evolutek/carte-io-raspberry-pi/CarteIO Beacon V1/Board.step

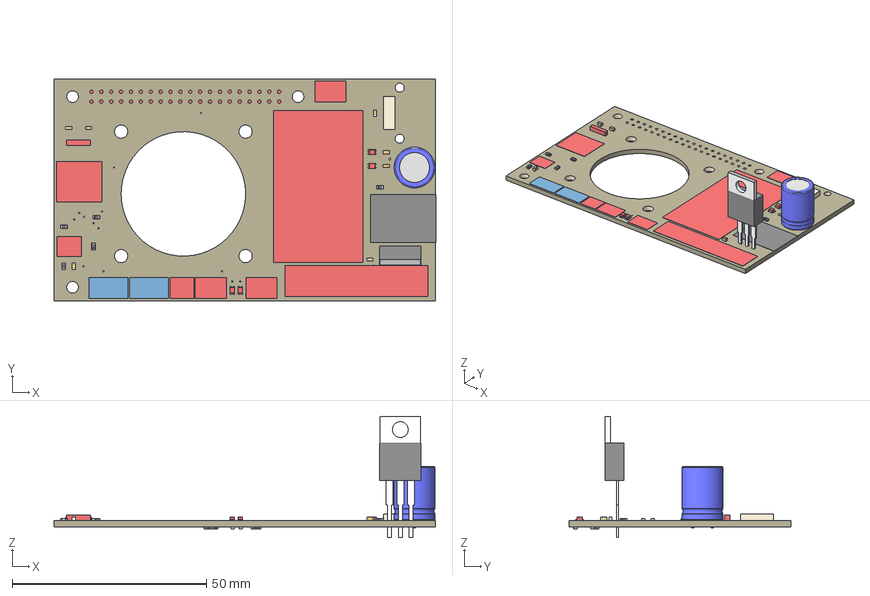
[picture p1: CAD file, 2020-09-04, an earlier design]
CarteIO Beacon V1/Board.step
98.2 x 57.0 x 31.2 mm
Board
GREEN x 4
330uF
100nF x 5
FUSE
JST2
JST4 x 2
JST3 x 3
16MHz
J1
PTN78020WAD
MCP2515-I/SO
MCP2551-I/SN
PN87520
MBR60H100CTG
