evolutek/carte-io-raspberry-pi/Carte IO Coffee Pot V1/Output/Schematics.pdf

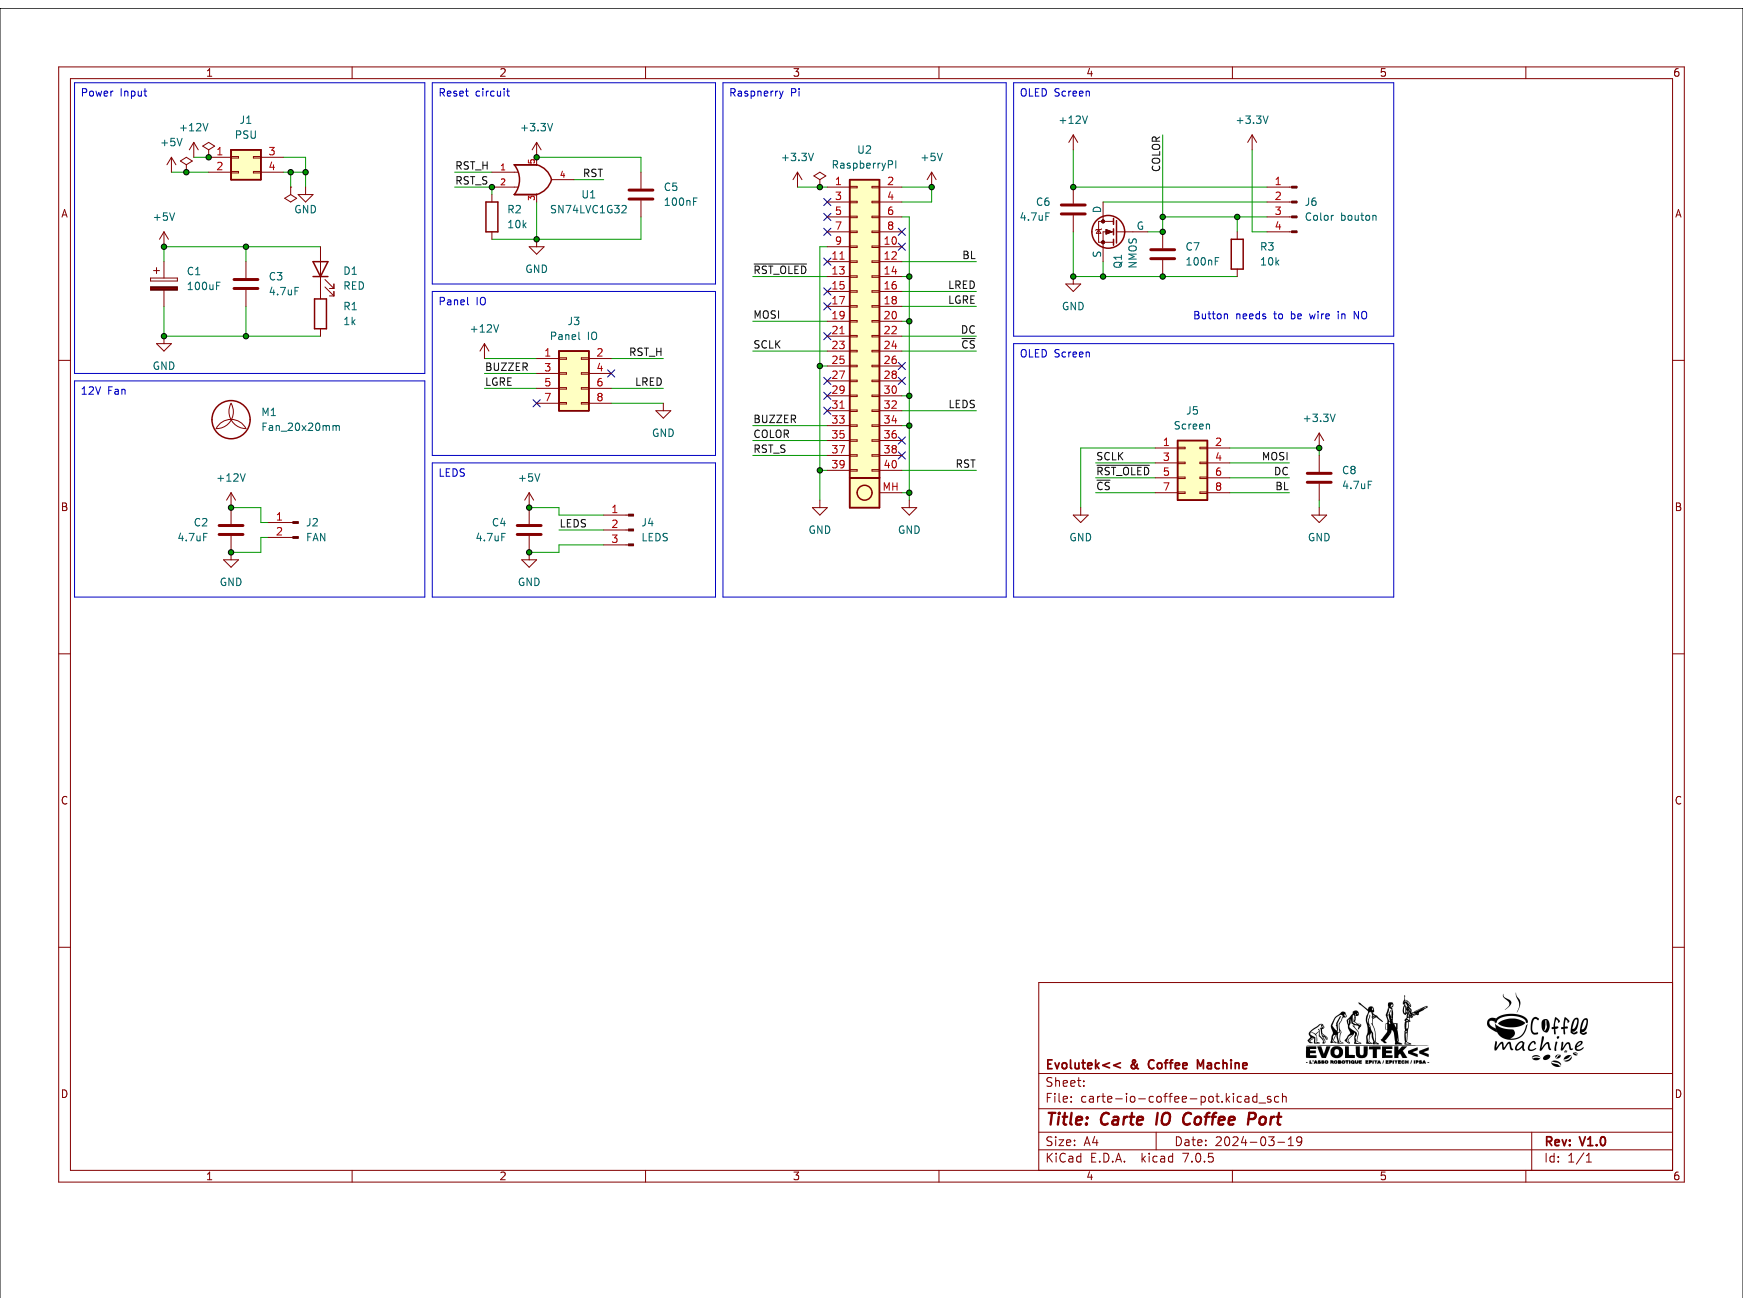
[picture p2: page 1]
