evolutek/carte-io-raspberry-pi/CarteIO V6/Output/Schematics.pdf

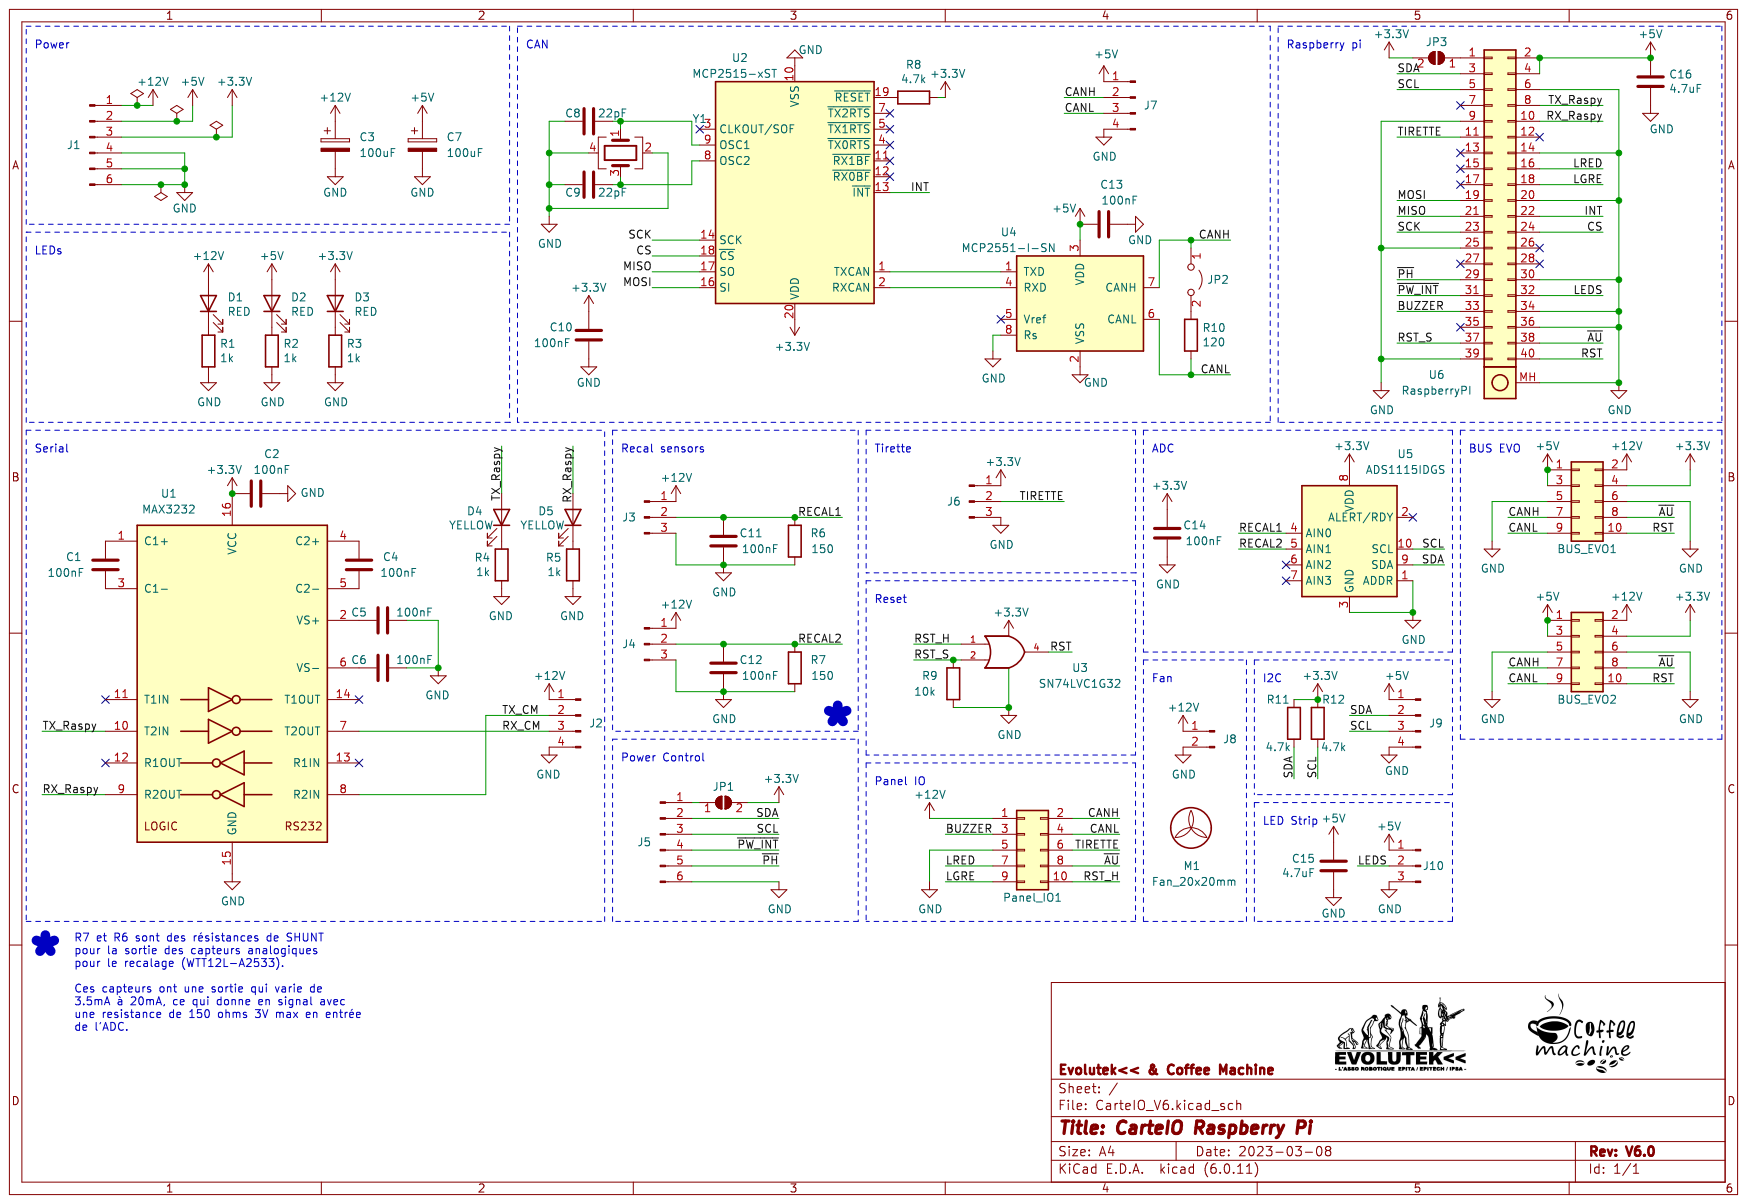
[picture p3: page 1]
