evolutek/carte-io-raspberry-pi/Carte IO Coffee Pot V1/Output/Board-Front.pdf

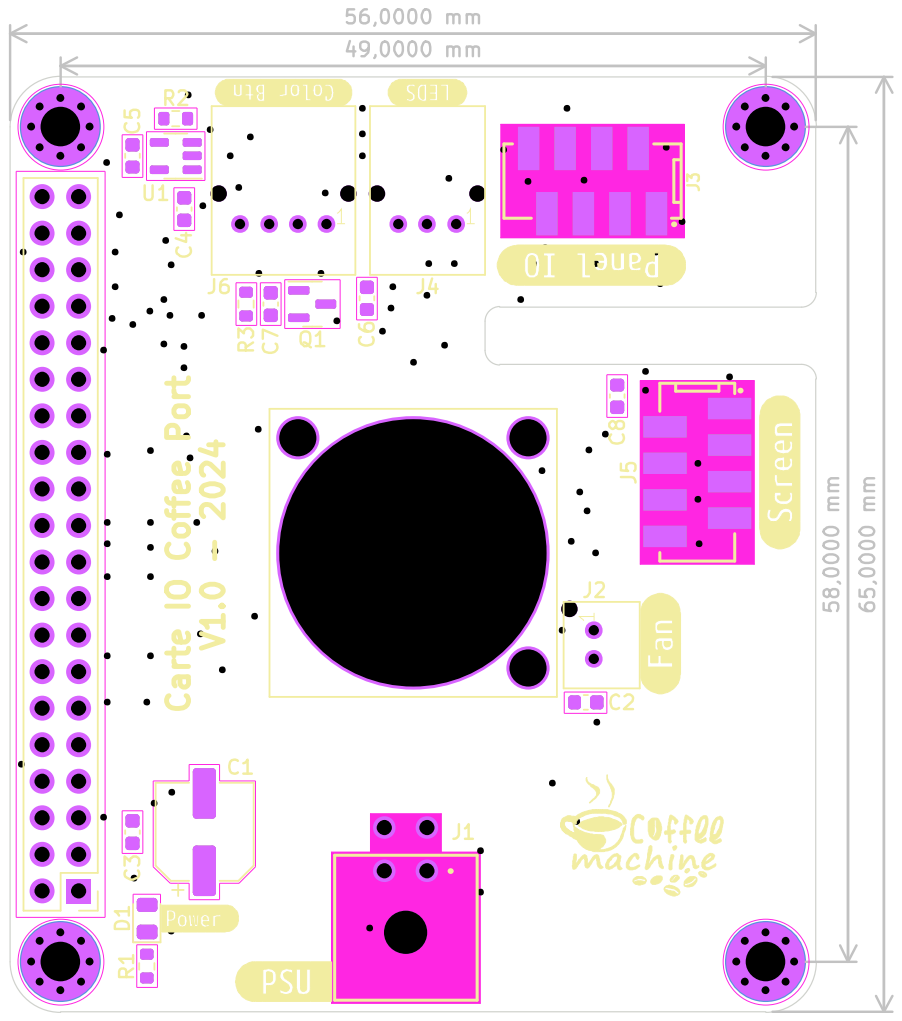
[picture p4: page 1]
