evolutek/carte-io-raspberry-pi/CarteIO V6/Output/Board-Back.pdf

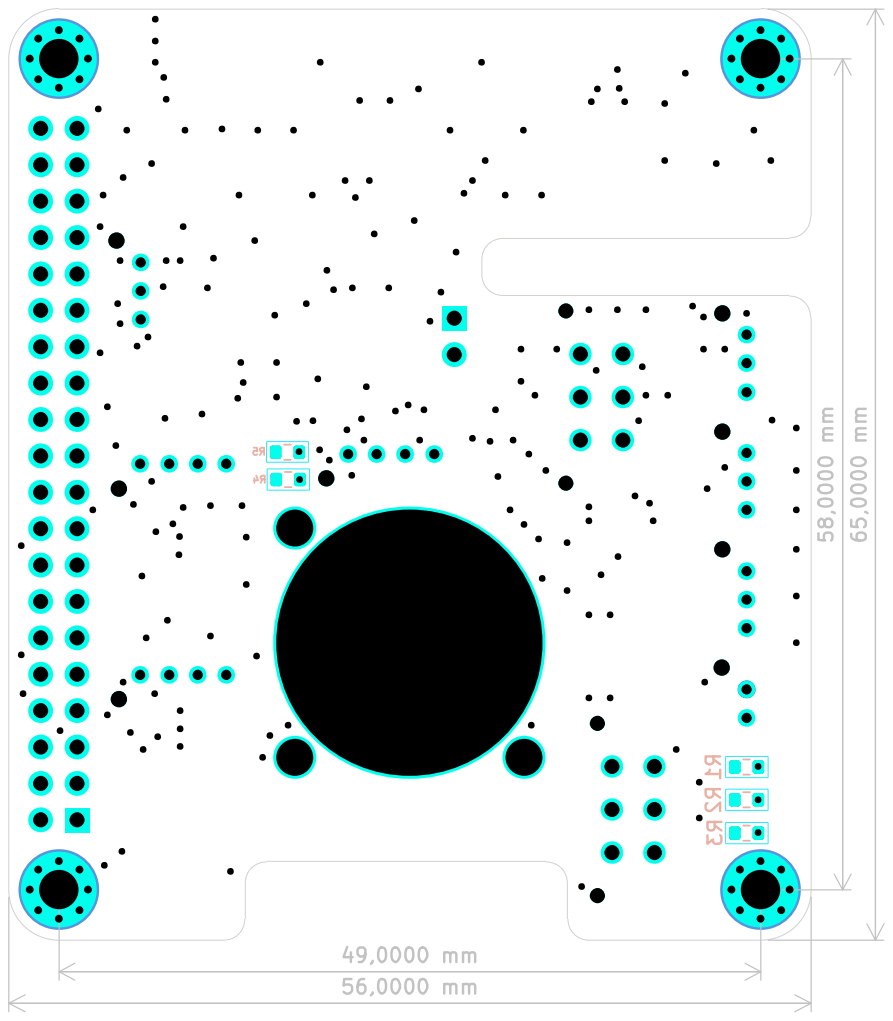
[picture p5: page 1]
