evolutek/carte-io-raspberry-pi/CarteIO Beacon V1/Schematics.pdf

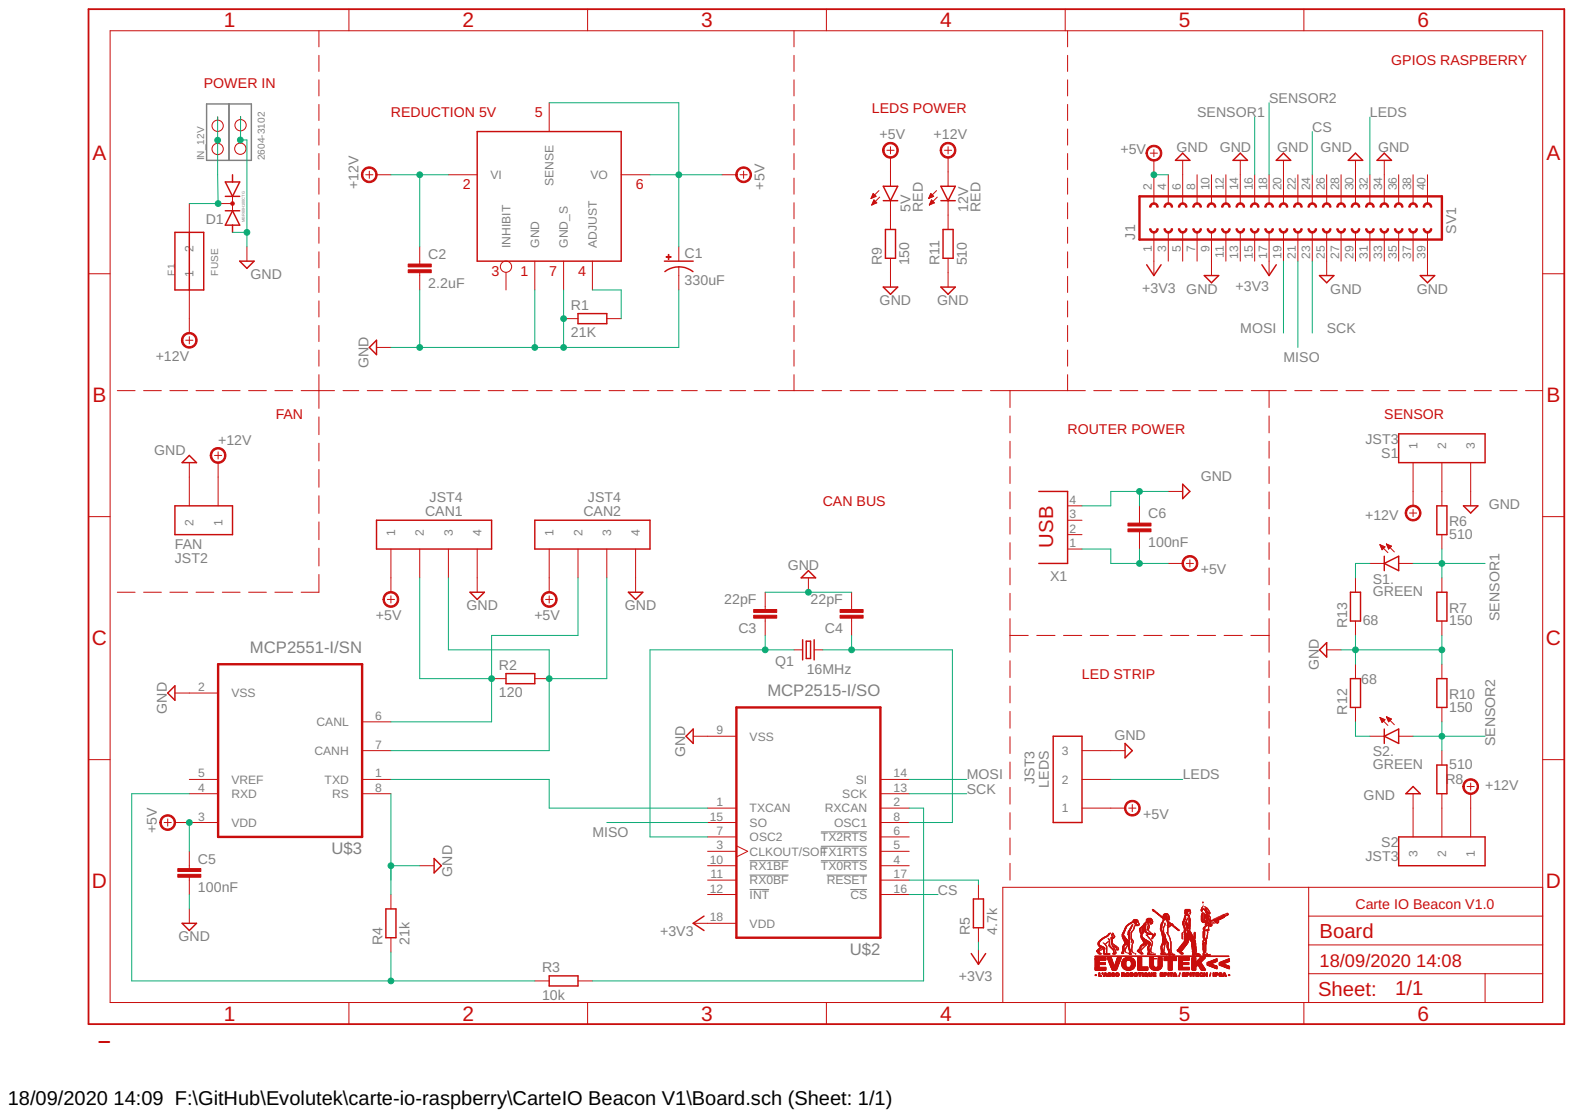
[picture p6: page 1]

SENSOR2

J1 GND GND GND GND

18/09/2020 14:09 F:\GitHub\Evolutek\carte-io-raspberry\CarteIO Beacon V1\Board.sch (Sheet: 1/1)
