evolutek/carte-io-raspberry-pi/CarteIO V3/Schematics.pdf

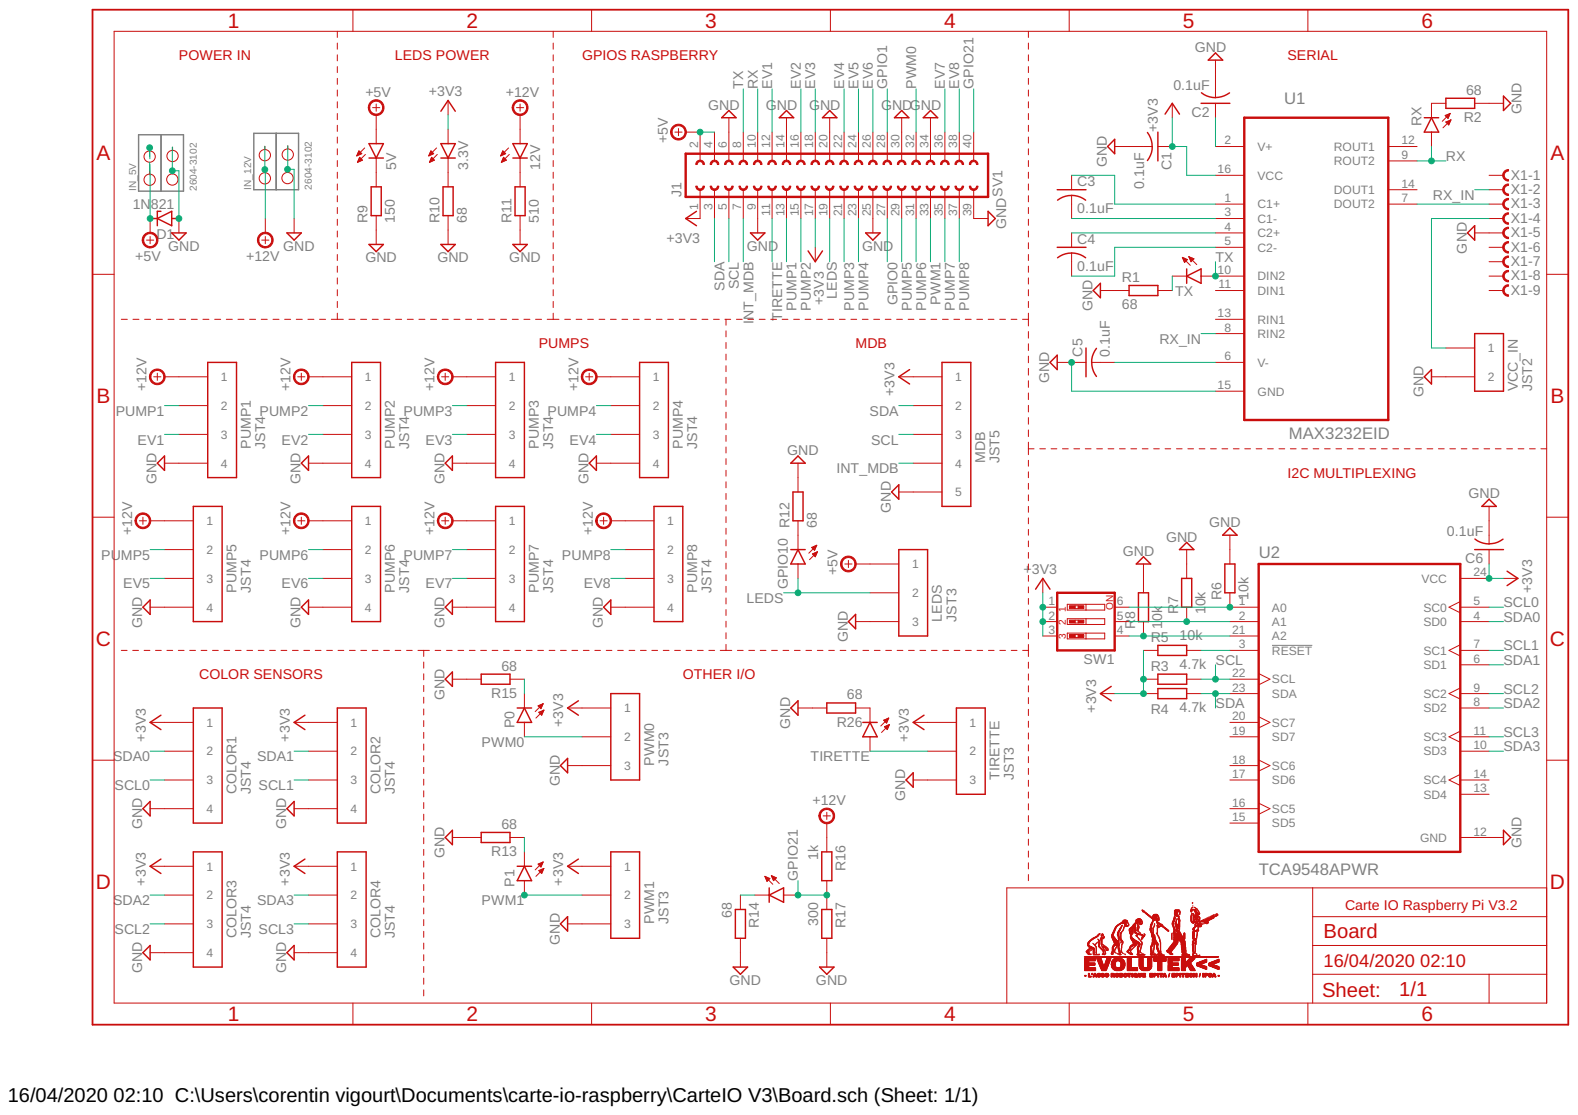
[picture p7: page 1]

GND POWER IN LEDS POWER GPIOS RASPBERRY | SERIAL

16/04/2020 02:10 C:\Users\corentin vigourt\Documents\carte-io-raspberry\CarteIO V3\Board.sch (Sheet: 1/1)
