evolutek/carte-io-raspberry-pi/CarteIO V2/Documentation/Schematics.pdf

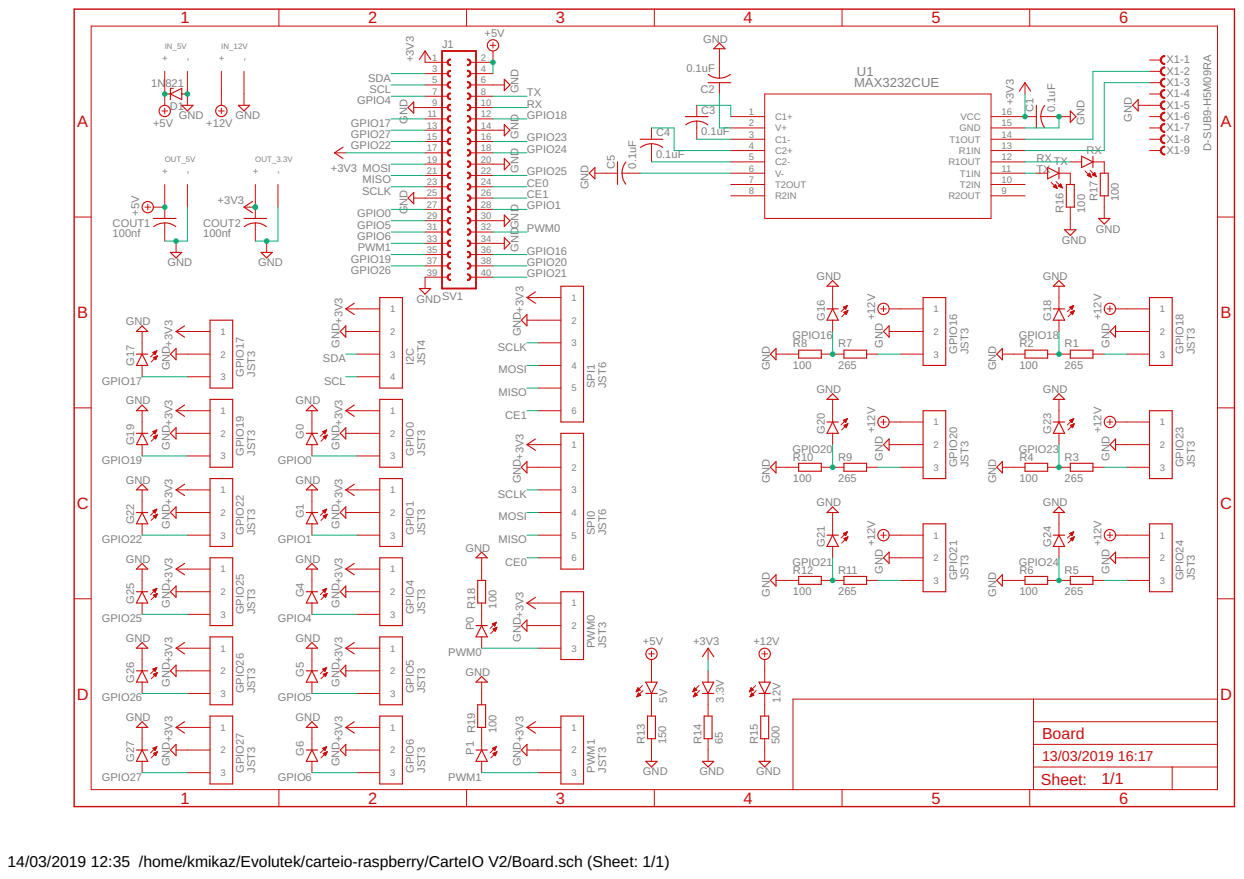
[picture p8: page 1]

GND GND

14/03/2019 12:35 /home/kmikaz/Evolutek/carteio-raspberry/CarteIO V2/Board.sch (Sheet: 1/1)
