evolutek/carte-io-raspberry-pi/CarteIO Beacon V1/Board.pdf

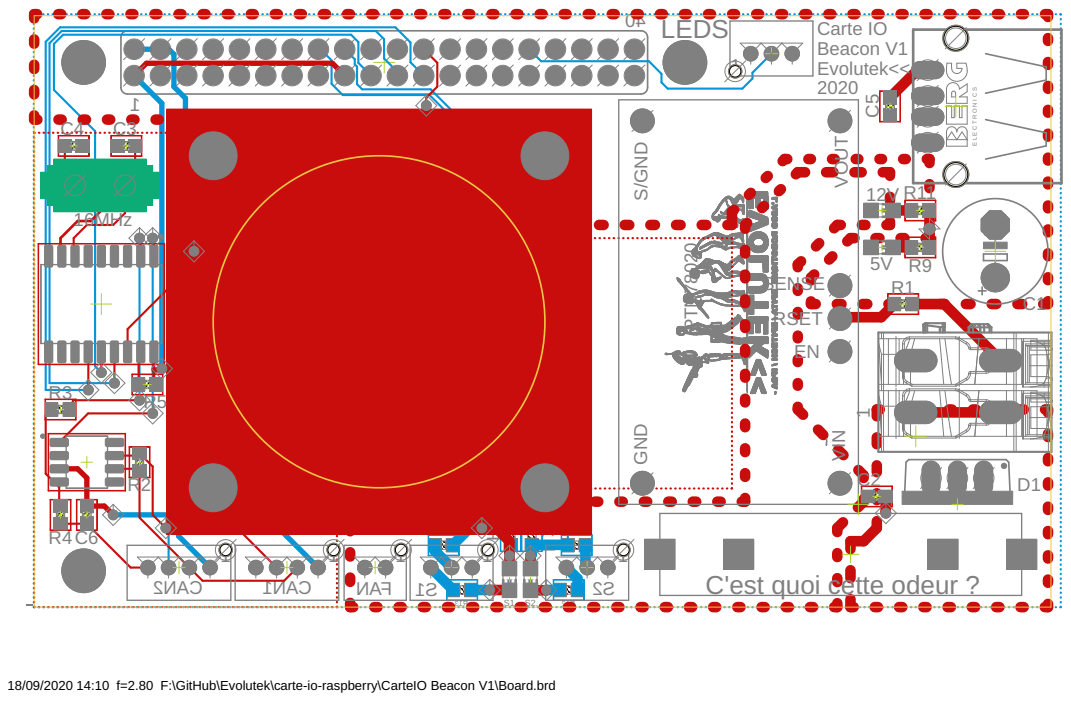
[picture p9: page 1]

C'est quoi cette odeur ?

18/09/2020 14:10 f=2.80 F:\GitHub\Evolutek\carte-io-raspberry\CarteIO Beacon V1\Board.brd
