evolutek/carte-io-raspberry-pi/CarteIO V3/Board.pdf

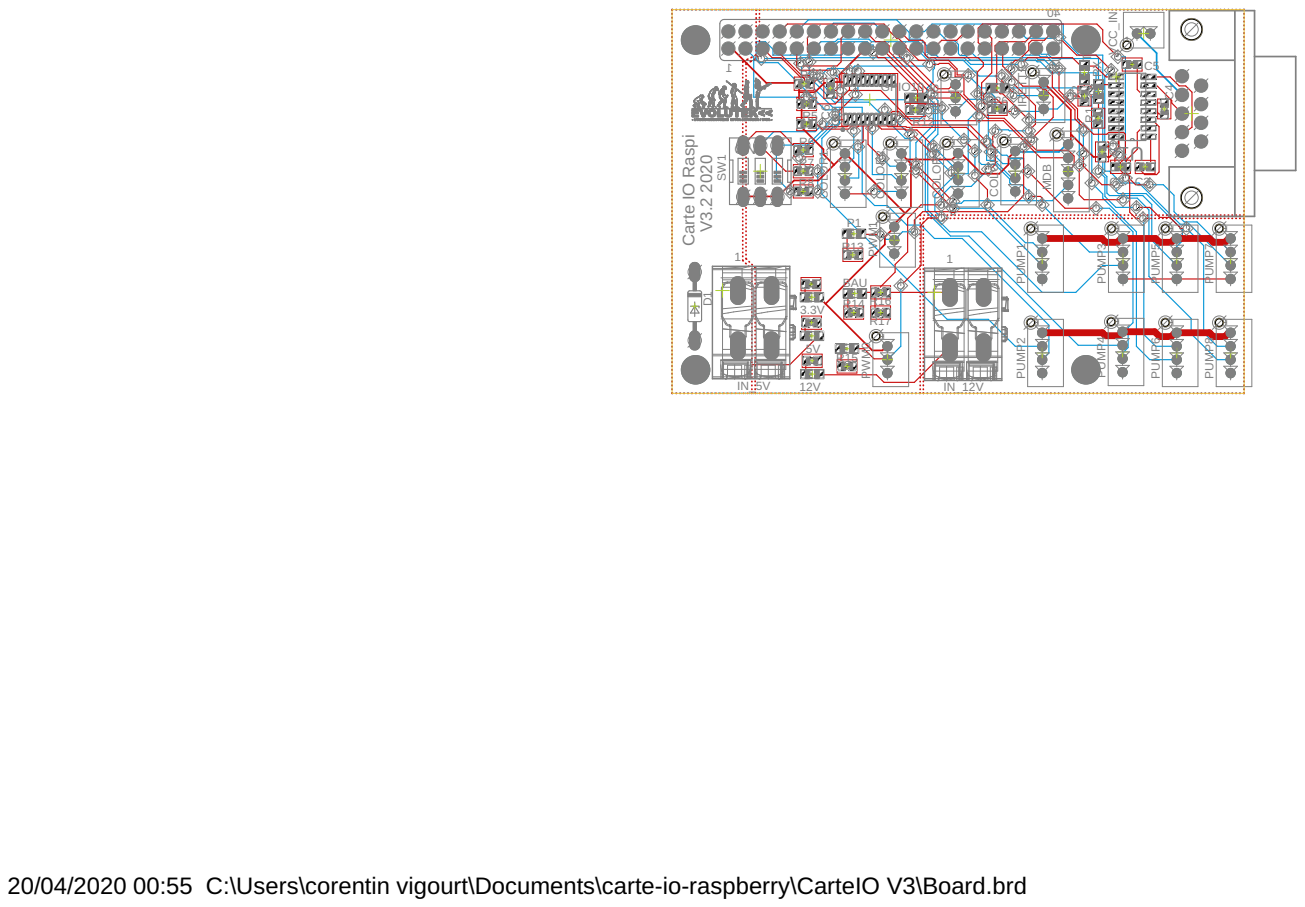
[picture p10: page 1]

20/04/2020 00:55 C:\Users\corentin vigourt\Documents\carte-io-raspberry\CarteIO V3\Board.brd
