evolutek/carte-io-raspberry-pi/CarteIO Beacon V2/Schematics.pdf

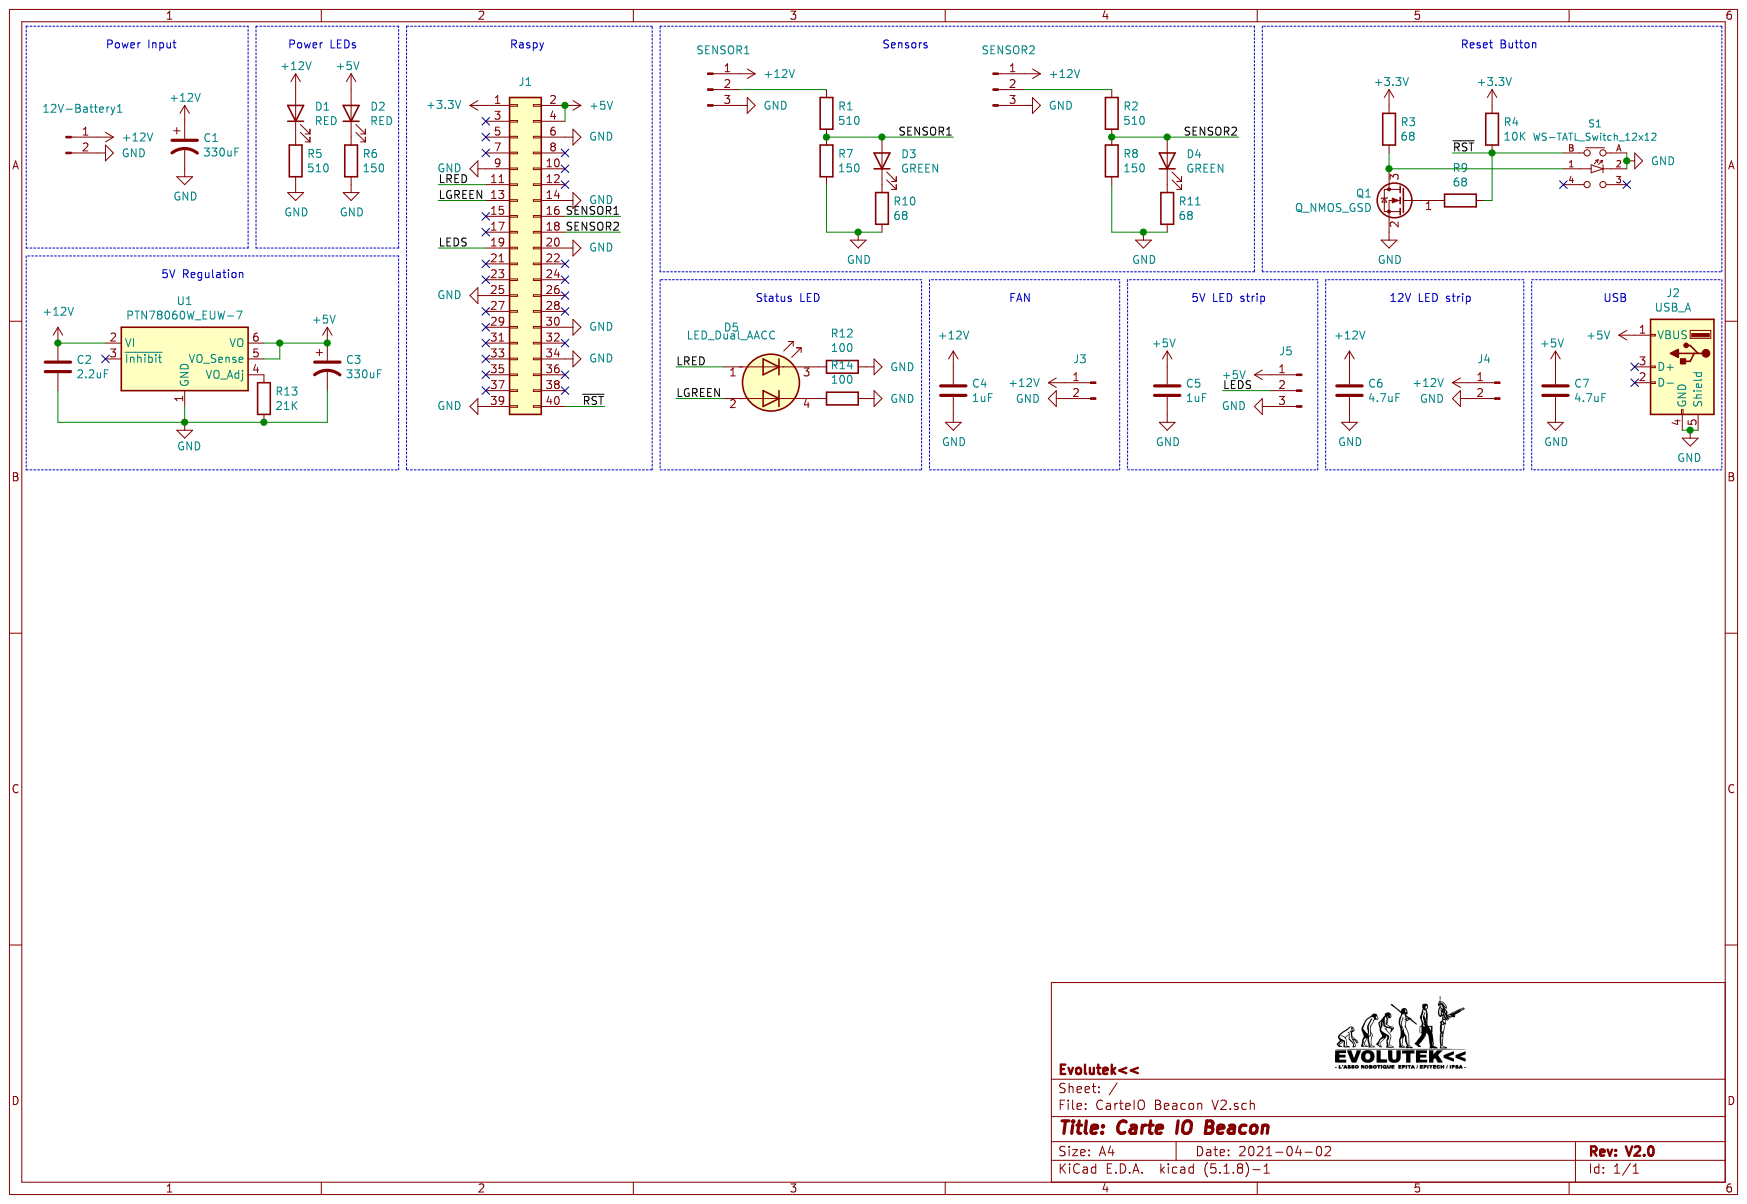
[picture p11: page 1]
