evolutek/carte-io-raspberry-pi/CarteIO V4/Schematics.pdf

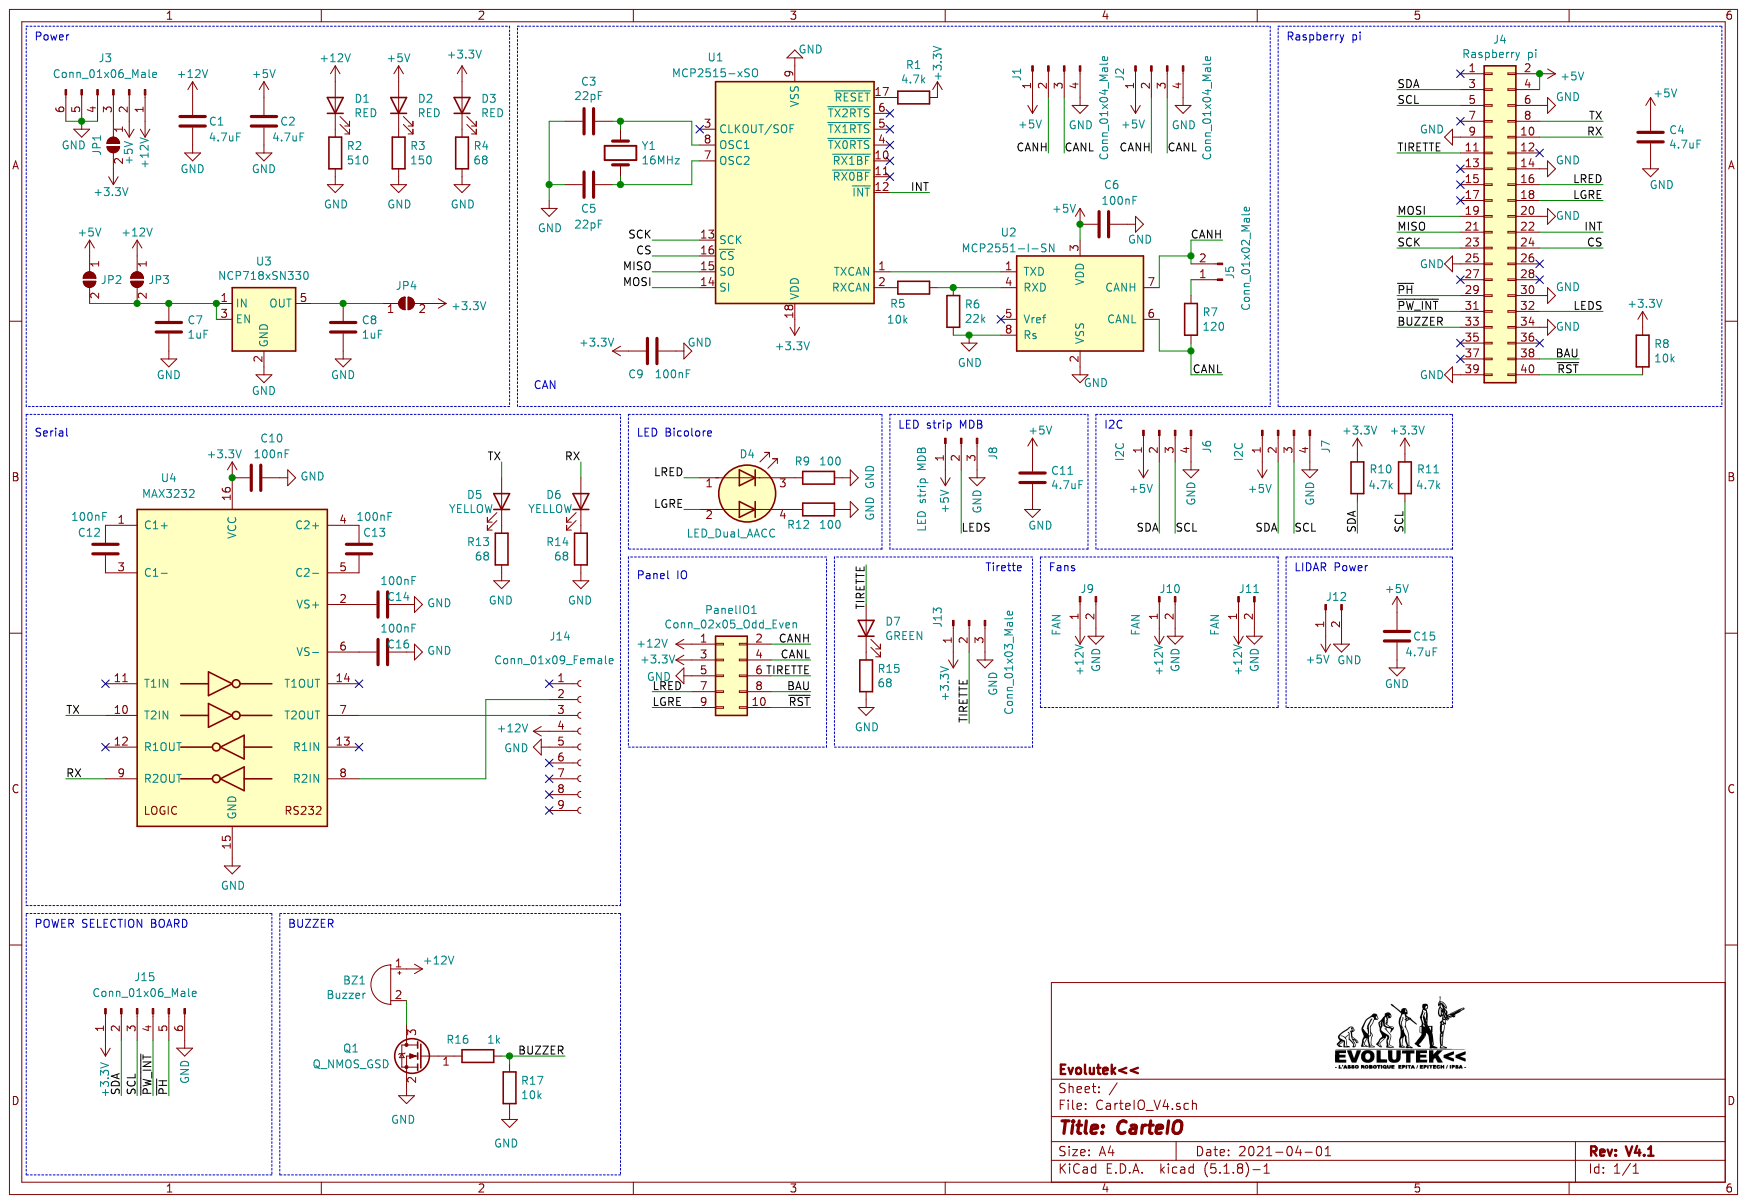
[picture p12: page 1]
