evolutek/carte-io-raspberry-pi/CarteIO Beacon V3/Output/Schematics.pdf

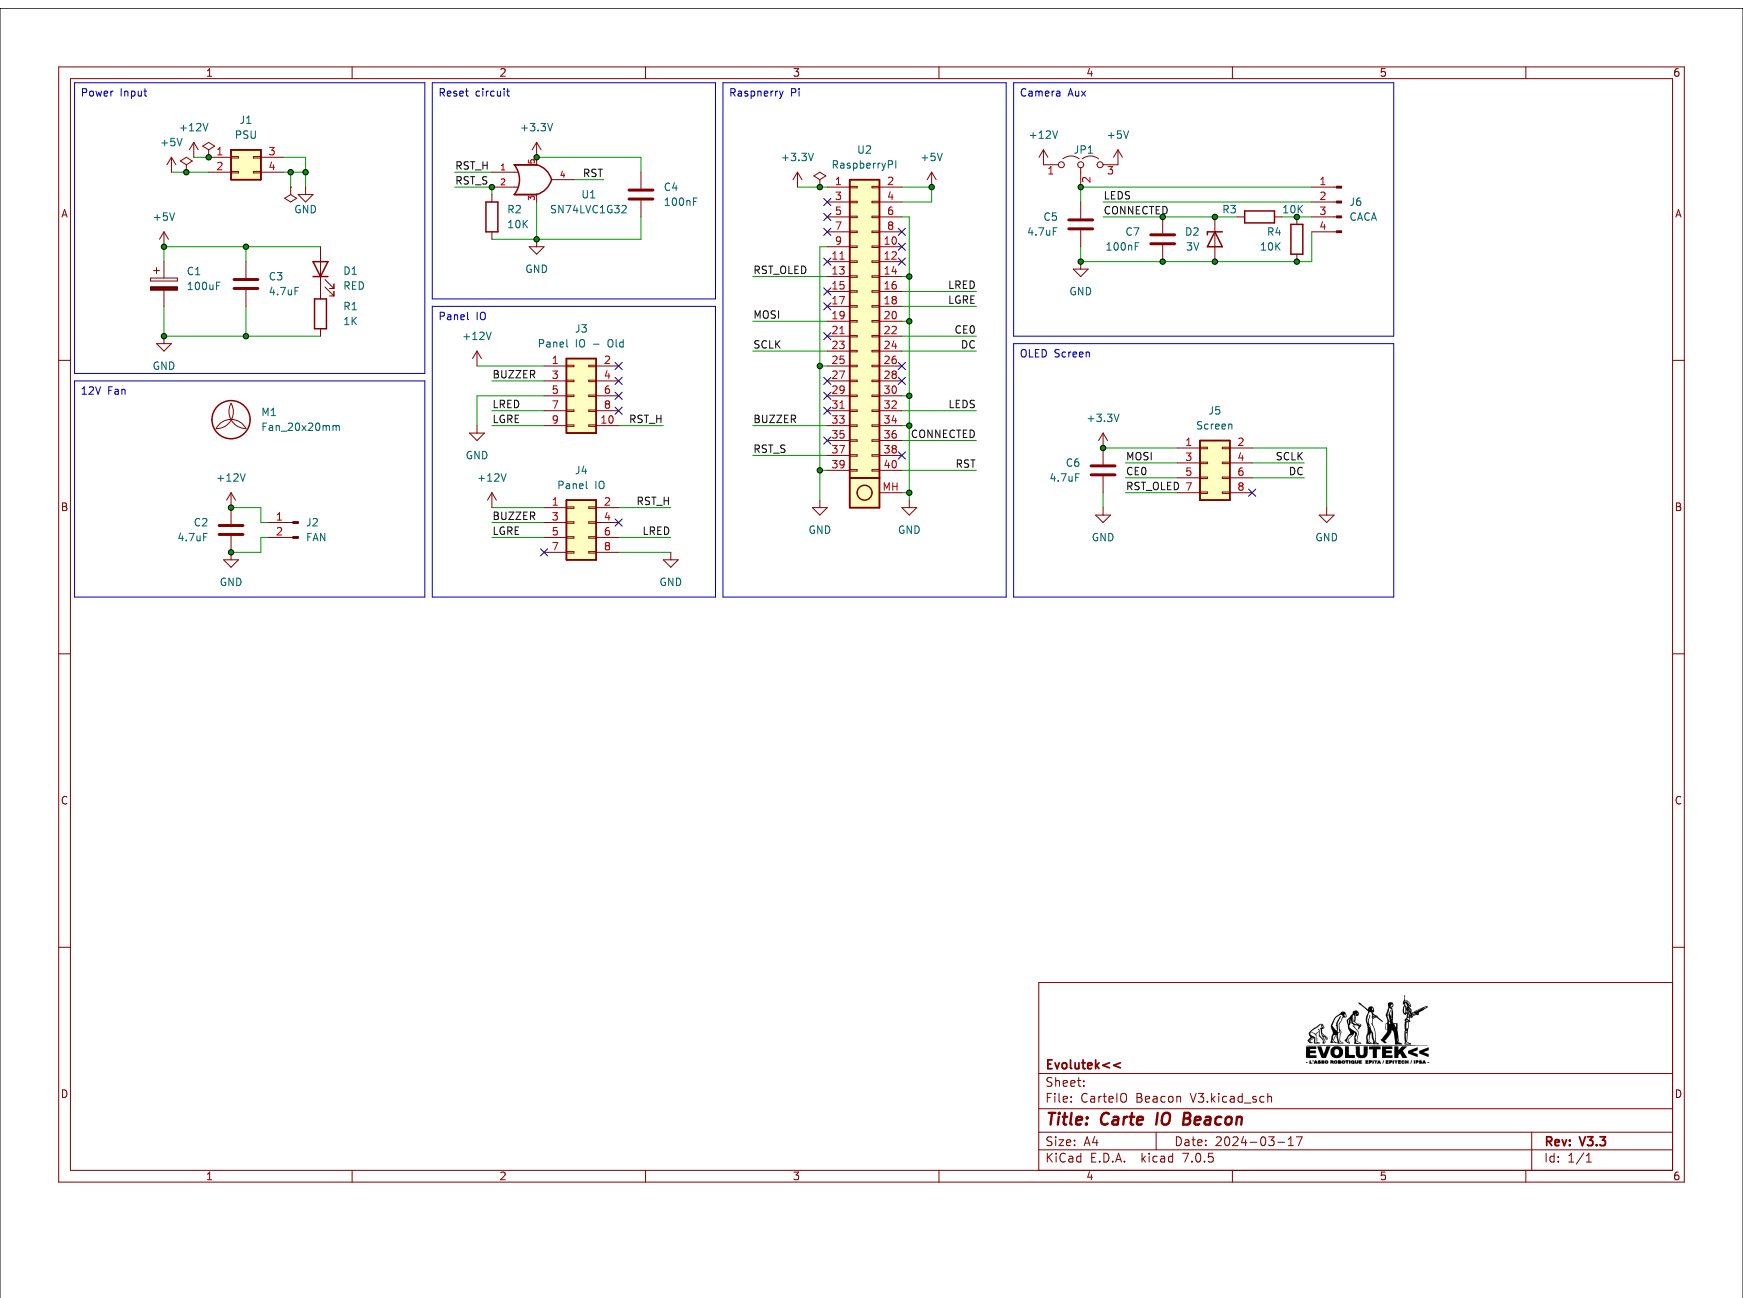
[picture p13: page 1]
