evolutek/carte-io-raspberry-pi/CarteIO V5/Output/Schematics.pdf

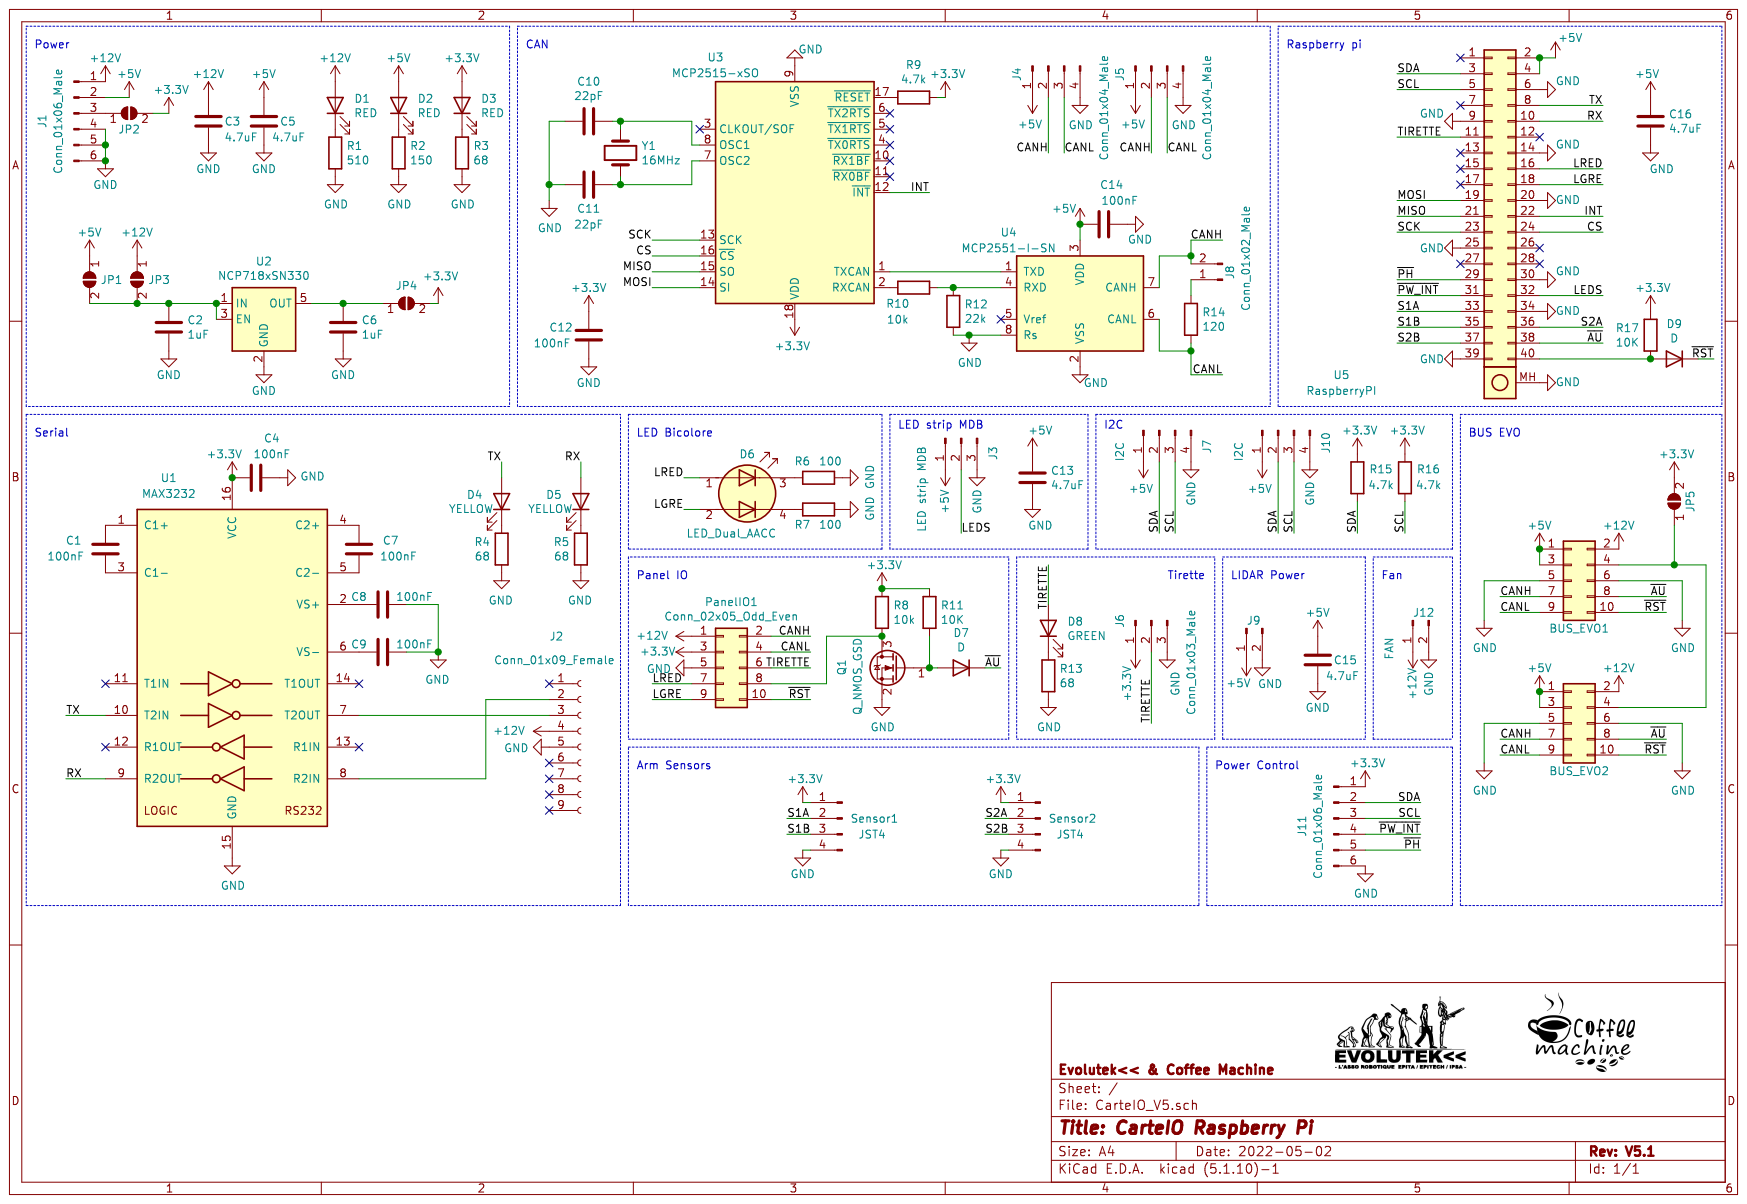
[picture p14: page 1]
