evolutek/carte-io-raspberry-pi/CarteIO Beacon V3/Output/Board-Front.pdf

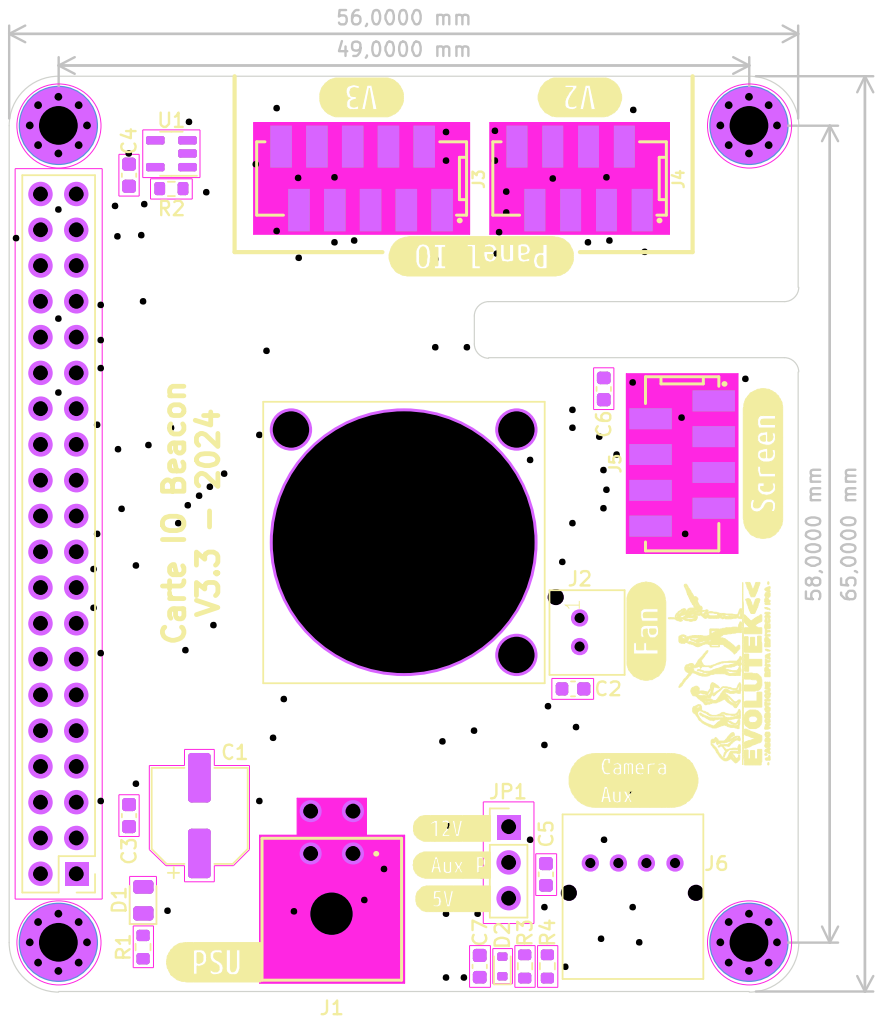
[picture p15: page 1]
