evolutek/carte-io-raspberry-pi/CarteIO V5/Output/Board-Back.pdf

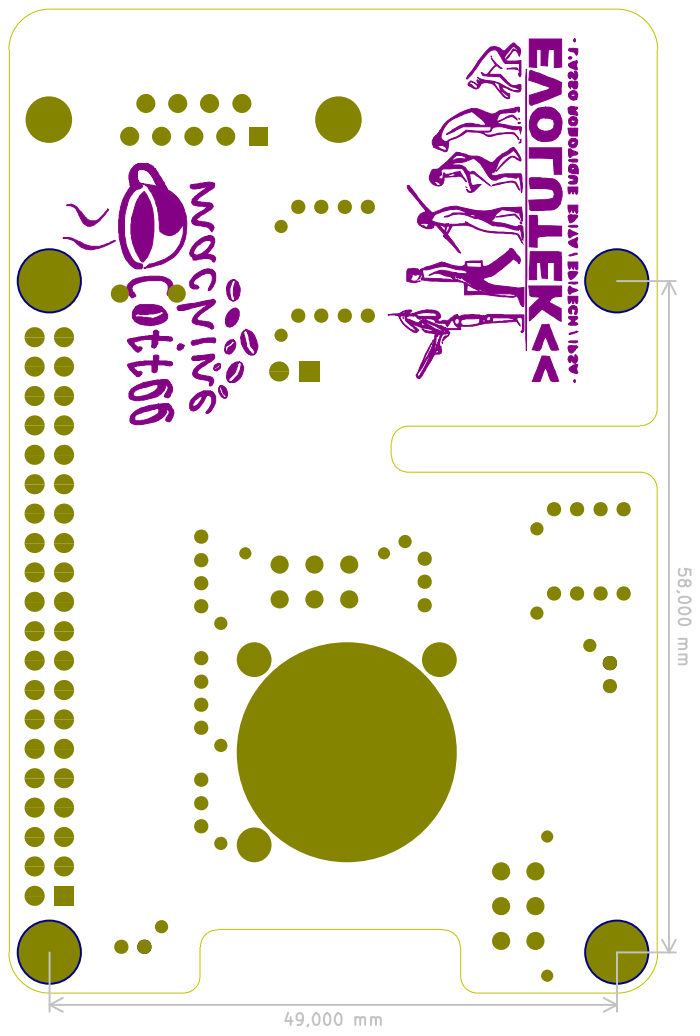
[picture p16: page 1]
