evolutek/carte-io-raspberry-pi/CarteIO V5/Output/Board-Front.pdf

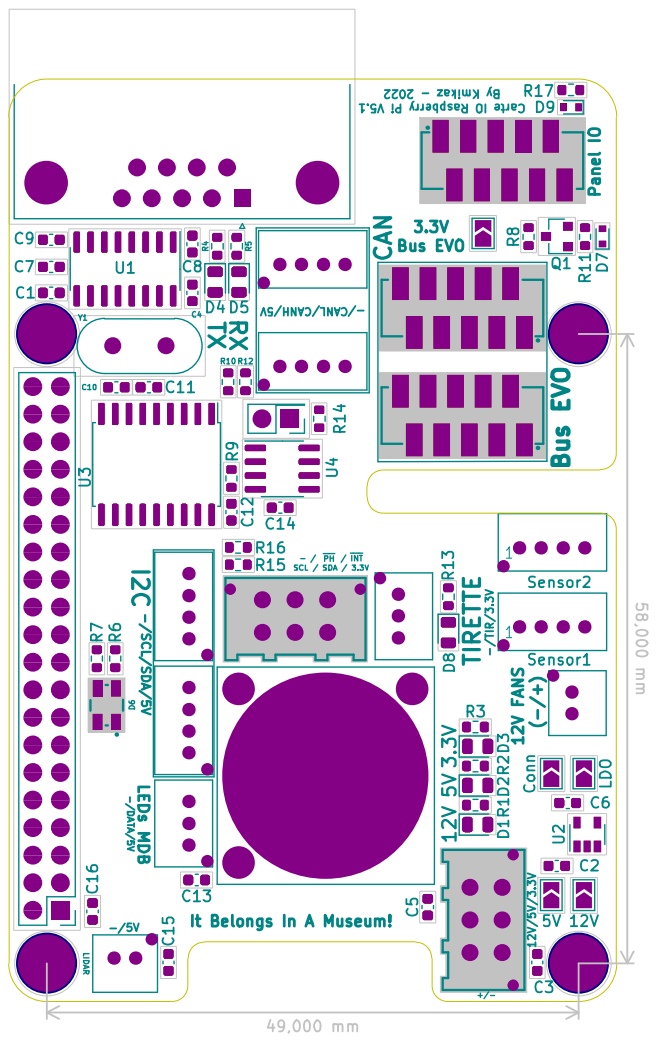
[picture p17: page 1]
