evolutek/carte-io-raspberry-pi/Carte IO Coffee Pot V1/carte-io-coffee-pot.kicad_pcb

## KiCad design Carte IO Coffee Pot V1/carte-io-coffee-pot.kicad_pcb (2024-12-13)

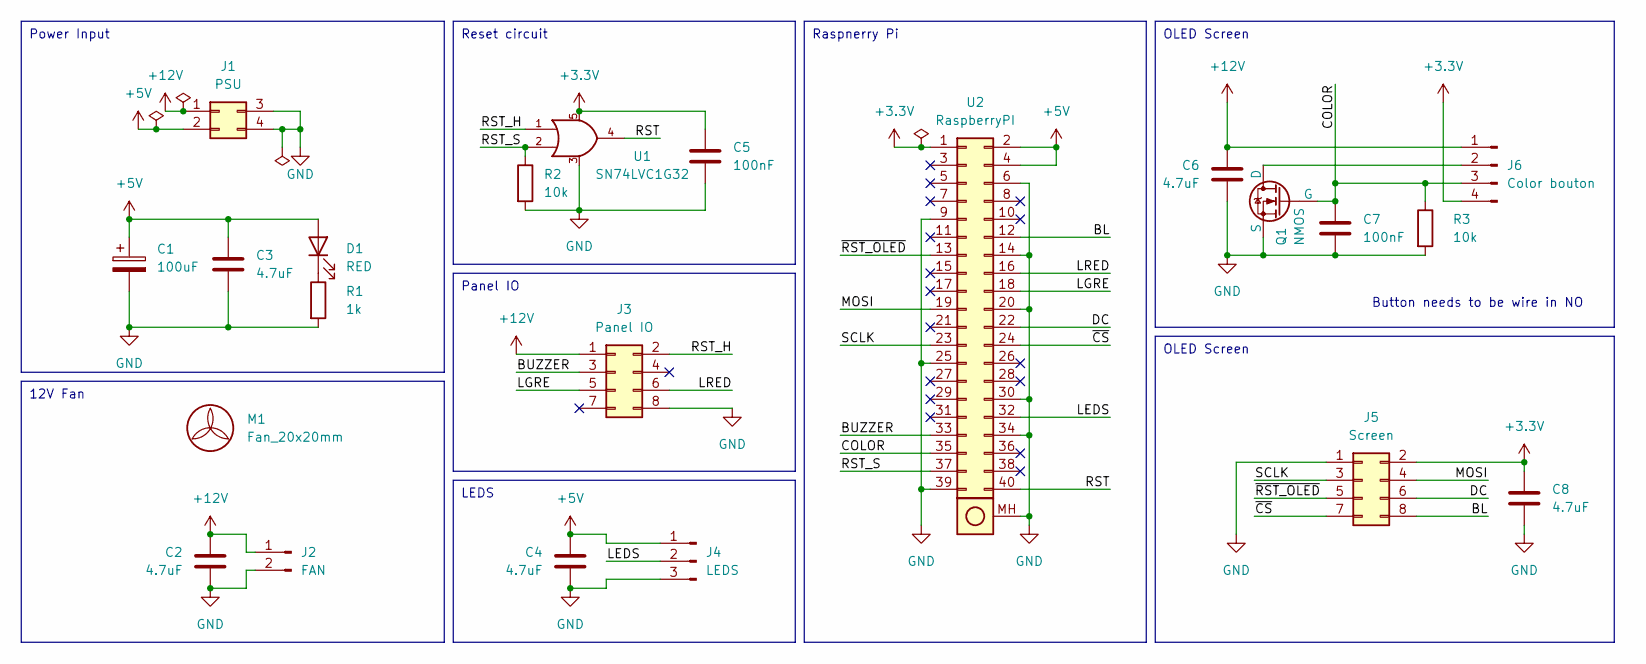
[picture p18: schematic carte-io-coffee-pot.kicad_sch, Carte IO Coffee Port]

Parts:
C1: 100uF; CP_Elec_6.3x7.7
C2, C3, C4, C6, C8: 4.7uF; C_0603_1608Metric
C5, C7: 100nF; C_0603_1608Metric
D1: RED; D_0805_2012Metric
J1: PSU; 66200421022
J2: FAN; B02B-PASK
J3: Panel IO; 690367280876
J4: LEDS; S03B-PASK
J5: Screen; 690367280876
J6: Color bouton; S04B-PASK
M1: Fan_20x20mm; 20x20x10_DC_FAN
Q1: NMOS; SOT-23
R1: 1k; R_0603_1608Metric
R2, R3: 10k; R_0603_1608Metric
U1: SN74LVC1G32; SOT-23-5
U2: RaspberryPI; Shield_Raspberry_Pi_with_11mm_Header

Connections:
+3.3V: C5.2, C8.2, J5.2, J6.4, U1.5 (VCC), U2.1
+5V: C1.1, C3.2, C4.2, D1.2 (A), J1.2, J4.1, U2.2, U2.4
+12V: C2.2, C6.2, J1.1, J2.1, J3.1, J6.1
/BL: J5.8, U2.12
/BUZZER: J3.3, U2.33
/COLOR: C7.2, J6.3, Q1.2 (G), R3.1, U2.35
/DC: J5.6, U2.22
/LEDS: J4.2, U2.32
/LGRE: J3.5, U2.18
/LRED: J3.6, U2.16
/MOSI: J5.4, U2.19
/RST: U1.4 (S), U2.40
/RST_H: J3.2, U1.1 (A)
/RST_S: R2.1, U1.2 (B), U2.37
/SCLK: J5.3, U2.23
/~CS: J5.7, U2.24
/~RST_OLED: J5.5, U2.13
GND: C1.2, C2.1, C3.1, C4.1, C5.1, C6.1, C7.1, C8.1, J1.3, J1.4, J2.2, J3.8, J4.3, J5.1, Q1.3 (S), R1.2, R2.2, R3.2, U1.3 (GND), U2.6, U2.9, U2.14, U2.20, U2.25, U2.30, U2.34, U2.39, U2.MH (MountingHoles)
unnamed: D1.1 (K), R1.1
unnamed: J6.2, Q1.1 (D)

Notes on the sheet:
Reset circuit
LEDS
OLED Screen
12V Fan
Power Input
Panel IO
Raspnerry Pi
Button needs to be wire in NO

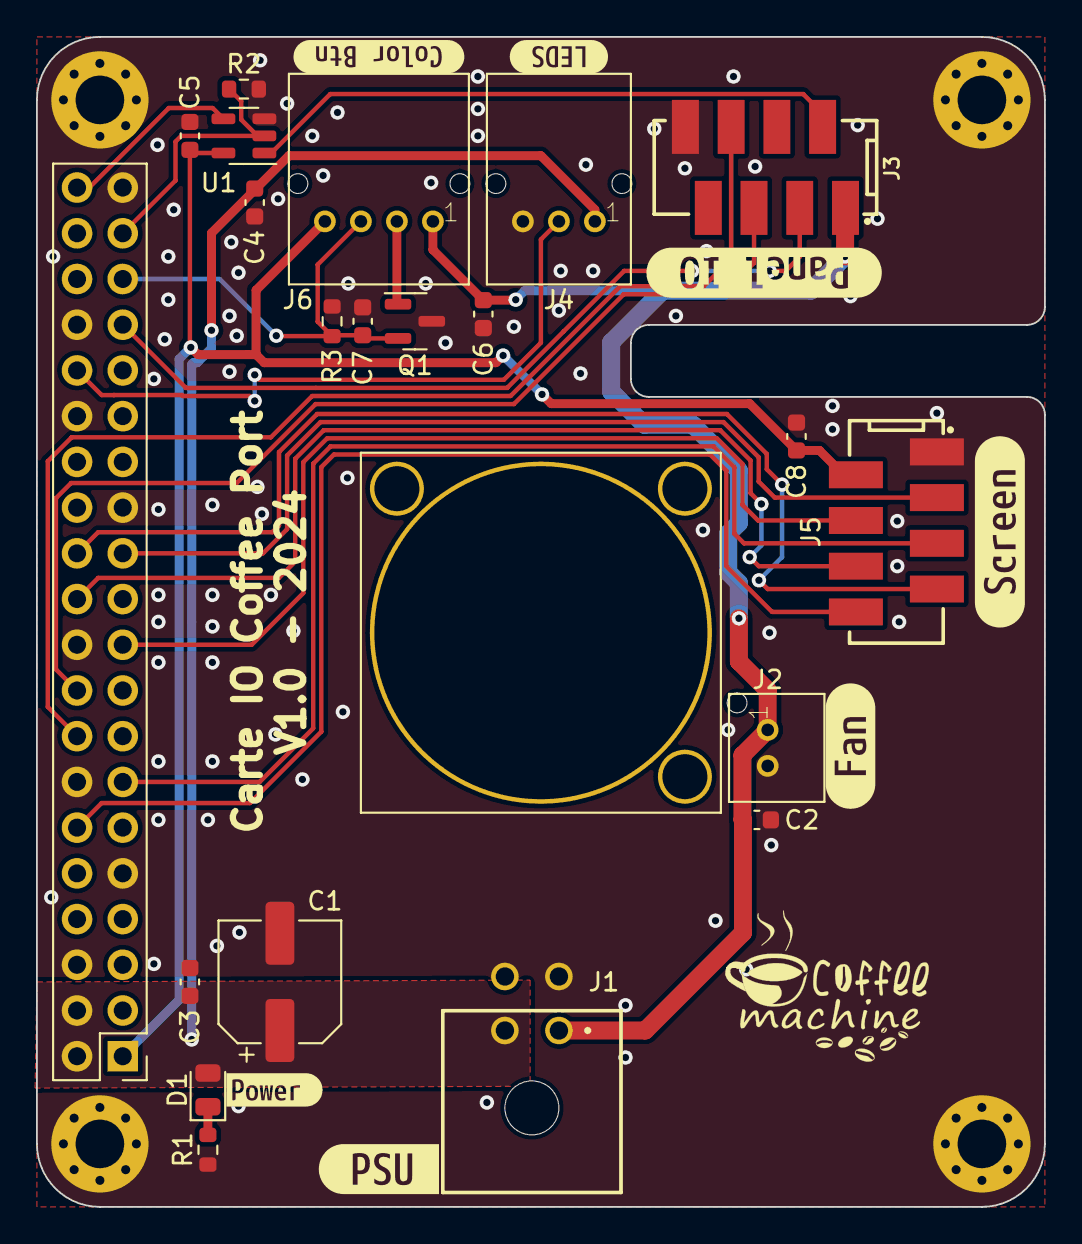
[picture p19: board carte-io-coffee-pot.kicad_pcb from above]

Board: 2 copper layers, 56.0 x 65.0 mm, 29 parts (0 on the bottom side), 20 nets.

Other parts of the board:
kibuzzard-65F8CF4B: G***; kibuzzard-65F8CF4B
kibuzzard-65F8CFA1: G***; kibuzzard-65F8CFA1
kibuzzard-65F8CFB9: G***; kibuzzard-65F8CFB9
kibuzzard-65F478A9: G***; kibuzzard-65F478A9
kibuzzard-65F478C7: G***; kibuzzard-65F478C7
kibuzzard-65F478FE: G***; kibuzzard-65F478FE
kibuzzard-65F47805: G***; kibuzzard-65F47805
