evolutek/carte-io-raspberry-pi/CarteIO Beacon V3/CarteIO Beacon V3.kicad_pcb

## KiCad design CarteIO Beacon V3/CarteIO Beacon V3.kicad_pcb (2024-08-19)

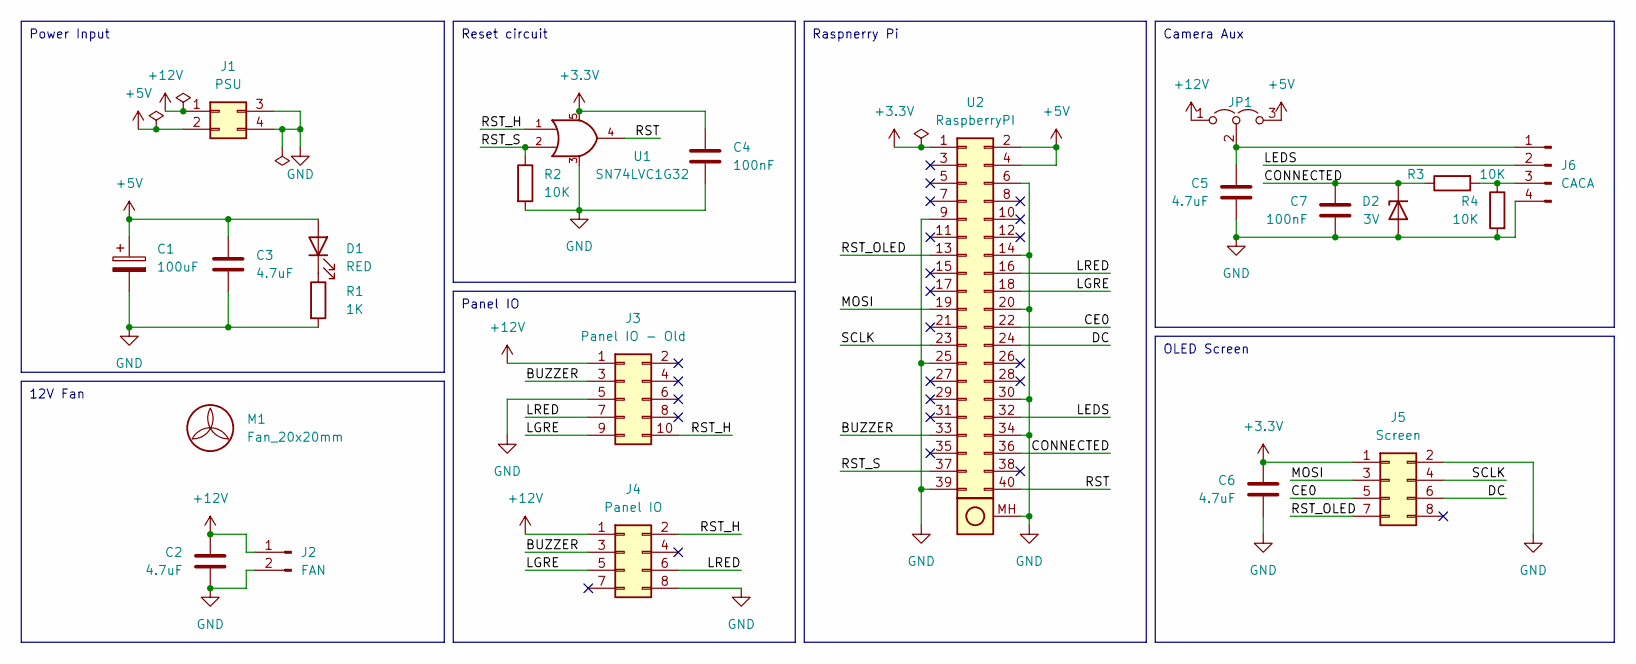
[picture p20: schematic CarteIO Beacon V3.kicad_sch, Carte IO Beacon]

Parts:
C1: 100uF; CP_Elec_6.3x7.7
C2, C3, C5, C6: 4.7uF; C_0603_1608Metric
C4, C7: 100nF; C_0603_1608Metric
D1: RED; D_0805_2012Metric
D2: 3V; D_SOD-523
J1: PSU; 66200421022
J2: FAN; B02B-PASK
J3: Panel IO - Old; 690367281076
J4: Panel IO; 690367280876
J5: Screen; 690367280876
J6: CACA; S04B-PASK
JP1: Jumper_3_Open; PinHeader_1x03_P2.54mm_Vertical
M1: Fan_20x20mm; 20x20x10_DC_FAN
R1: 1K; R_0603_1608Metric
R2, R3, R4: 10K; R_0603_1608Metric
U1: SN74LVC1G32; SOT-23-5
U2: RaspberryPI; Shield_Raspberry_Pi_with_11mm_Header

Connections:
+3.3V: C4.2, C6.2, J5.1, U1.5 (VCC), U2.1
+5V: C1.1, C3.2, D1.2 (A), J1.2, JP1.3 (B), U2.2, U2.4
+12V: C2.2, J1.1, J2.1, J3.1, J4.1, JP1.1 (A)
/BUZZER: J3.3, J4.3, U2.33
/CE0: J5.5, U2.22
/CONNECTED: C7.2, D2.1 (K), R3.1, U2.36
/DC: J5.6, U2.24
/LEDS: J6.2, U2.32
/LGRE: J3.9, J4.5, U2.18
/LRED: J3.7, J4.6, U2.16
/MOSI: J5.3, U2.19
/RST: U1.4 (S), U2.40
/RST_H: J3.10, J4.2, U1.1 (A)
/RST_OLED: J5.7, U2.13
/RST_S: R2.1, U1.2 (B), U2.37
/SCLK: J5.4, U2.23
GND: C1.2, C2.1, C3.1, C4.1, C5.1, C6.1, C7.1, D2.2 (A), J1.3, J1.4, J2.2, J3.5, J4.8, J5.2, J6.4, R1.2, R2.2, R4.2, U1.3 (GND), U2.6, U2.9, U2.14, U2.20, U2.25, U2.30, U2.34, U2.39, U2.MH (MountingHoles)
unnamed: D1.1 (K), R1.1
unnamed: C5.2, J6.1, JP1.2 (C)
unnamed: J6.3, R3.2, R4.1

Notes on the sheet:
Reset circuit
Camera Aux
12V Fan
Power Input
OLED Screen
Panel IO
Raspnerry Pi

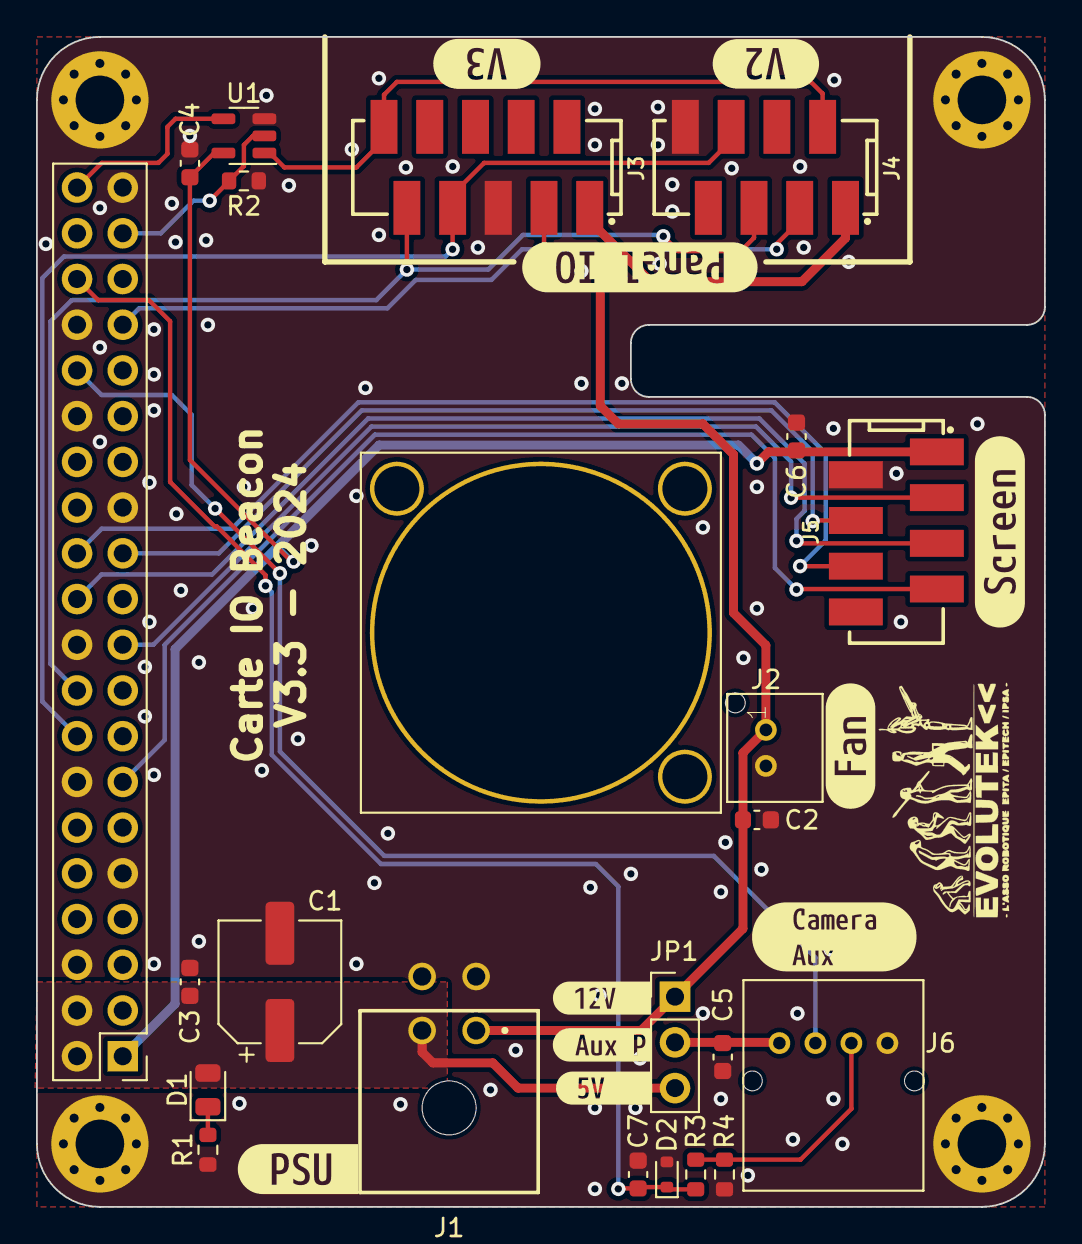
[picture p21: board CarteIO Beacon V3.kicad_pcb from above]

Board: 2 copper layers, 56.0 x 65.0 mm, 33 parts (0 on the bottom side), 20 nets.

Other parts of the board:
kibuzzard-65F47AFD: G***; kibuzzard-65F47AFD
kibuzzard-65F47B1F: G***; kibuzzard-65F47B1F
kibuzzard-65F47B56: G***; kibuzzard-65F47B56
kibuzzard-65F47B76: G***; kibuzzard-65F47B76
kibuzzard-65F478A9: G***; kibuzzard-65F478A9
kibuzzard-65F478C7: G***; kibuzzard-65F478C7
kibuzzard-65F478FE: G***; kibuzzard-65F478FE
kibuzzard-65F4786A: G***; kibuzzard-65F4786A
kibuzzard-65F47805: G***; kibuzzard-65F47805
kibuzzard-65F47874: G***; kibuzzard-65F47874
