evolutek/carte-io-raspberry-pi/CarteIO V6/CarteIO_V6.kicad_pcb

## KiCad design CarteIO V6/CarteIO_V6.kicad_pcb (2023-04-02)

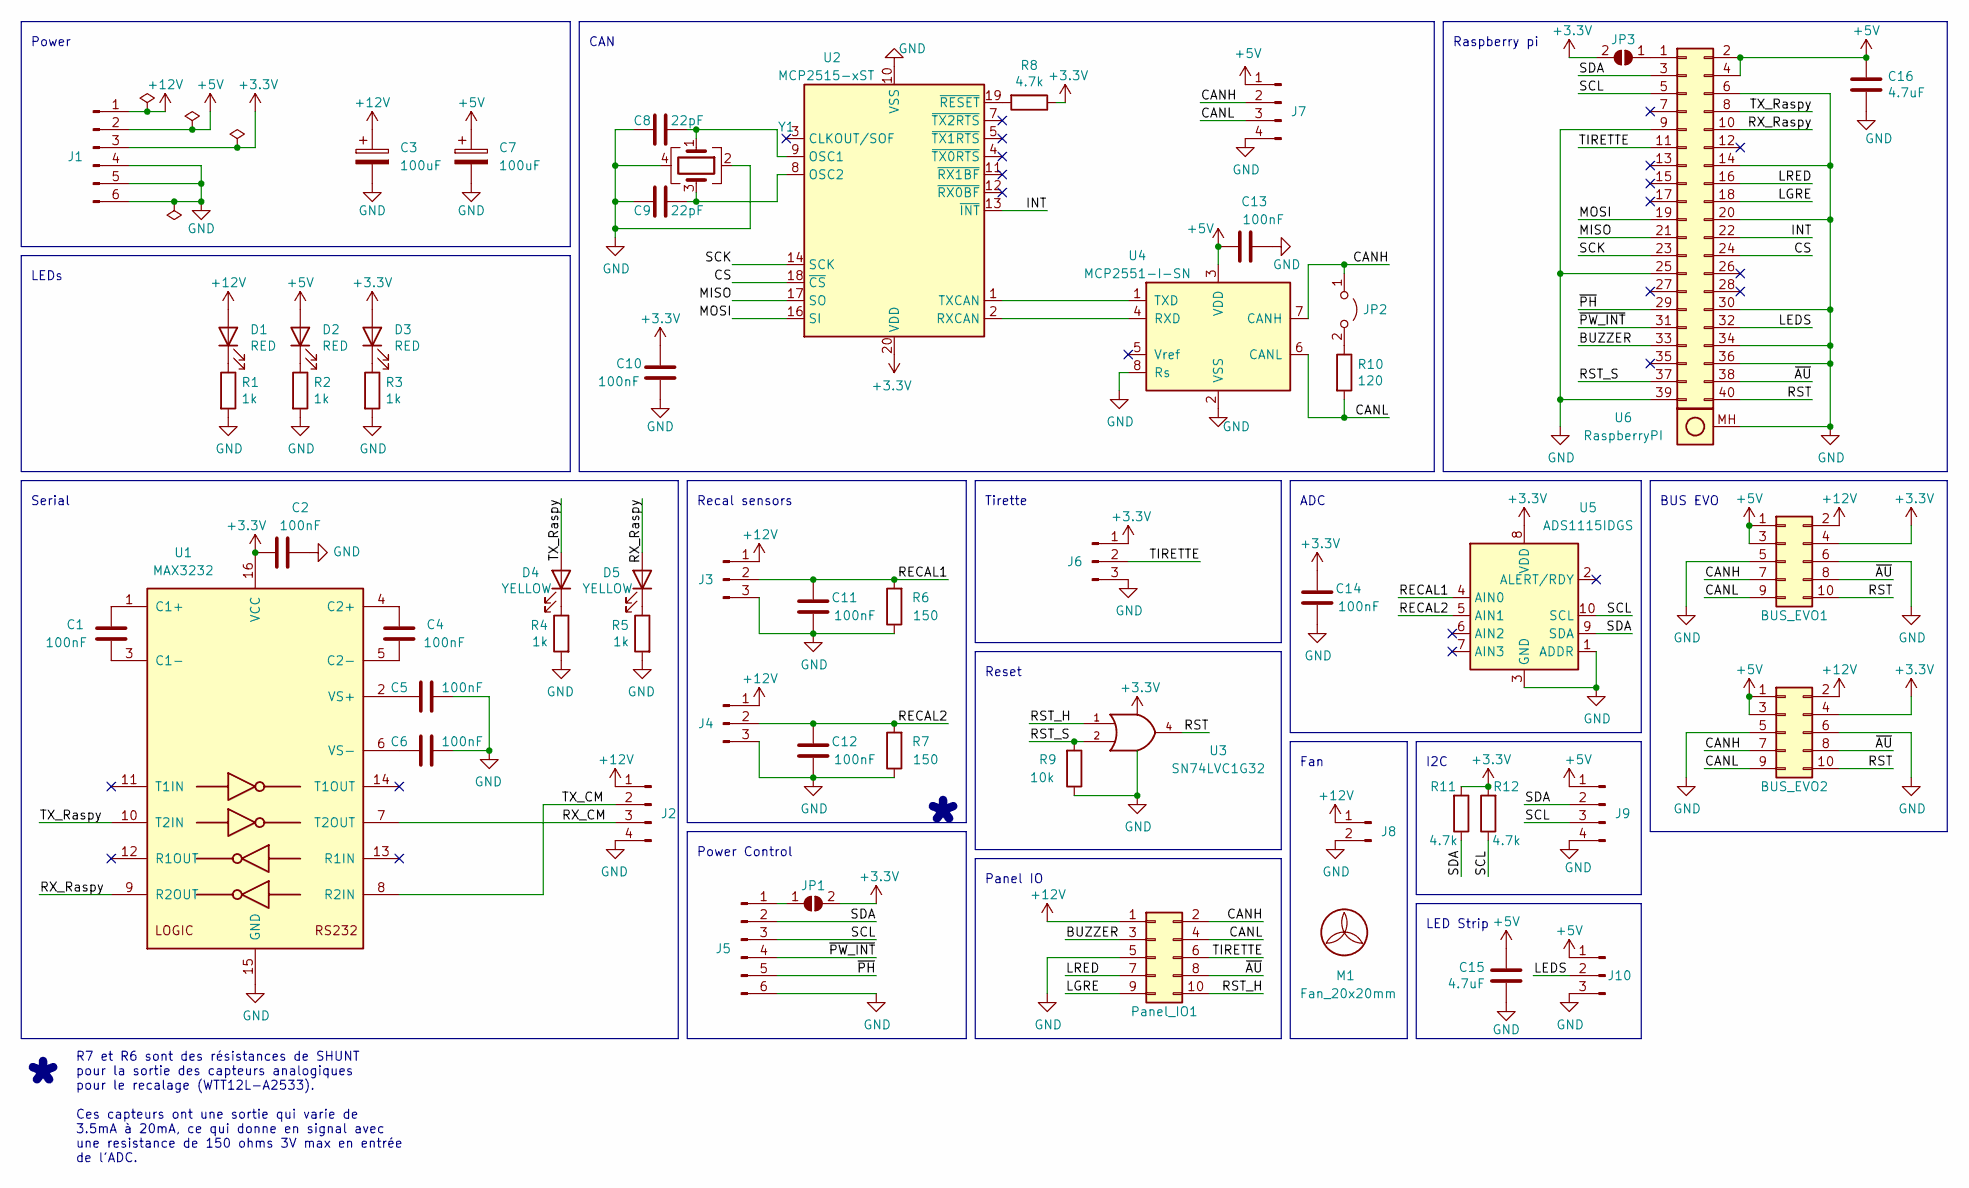
[picture p22: schematic CarteIO_V6.kicad_sch, CarteIO Raspberry Pi]

Parts:
BUS_EVO1, BUS_EVO2: Conn_02x05_Odd_Even; 690367281076
C1, C2, C4, C5, C6, C10, C11, C12, C13, C14: 100nF; C_0603_1608Metric
C3, C7: 100uF; CP_Elec_6.3x7.7
C8, C9: 22pF; C_0603_1608Metric
C15, C16: 4.7uF; C_0603_1608Metric
D1, D2, D3: RED; LED_0805_2012Metric
D4, D5: YELLOW; LED_0805_2012Metric
J1, J5: Conn_01x06_Male; 66200621122
J2, J7: Conn_01x04_Male; B04B-PASK
J3, J4, J6: Conn_01x03_Male; B03B-PASK
J8: FAN; B02B-PASK
J9: I2C; B04B-PASK
J10: LED strip MDB; B03B-PASK
JP1, JP3: SolderJumper_2_Open; SolderJumper-2_P1.3mm_Open_TrianglePad1.0x1.5mm
JP2: Jumper_2_Open; PinHeader_1x02_P2.54mm_Vertical
M1: Fan_20x20mm; 20x20x10_DC_FAN
Panel_IO1: Conn_02x05_Odd_Even; 690367281076
R1, R2, R3, R4, R5: 1k; R_0603_1608Metric
R6, R7: 150; R_0603_1608Metric
R8, R11, R12: 4.7k; R_0603_1608Metric
R9: 10k; R_0603_1608Metric
R10: 120; R_0603_1608Metric
U1: MAX3232; TSSOP-16_4.4x5mm_P0.65mm
U2: MCP2515-xST; TSSOP-20_4.4x6.5mm_P0.65mm
U3: SN74LVC1G32; SOT-23-5
U4: MCP2551-I-SN; SOIC-8_3.9x4.9mm_P1.27mm
U5: ADS1115IDGS; TSSOP-10_3x3mm_P0.5mm
U6: RaspberryPI; Shield_Raspberry_Pi_with_11mm_Header
Y1: Crystal_GND24; Crystal_SMD_5032-4Pin_5.0x3.2mm

Connections:
+3.3V: BUS_EVO1.4, BUS_EVO2.4, C2.2, C10.1, C14.1, D3.2 (A), J1.3, J6.1, JP1.2 (B), JP3.2 (B), R8.1, R11.2, R12.2, U1.16 (VCC), U2.20 (VDD), U3.5 (VCC), U5.8 (VDD)
+5V: BUS_EVO1.1, BUS_EVO1.3, BUS_EVO2.1, BUS_EVO2.3, C7.1, C13.2, C15.1, C16.1, D2.2 (A), J1.2, J7.1, J9.1, J10.1, U4.3 (VDD), U6.2, U6.4
+12V: BUS_EVO1.2, BUS_EVO2.2, C3.1, D1.2 (A), J1.1, J2.1, J3.1, J4.1, J8.1, Panel_IO1.1
/BUZZER: Panel_IO1.3, U6.33
/CANH: BUS_EVO1.7, BUS_EVO2.7, J7.2, JP2.1 (A), Panel_IO1.2, U4.7 (CANH)
/CANL: BUS_EVO1.9, BUS_EVO2.9, J7.3, Panel_IO1.4, R10.2, U4.6 (CANL)
/CS: U2.18 (~CS), U6.24
/INT: U2.13 (~INT), U6.22
/LEDS: J10.2, U6.32
/LGRE: Panel_IO1.9, U6.18
/LRED: Panel_IO1.7, U6.16
/MISO: U2.17 (SO), U6.21
/MOSI: U2.16 (SI), U6.19
/RECAL1: C11.1, J3.2, R6.2, U5.4 (AIN0)
/RECAL2: C12.1, J4.2, R7.2, U5.5 (AIN1)
/RST: BUS_EVO1.10, BUS_EVO2.10, U3.4 (S), U6.40
/RST_H: Panel_IO1.10, U3.1 (A)
/RST_S: R9.2, U3.2 (B), U6.37
/RX_CM: J2.3, U1.7 (T2OUT)
/RX_Raspy: D5.2 (A), U1.9 (R2OUT), U6.10
/SCK: U2.14 (SCK), U6.23
/SCL: J5.3, J9.3, R12.1, U5.10 (SCL), U6.5
/SDA: J5.2, J9.2, R11.1, U5.9 (SDA), U6.3
/TIRETTE: J6.2, Panel_IO1.6, U6.11
/TX_CM: J2.2, U1.8 (R2IN)
/TX_Raspy: D4.2 (A), U1.10 (T2IN), U6.8
/~AU: BUS_EVO1.8, BUS_EVO2.8, Panel_IO1.8, U6.38
/~PH: J5.5, U6.29
/~PW_INT: J5.4, U6.31
GND: BUS_EVO1.5, BUS_EVO1.6, BUS_EVO2.5, BUS_EVO2.6, C2.1, C3.2, C5.1, C6.1, C7.2, C8.2, C9.2, C10.2, C11.2, C12.2, C13.1, C14.2, C15.2, C16.2, J1.4, J1.5, J1.6, J2.4, J3.3, J4.3, J5.6, J6.3, J7.4, J8.2, J9.4, J10.3, Panel_IO1.5, R1.2, R2.2, R3.2, R4.2, R5.2, R6.1, R7.1, R9.1, U1.15 (GND), U2.10 (VSS), U3.3 (GND), U4.2 (VSS), U4.8 (Rs), U5.1 (ADDR), U5.3 (GND), U6.6, U6.9, U6.14, U6.20, U6.25, U6.30, U6.34, U6.36, U6.39, U6.MH (MountingHoles), Y1.2, Y1.4
unnamed: C1.1, U1.3 (C1-)
unnamed: C1.2, U1.1 (C1+)
unnamed: C4.1, U1.5 (C2-)
unnamed: C4.2, U1.4 (C2+)
unnamed: C5.2, U1.2 (VS+)
unnamed: C6.2, U1.6 (VS-)
unnamed: C8.1, U2.9 (OSC1), Y1.1
unnamed: C9.1, U2.8 (OSC2), Y1.3
unnamed: D1.1 (K), R1.1
unnamed: D2.1 (K), R2.1
unnamed: D3.1 (K), R3.1
unnamed: D4.1 (K), R4.1
unnamed: D5.1 (K), R5.1
unnamed: J5.1, JP1.1 (A)
unnamed: JP2.2 (B), R10.1
unnamed: JP3.1 (A), U6.1
unnamed: R8.2, U2.19 (~RESET)
unnamed: U2.1 (TXCAN), U4.1 (TXD)
unnamed: U2.2 (RXCAN), U4.4 (RXD)

Notes on the sheet:
R7 et R6 sont des résistances de SHUNT pour la sortie des capteurs analogiques pour le recalage (WTT12L-A2533). Ces capteurs ont une sortie qui varie de 3.5mA à 20mA, ce qui donne en signal avec une resistance de 150 ohms 3V max en entrée de l'ADC.
Power Control
Raspberry pi
Tirette
Reset
LED Strip
Serial
Panel IO
ADC
Recal sensors
I2C
BUS EVO
CAN
LEDs
Fan
Power

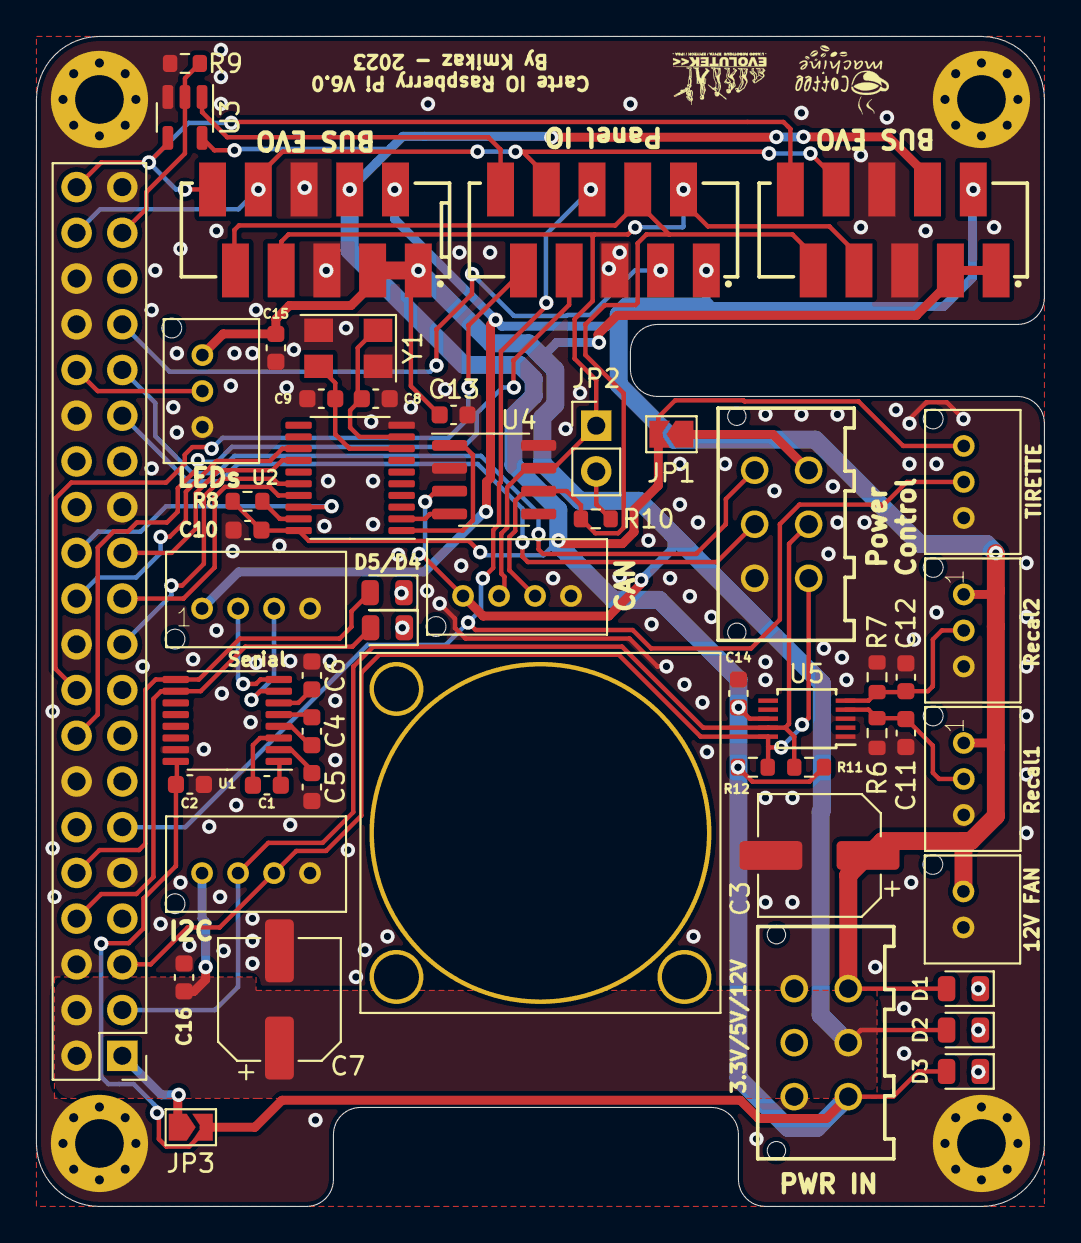
[picture p23: board CarteIO_V6.kicad_pcb from above]

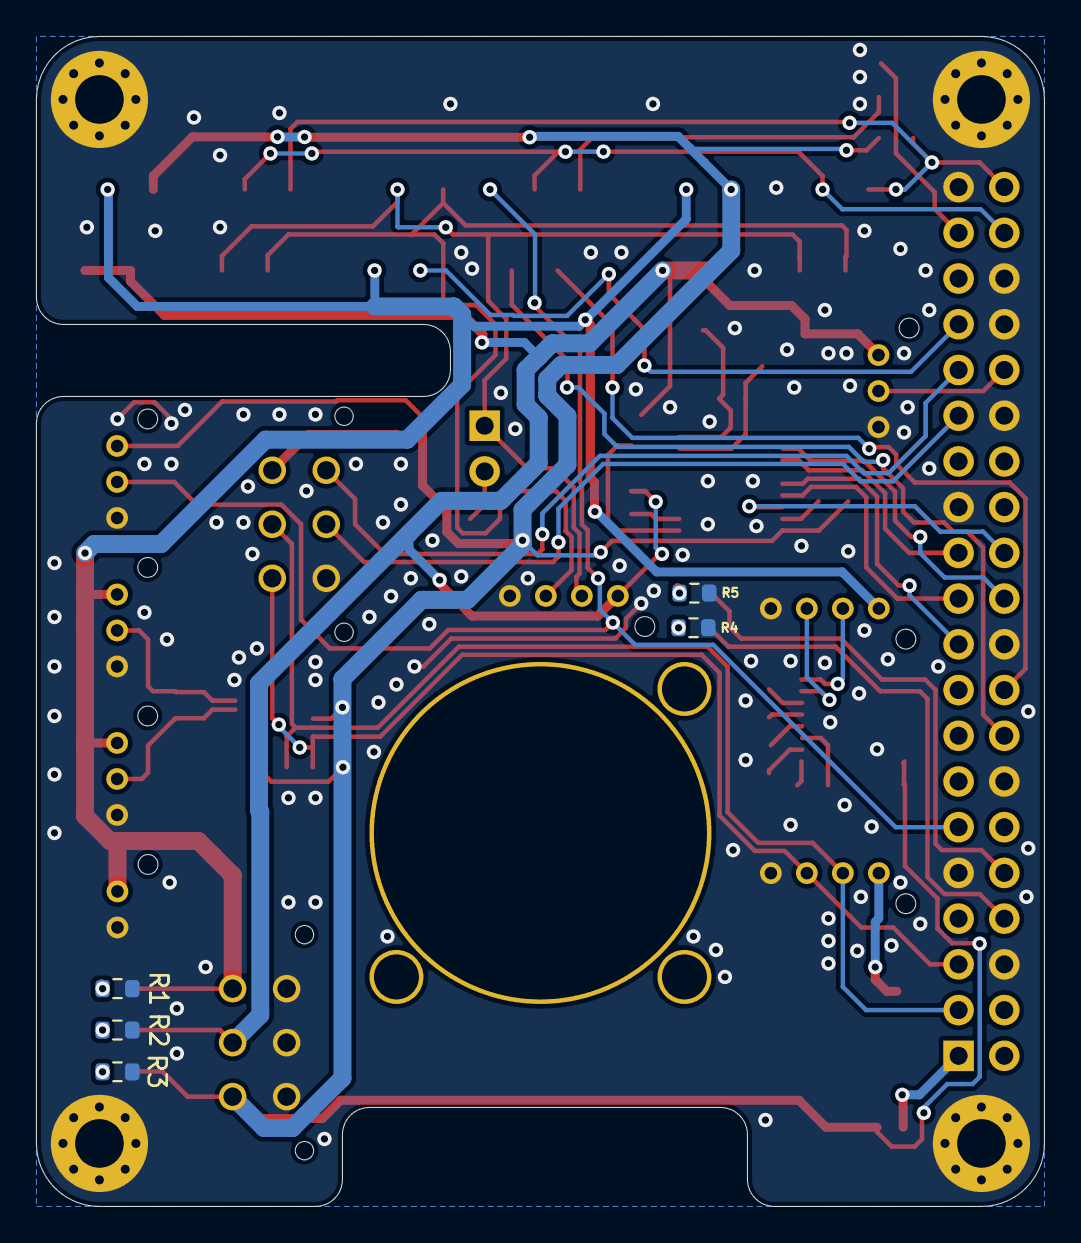
[picture p24: board CarteIO_V6.kicad_pcb from below]

Board: 2 copper layers, 56.0 x 65.0 mm, 57 parts (5 on the bottom side), 49 nets.
