evolutek/carte-io-raspberry-pi/CarteIO V5/CarteIO_V5.kicad_pcb

## KiCad design CarteIO V5/CarteIO_V5.kicad_pcb (2022-05-01, an earlier design)

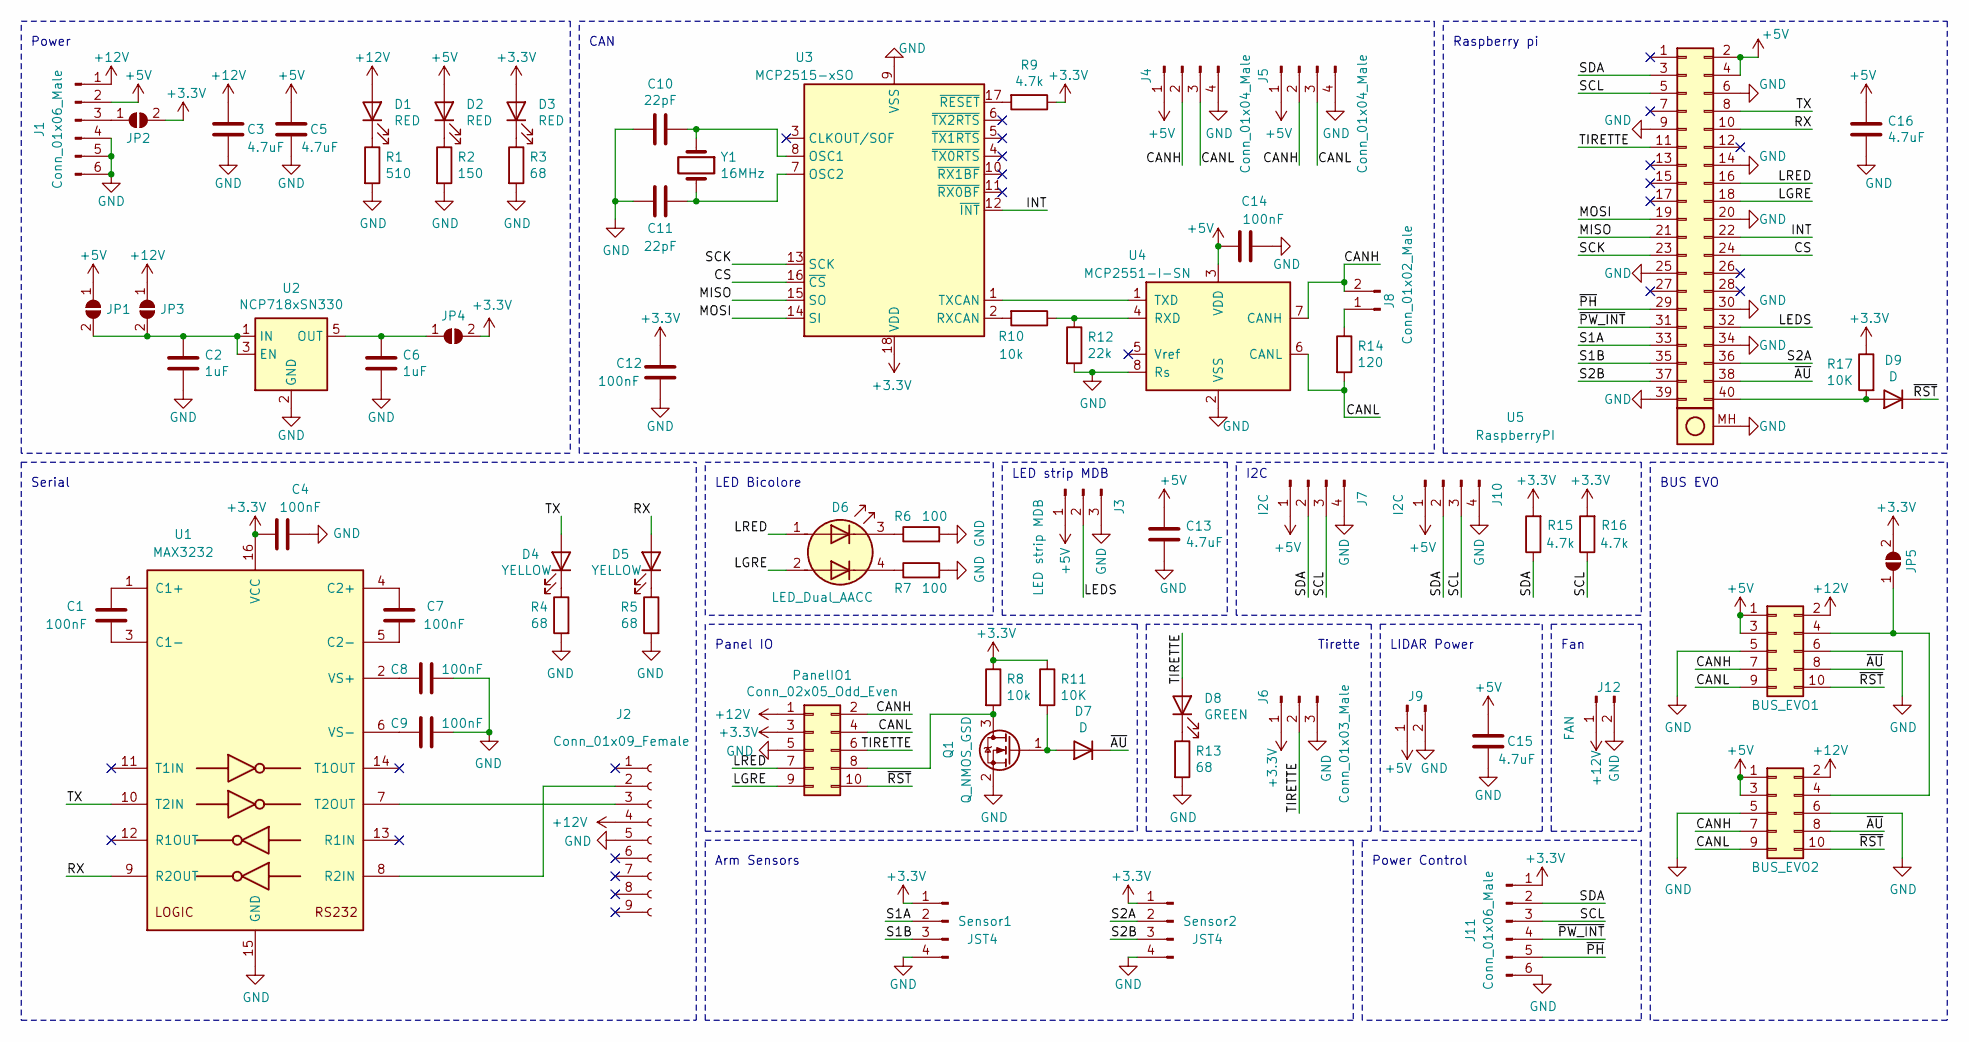
[picture p25: schematic CarteIO_V5.sch, CarteIO Raspberry Pi]

Parts:
BUS_EVO1, BUS_EVO2: Conn_02x05_Odd_Even; 690367281076
C1, C4, C7, C8, C9, C12, C14: 100nF; C_0603_1608Metric
C2, C6: 1uF; C_0603_1608Metric
C3, C5, C13, C15, C16: 4.7uF; C_0603_1608Metric
C10, C11: 22pF; C_0603_1608Metric
D1, D2, D3: RED; LED_0805_2012Metric
D4, D5: YELLOW; LED_0805_2012Metric
D6: LED_Dual_AACC; WL-SBTW_3528
D7, D9: D; D_SOD-523
D8: GREEN; LED_0805_2012Metric
J1, J11: Conn_01x06_Male; 66200621122
J2: Conn_01x09_Female; DSUB-9_Male_Horizontal_P2.77x2.84mm_EdgePinOffset7.70mm_Hou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
J3: LED strip MDB; B03B-PASK
J4, J5: Conn_01x04_Male; B04B-PASK
J6: Conn_01x03_Male; B03B-PASK
J7, J10: I2C; B04B-PASK
J8: Conn_01x02_Male; PinHeader_2x01_P2.54mm_Vertical
J9: LIDAR Power; B02B-PASK
J12: FAN; B02B-PASK
JP1, JP2, JP3, JP4, JP5: SolderJumper_2_Open; SolderJumper-2_P1.3mm_Open_TrianglePad1.0x1.5mm
PanelIO1: Conn_02x05_Odd_Even; 690367281076
Q1: Q_NMOS_GSD; SOT-23
R1: 510; R_0603_1608Metric
R2: 150; R_0603_1608Metric
R3, R4, R5, R13: 68; R_0603_1608Metric
R6, R7: 100; R_0603_1608Metric
R8, R10: 10k; R_0603_1608Metric
R9, R15, R16: 4.7k; R_0603_1608Metric
R11, R17: 10K; R_0603_1608Metric
R12: 22k; R_0603_1608Metric
R14: 120; R_0603_1608Metric
Sensor1, Sensor2: JST4; B04B-PASK
U1: MAX3232; SOIC-16_3.9x9.9mm_P1.27mm
U2: NCP718xSN330; SOT-23-5
U3: MCP2515-xSO; SOIC-18W_7.5x11.6mm_P1.27mm
U4: MCP2551-I-SN; SOIC-8_3.9x4.9mm_P1.27mm
U5: RaspberryPI; Shield_Raspberry_Pi_with_18mm_Header
Y1: 16MHz; Crystal_HC49-4H_Vertical

Connections:
+3V3: C4.2, C12.1, D3.2 (A), J6.1, J11.1, JP2.2 (B), JP4.2 (B), JP5.2 (B), PanelIO1.3, R8.1, R9.1, R11.1, R15.2, R16.2, R17.1, Sensor1.1, Sensor2.1, U1.16 (VCC), U3.18 (VDD); also elsewhere on the board
+5V: BUS_EVO1.1, BUS_EVO1.3, BUS_EVO2.1, BUS_EVO2.3, C5.1, C13.1, C14.2, C15.1, C16.1, D2.2 (A), J1.2, J3.1, J4.1, J5.1, J7.1, J9.1, J10.1, JP1.1 (A), U4.3 (VDD), U5.2, U5.4
+12V: BUS_EVO1.2, BUS_EVO2.2, C3.1, D1.2 (A), J1.1, J2.4, J12.1, JP3.1 (A), PanelIO1.1; also elsewhere on the board
/CANH: BUS_EVO1.7, BUS_EVO2.7, J4.2, J5.2, J8.2, PanelIO1.2, U4.7 (CANH); also elsewhere on the board
/CANL: BUS_EVO1.9, BUS_EVO2.9, J4.3, J5.3, PanelIO1.4, R14.2, U4.6 (CANL); also elsewhere on the board
/CS: U3.16 (~CS), U5.24
/INT: U3.12 (~INT), U5.22
/LEDS: J3.2, U5.32
/LGRE: D6.2 (A2), PanelIO1.9, U5.18; also elsewhere on the board
/LRED: D6.1 (A1), PanelIO1.7, U5.16; also elsewhere on the board
/MISO: U3.15 (SO), U5.21
/MOSI: U3.14 (SI), U5.19
/RX: D5.2 (A), U1.9 (R2OUT), U5.10
/S1A: Sensor1.2, U5.33
/S1B: Sensor1.3, U5.35
/S2A: Sensor2.2, U5.36
/S2B: Sensor2.3, U5.37
/SCK: U3.13 (SCK), U5.23
/SCL: J7.3, J10.3, J11.3, R16.1, U5.5
/SDA: J7.2, J10.2, J11.2, R15.1, U5.3
/TIRETTE: D8.2 (A), J6.2, PanelIO1.6, U5.11; also elsewhere on the board
/TX: D4.2 (A), U1.10 (T2IN), U5.8
/~AU: BUS_EVO1.8, BUS_EVO2.8, D7.1 (K), U5.38
/~PH: J11.5, U5.29
/~PW_INT: J11.4, U5.31
/~RST: BUS_EVO1.10, BUS_EVO2.10, D9.1 (K), PanelIO1.10; also elsewhere on the board
GND: BUS_EVO1.5, BUS_EVO1.6, BUS_EVO2.5, BUS_EVO2.6, C2.2, C3.2, C4.1, C5.2, C6.2, C8.1, C9.1, C10.2, C11.2, C12.2, C13.2, C14.1, C15.2, C16.2, J1.4, J1.5, J1.6, J2.5, J3.3, J4.4, J5.4, J6.3, J7.4, J9.2, J10.4, J11.6, J12.2, PanelIO1.5, Q1.2 (S), R1.2, R2.2, R3.2, R4.2, R5.2, R6.2, R7.2, R12.2, R13.2, Sensor1.4, Sensor2.4, U1.15 (GND), U2.2 (GND), U3.9 (VSS), U4.2 (VSS), U4.8 (Rs), U5.6, U5.9, U5.14, U5.20, U5.25, U5.30, U5.34, U5.39, U5.MH (MountingHoles); also elsewhere on the board
unnamed: BUS_EVO1.4, BUS_EVO2.4, JP5.1 (A)
unnamed: C1.1, U1.3 (C1-)
unnamed: C1.2, U1.1 (C1+)
unnamed: C2.1, JP1.2 (B), JP3.2 (B), U2.1 (IN), U2.3 (EN)
unnamed: C6.1, JP4.1 (A), U2.5 (OUT)
unnamed: C7.1, U1.5 (C2-)
unnamed: C7.2, U1.4 (C2+)
unnamed: C8.2, U1.2 (VS+)
unnamed: C9.2, U1.6 (VS-)
unnamed: C10.1, U3.8 (OSC1), Y1.1
unnamed: C11.1, U3.7 (OSC2), Y1.2
unnamed: D1.1 (K), R1.1
unnamed: D2.1 (K), R2.1
unnamed: D3.1 (K), R3.1
unnamed: D4.1 (K), R4.1
unnamed: D5.1 (K), R5.1
unnamed: D6.3 (K1), R6.1
unnamed: D6.4 (K2), R7.1
unnamed: D7.2 (A), Q1.1 (G), R11.2
unnamed: D8.1 (K), R13.1
unnamed: D9.2 (A), R17.2, U5.40
unnamed: J1.3, JP2.1 (A)
unnamed: J2.2, U1.8 (R2IN)
unnamed: J2.3, U1.7 (T2OUT)
unnamed: J8.1, R14.1
unnamed 52: PanelIO1.8, Q1.3 (D), R8.2; also elsewhere on the board
unnamed: R9.2, U3.17 (~RESET)
unnamed: R10.1, R12.1, U4.4 (RXD)
unnamed: R10.2, U3.2 (RXCAN)
unnamed: U3.1 (TXCAN), U4.1 (TXD)

Notes on the sheet:
Power
CAN
Serial
Raspberry pi
Power Control
LIDAR Power
I2C
LED strip MDB
LED Bicolore
Tirette
Fan
Panel IO
BUS EVO
Arm Sensors

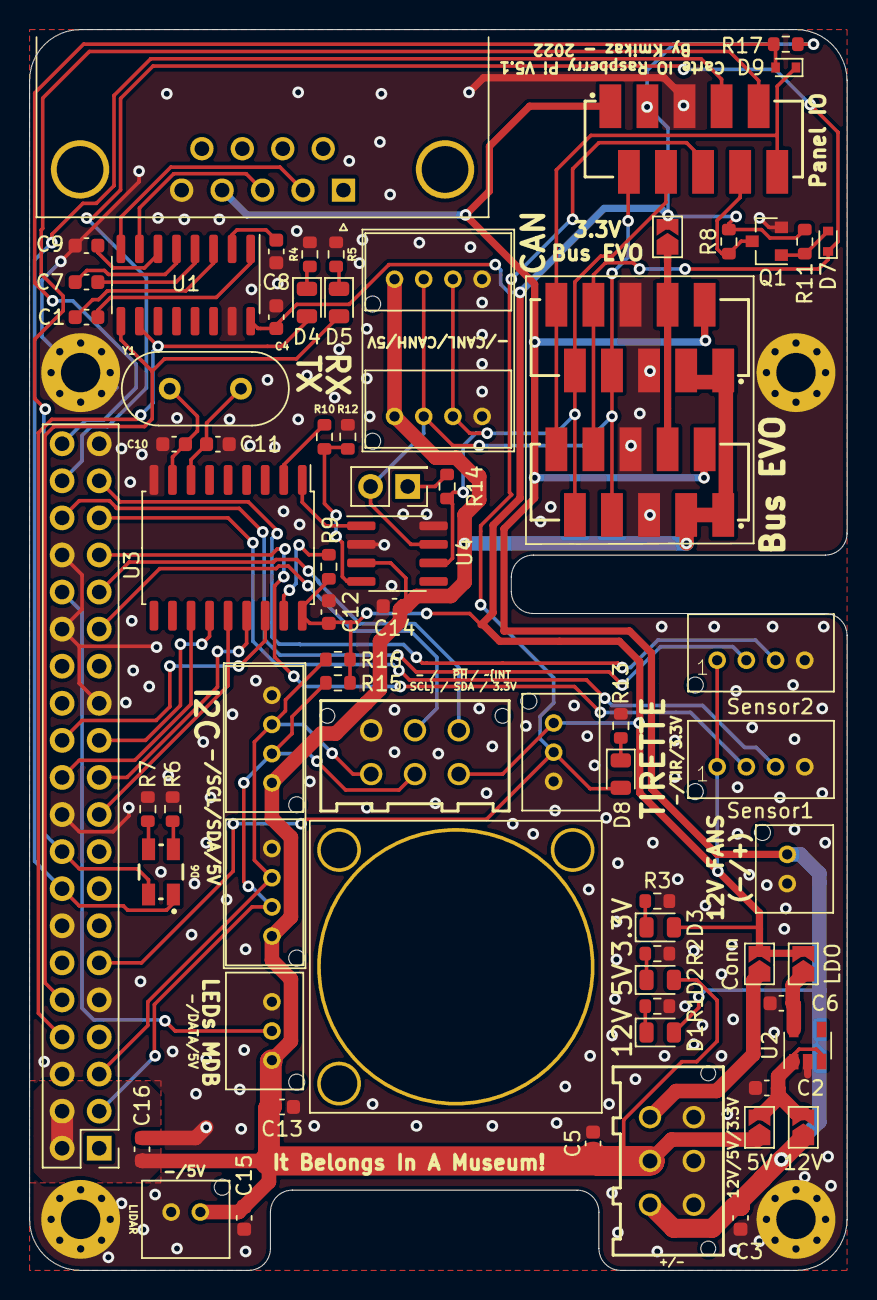
[picture p26: board CarteIO_V5.kicad_pcb from above]

Board: 2 copper layers, 56.0 x 85.0 mm, 71 parts (0 on the bottom side), 57 nets.

Other parts of the board:
Panel IO: Conn_02x05_Odd_Even; 690367281076

Their connections:
+3V3: Panel IO.3; also elsewhere on the board
+12V: Panel IO.1; also elsewhere on the board
/CANH: Panel IO.2; also elsewhere on the board
/CANL: Panel IO.4; also elsewhere on the board
/LGRE: Panel IO.9; also elsewhere on the board
/LRED: Panel IO.7; also elsewhere on the board
/TIRETTE: Panel IO.6; also elsewhere on the board
/~RST: Panel IO.10; also elsewhere on the board
GND: Panel IO.5; also elsewhere on the board
unnamed 52: Panel IO.8; also elsewhere on the board
