evolutek/carte-io-raspberry-pi/CarteIO Beacon V2/CarteIO Beacon V2.kicad_pcb

## KiCad design CarteIO Beacon V2/CarteIO Beacon V2.kicad_pcb (2021-04-05, an earlier design)

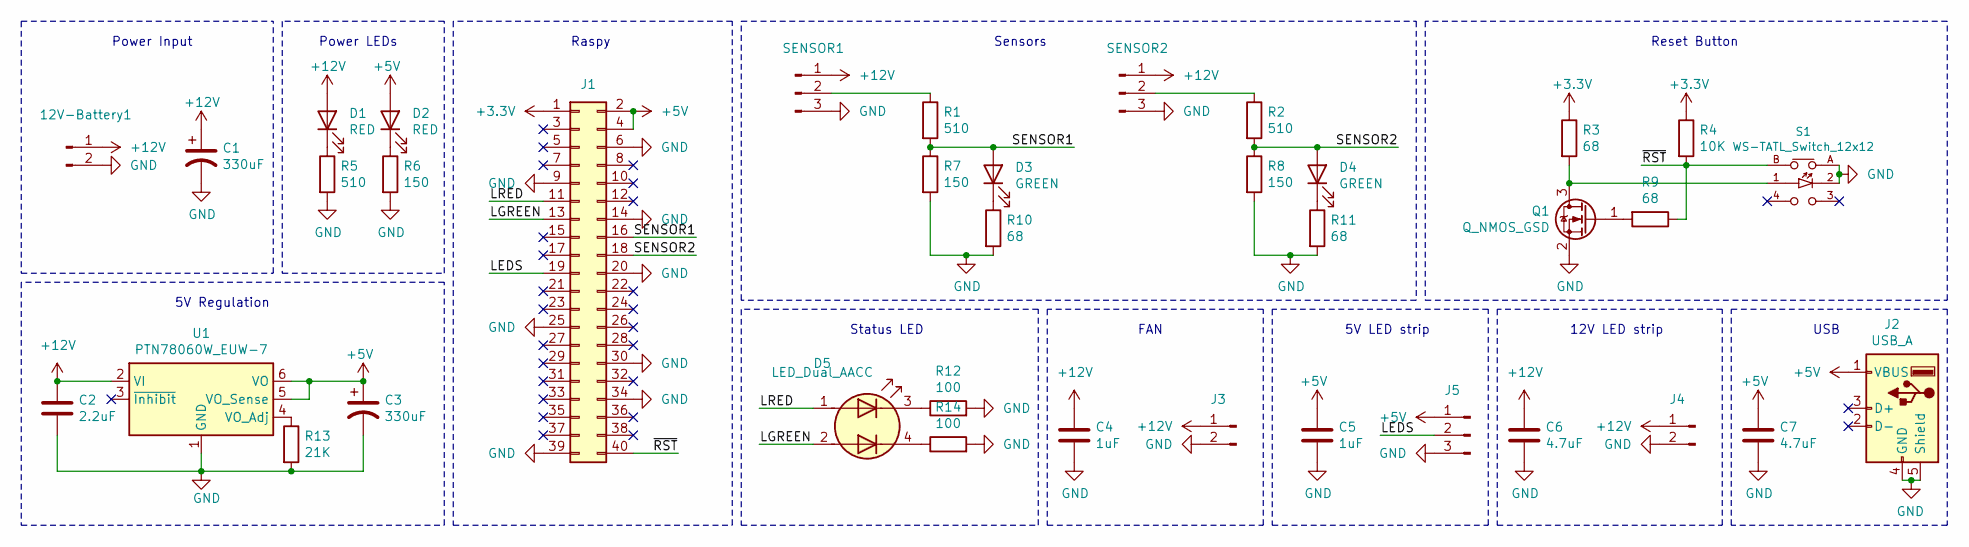
[picture p27: schematic CarteIO Beacon V2.sch, Carte IO Beacon]

Parts:
12V-Battery1: Conn_01x02_Male; 649002227222
C1, C3: 330uF; CP_Radial_D10.0mm_P5.00mm
C2: 2.2uF; C_0603_1608Metric
C4, C5: 1uF; C_0603_1608Metric
C6, C7: 4.7uF; C_0603_1608Metric
D1, D2: RED; LED_0805_2012Metric
D3, D4: GREEN; LED_0805_2012Metric
D5: LED_Dual_AACC; WL-SBTW_3528
J1: Conn_02x20_Odd_Even; ShieldRaspberryPiWithOldHeader
J2: USB_A; USB_A_CONNFLY_DS1095-WNR0
J3, J4: Conn_01x02_Male; B02B-PASK
J5: Conn_01x03_Male; B03B-PASK
Q1: Q_NMOS_GSD; SOT-23
R1, R2, R5: 510; R_0603_1608Metric
R3, R9, R10, R11: 68; R_0603_1608Metric
R4: 10K; R_0603_1608Metric
R6, R7, R8: 150; R_0603_1608Metric
R12, R14: 100; R_0603_1608Metric
R13: 21K; R_0603_1608Metric
S1: WS-TATL_Switch_12x12; 440YS67082622
SENSOR1, SENSOR2: Conn_01x03_Male; B03B-PASK
U1: PTN78060W_EUW-7; Texas_EUW_R-PDSS-T7_THT

Connections:
+3V3: J1.1, R3.1, R4.1
+5V: C3.1, C5.1, C7.1, D2.2 (A), J1.2, J1.4, J2.1 (VBUS), J5.1, U1.5 (VO_Sense), U1.6 (VO)
+12V: 12V-Battery1.1, C1.1, C2.1, C4.1, C6.1, D1.2 (A), J3.1, J4.1, SENSOR1.1, SENSOR2.1, U1.2 (VI)
/LEDS: J1.19, J5.2
/LGREEN: D5.2 (A2), J1.13
/LRED: D5.1 (A1), J1.11
/SENSOR1: D3.2 (A), J1.16, R1.2, R7.1
/SENSOR2: D4.2 (A), J1.18, R2.2, R8.1
/~RST: J1.40, R4.2, R9.1, S1.B
GND: 12V-Battery1.2, C1.2, C2.2, C3.2, C4.2, C5.2, C6.2, C7.2, J1.6, J1.9, J1.14, J1.20, J1.25, J1.30, J1.34, J1.39, J2.4 (GND), J2.5 (Shield), J3.2, J4.2, J5.3, Q1.2 (S), R5.2, R6.2, R7.2, R8.2, R10.2, R11.2, R12.2, R13.2, R14.2, S1.2, S1.A, SENSOR1.3, SENSOR2.3, U1.1 (GND), U1.7 (GND)
unnamed: D1.1 (K), R5.1
unnamed: D2.1 (K), R6.1
unnamed: D3.1 (K), R10.1
unnamed: D4.1 (K), R11.1
unnamed: D5.3 (K1), R12.1
unnamed: D5.4 (K2), R14.1
unnamed: Q1.1 (G), R9.2
unnamed: Q1.3 (D), R3.2, S1.1
unnamed: R1.1, SENSOR1.2
unnamed: R2.1, SENSOR2.2
unnamed: R13.1, U1.4 (VO_Adj)

Notes on the sheet:
Power Input
5V Regulation
Power LEDs
Raspy
Sensors
Status LED
Reset Button
FAN
5V LED strip
12V LED strip
USB

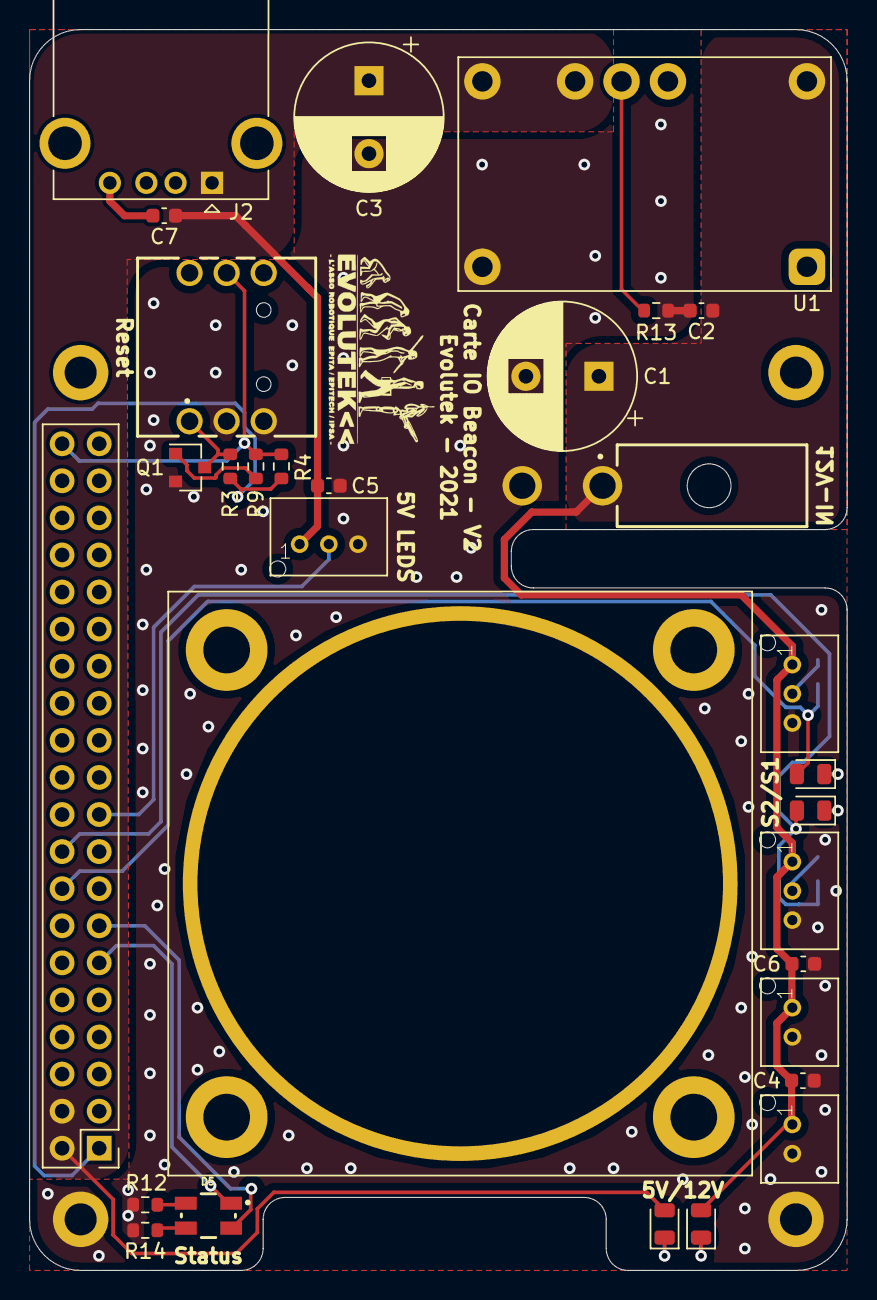
[picture p28: board CarteIO Beacon V2.kicad_pcb from above]

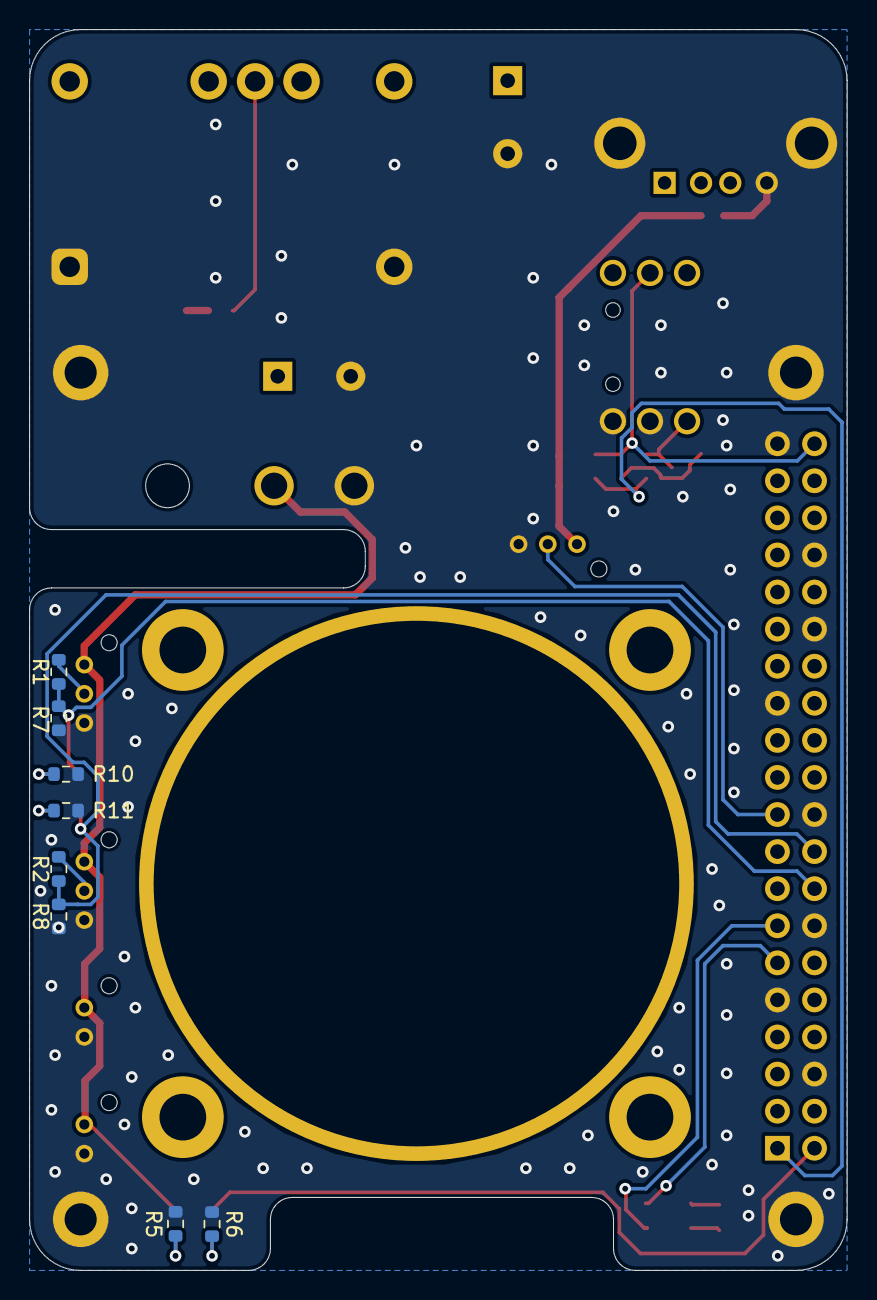
[picture p29: board CarteIO Beacon V2.kicad_pcb from below]

Board: 2 copper layers, 56.0 x 85.0 mm, 37 parts (8 on the bottom side), 21 nets.
