evolutek/carte-io-raspberry-pi/CarteIO Beacon V1/Board.brd

## EAGLE design CarteIO Beacon V1/Board.brd (2020-09-04, an earlier design)

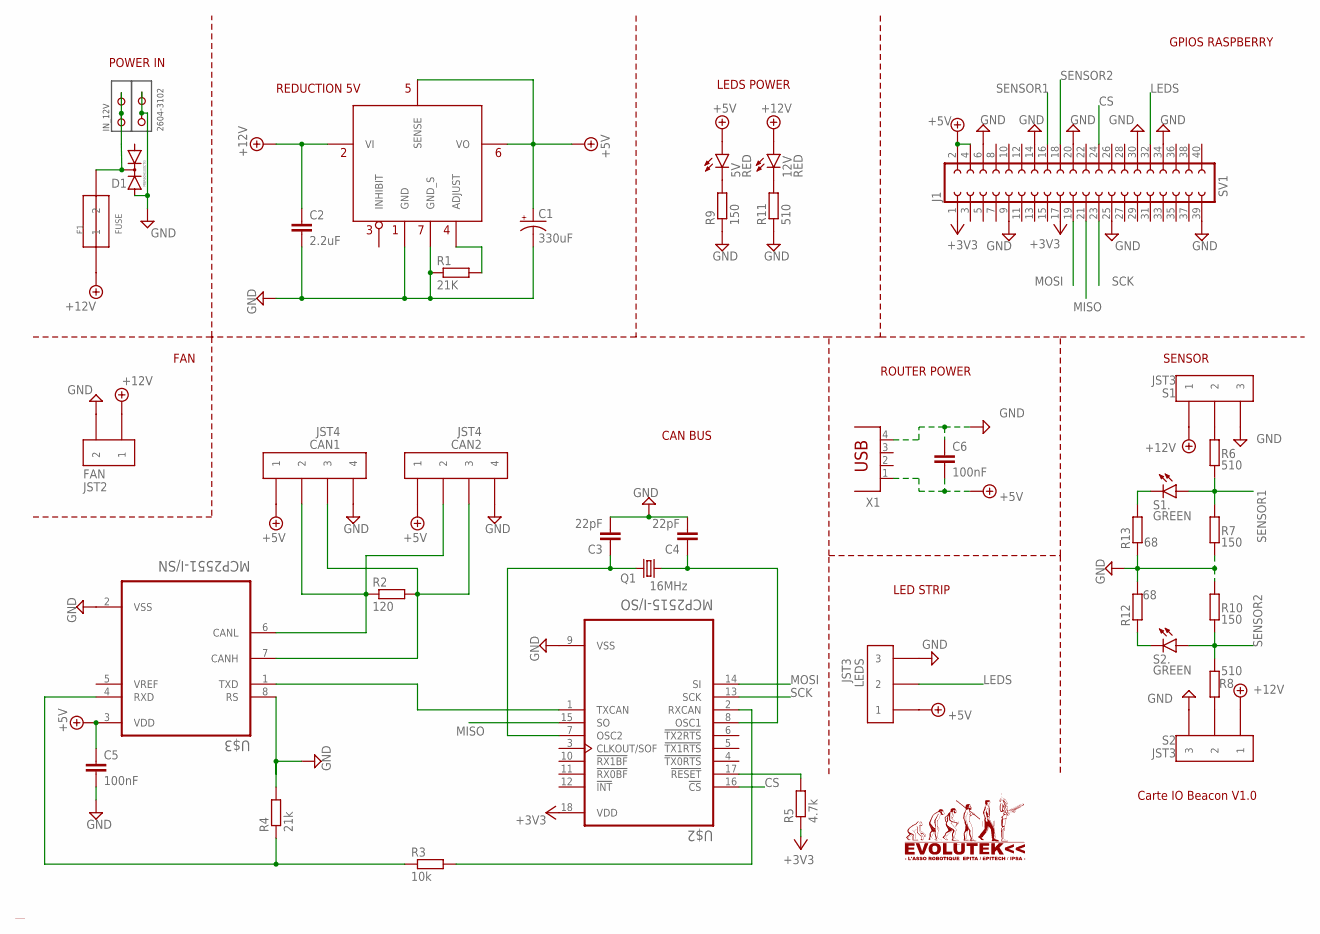
[picture p30: schematic Board.sch]

Parts:
5V, 12V: RED; CHIP-LED0805
C1: 330uF; E5-10,5
C2: 2.2uF; C0603
C3, C4: 22pF; C0603
C5, C6: 100nF; C0603
CAN1, CAN2: JST4; B04B-PASK
D1: MBR60H100CTG; TO220ABS
F1: FUSE
FAN: JST2; B02B-PASK
IN_12V: 2604-3102; P-2604-3102
LEDS: JST3; B03B-PASK
Q1: 16MHz; HC49/S
R1: 21K; R0603
R2: 120; R0603
R3: 10k; R0603
R4: 21k; R0603
R5: 4.7k; R0603
R6, R8, R11: 510; R0603
R7, R9, R10: 150; R0603
R12, R13: 68; R0603
S1, S2: JST3; B03B-PASK
S1., S2.: GREEN; CHIP-LED0805
SV1: J1; FE20-2
U$1: PTN78020WAD
U$2: MCP2515-I/SO; SOIC127P1030X265-18N
U$3: MCP2551-I/SN; SOIC127P599X175-8N
X1: PN87520

Connections:
+3V3: R5.1, SV1.1, SV1.17, U$2.18 (VDD)
+5V: 5V.A, C1.+, C5.1, C6.2, CAN1.P$1 (1), CAN2.P$1 (1), LEDS.P$1 (1), SV1.2, SV1.4, U$1.5 (SENSE), U$1.6 (VO), U$3.3 (VDD), X1.1
+12V: 12V.A, C2.1, F1.P$1 (1), F1.P$2 (1), FAN.P$1 (1), S1.P$1 (1), S2.P$1 (1), U$1.2 (VI)
CS: SV1.24, U$2.16 (!CS)
GND: C1.-, C2.2, C3.2, C4.2, C5.2, C6.1, CAN1.P$4 (4), CAN2.P$4 (4), D1.A1, FAN.P$2 (2), IN_12V.P2.1, IN_12V.P2.2, LEDS.P$3 (3), R1.1, R4.2, R7.2, R9.1, R10.2, R11.1, R12.2, R13.1, S1.P$3 (3), S2.P$3 (3), SV1.6, SV1.9, SV1.14, SV1.20, SV1.25, SV1.30, SV1.34, SV1.39, U$1.1 (GND), U$1.7 (GND_S), U$2.9 (VSS), U$3.2 (VSS), U$3.8 (RS), X1.4
LEDS: LEDS.P$2 (2), SV1.32
MISO: SV1.21, U$2.15 (SO)
MOSI: SV1.19, U$2.14 (SI)
unnamed: R6.1, S1.P$2 (2)
unnamed: R1.2, U$1.4 (ADJUST)
unnamed: CAN1.P$2 (2), CAN2.P$2 (2), R2.1, U$3.6 (CANL)
unnamed: CAN1.P$3 (3), CAN2.P$3 (3), R2.2, U$3.7 (CANH)
unnamed: R8.1, S2.P$2 (2)
unnamed: C4.1, Q1.1, U$2.8 (OSC1)
unnamed: R13.2, S1..C
unnamed: 5V.C, R9.2
unnamed: R3.2, U$2.2 (RXCAN)
unnamed: 12V.C, R11.2
unnamed: R12.1, S2..C
unnamed: D1.C, F1.P$3 (2), F1.P$4 (2), IN_12V.P1.1, IN_12V.P1.2
unnamed: R3.1, R4.1, U$3.4 (RXD)
unnamed: R5.2, U$2.17 (!RESET)
unnamed: U$2.1 (TXCAN), U$3.1 (TXD)
unnamed: C3.1, Q1.2, U$2.7 (OSC2)
SCK: SV1.23, U$2.13 (SCK)
SENSOR1: R6.2, R7.1, S1..A, SV1.16
SENSOR2: R8.2, R10.1, S2..A, SV1.18

Notes on the sheet:
POWER IN
LEDS POWER
GPIOS RASPBERRY
Carte IO Beacon V1.0
FAN
CAN BUS
LED STRIP
SENSOR
REDUCTION 5V
ROUTER POWER

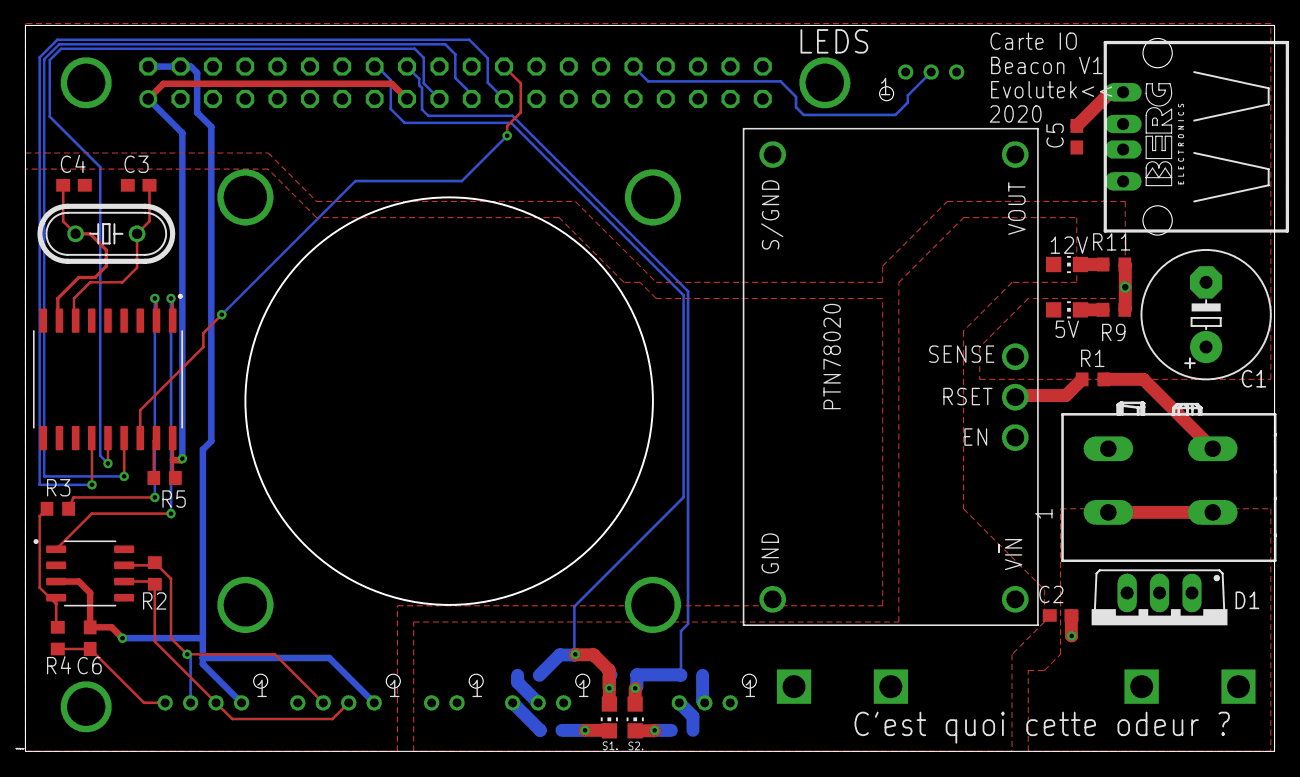
[picture p31: board CarteIO Beacon V1/Board.brd from above]

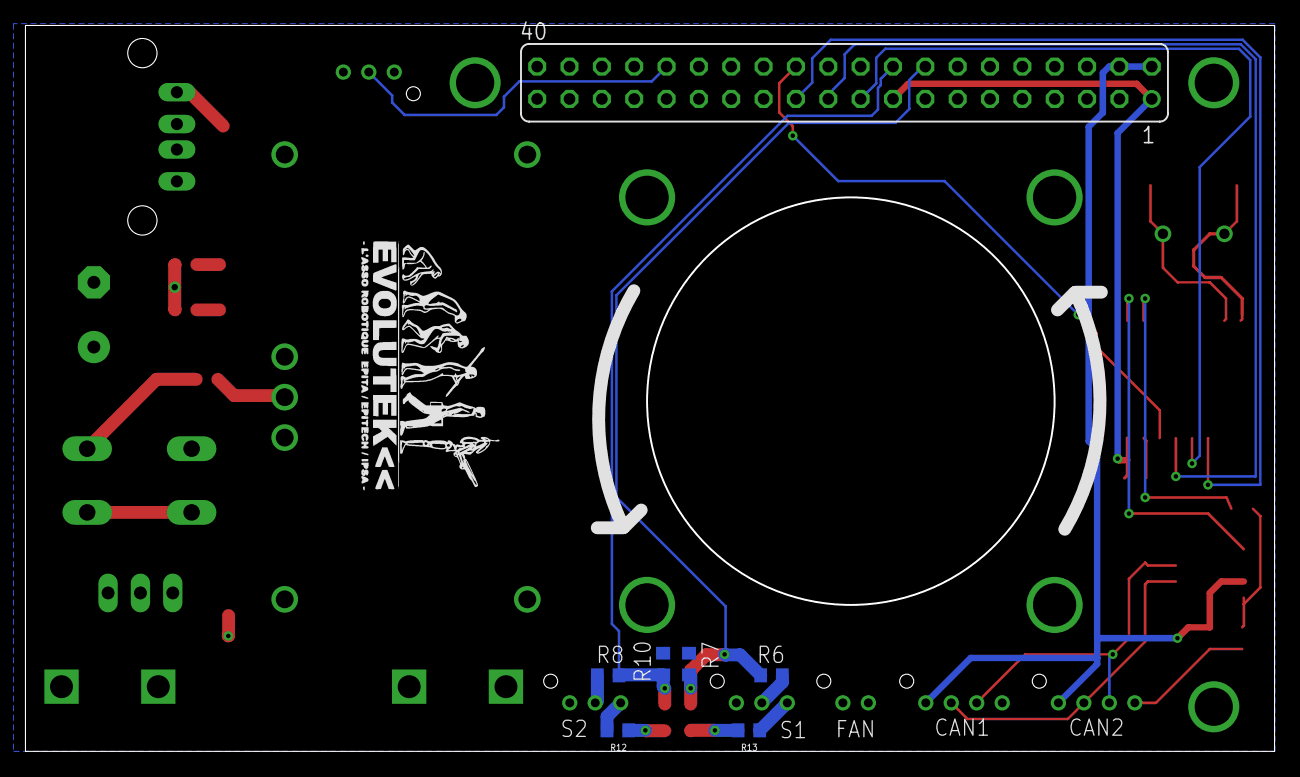
[picture p32: board CarteIO Beacon V1/Board.brd from below]

Board: 2 copper layers, 98.1 x 57.0 mm, 38 parts (7 on the bottom side), 27 nets.
