evolutek/carte-io-raspberry-pi/CarteIO V3/Board.brd

## EAGLE design CarteIO V3/Board.brd (2020-04-20, an earlier design)

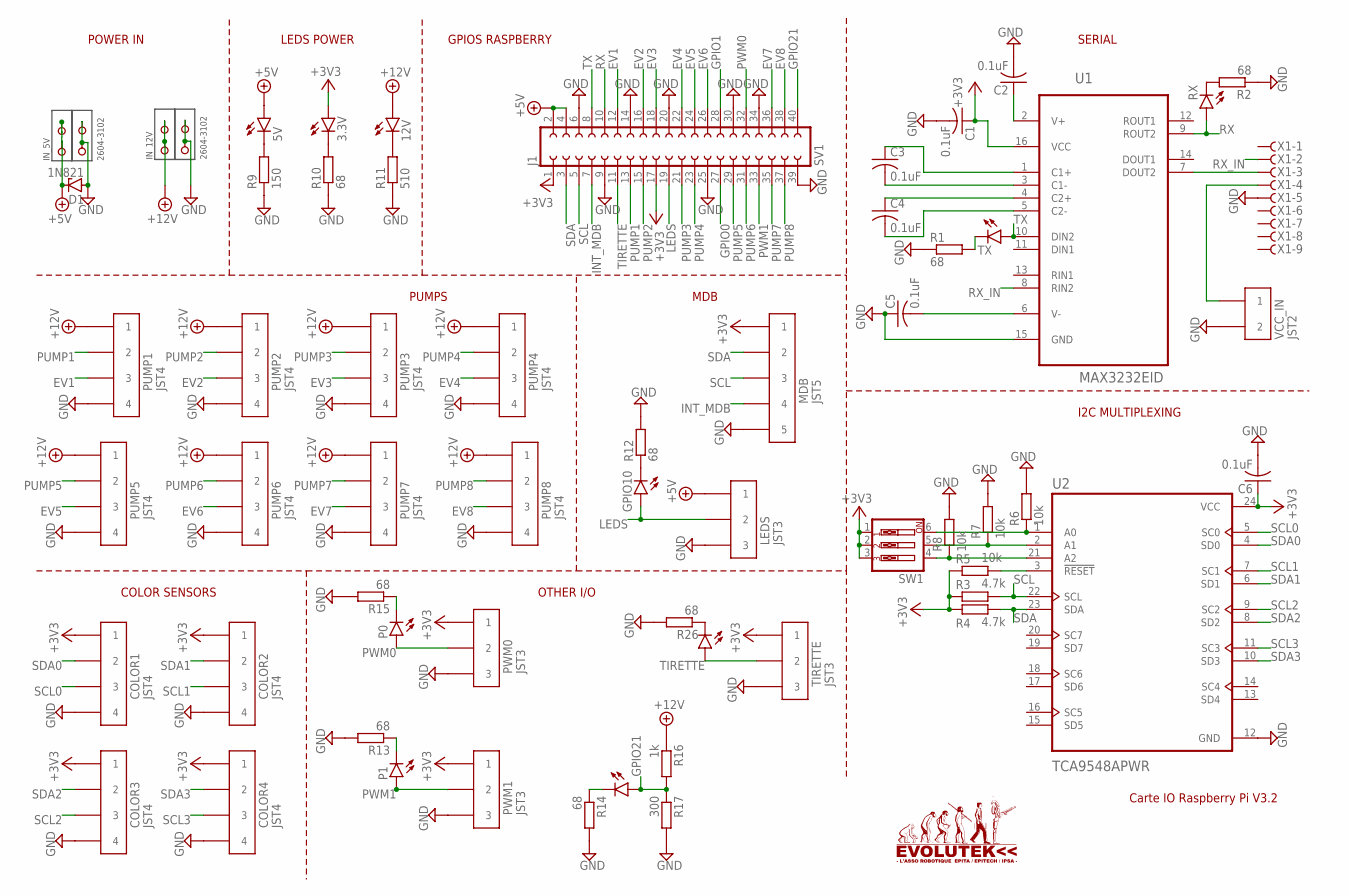
[picture p33: schematic Board.sch]

Parts:
3.3V, 5V, 12V: LEDCHIP-LED0805; CHIP-LED0805
BAU: LEDCHIP-LED0805; CHIP-LED0805
C1, C2, C3, C4, C5, C6: 0.1uF; C0603
COLOR1, COLOR2, COLOR3, COLOR4: JST4; B04B-PASK
D1: 1N821; DO35Z10
GPIO10: LEDCHIP-LED0805; CHIP-LED0805
IN_5V, IN_12V: 2604-3102; P-2604-3102
LEDS: JST3; B03B-PASK
LED_TIRETTE: LEDCHIP-LED0805; CHIP-LED0805
MDB: JST5; B05B-PASK
P0, P1: LEDCHIP-LED0805; CHIP-LED0805
PUMP1, PUMP2, PUMP3, PUMP4, PUMP5, PUMP6, PUMP7, PUMP8: JST4; B04B-PASK
PWM0, PWM1: JST3; B03B-PASK
R1, R2, R10, R12, R13, R14, R15, R26: 68; R0603
R3, R4: 4.7k; R0603
R5, R6, R7, R8: 10k; R0603
R9: 150; R0603
R11: 510; R0603
R16: 1k; R0603
R17: 300; R0603
RX: LEDCHIP-LED0805; CHIP-LED0805
SV1: J1; FE20-2
SW1: SW_DIP-3; EDG-03
TIRETTE: JST3; B03B-PASK
TX: LEDCHIP-LED0805; CHIP-LED0805
U1: MAX3232EID; SOIC127P600X175-16N
U2: TCA9548APWR; SOP65P640X120-24N
VCC_IN: JST2; B02B-PASK
X1: D-SUB9-H5M09RA; H5M09RA

Connections:
+3V3: 3.3V.A, C1.1, C6.1, COLOR1.P$1 (1), COLOR2.P$1 (1), COLOR3.P$1 (1), COLOR4.P$1 (1), MDB.P$1 (1), PWM0.P$1 (1), PWM1.P$1 (1), R3.1, R4.1, R5.1, SV1.1, SV1.17, SW1.1, SW1.2, SW1.3, TIRETTE.P$1 (1), U1.16 (VCC), U2.24 (VCC)
+5V: 5V.A, D1.C, IN_5V.P1.1, IN_5V.P1.2, LEDS.P$1 (1), SV1.2, SV1.4
+12V: 12V.A, IN_12V.P1.1, IN_12V.P1.2, PUMP1.P$1 (1), PUMP2.P$1 (1), PUMP3.P$1 (1), PUMP4.P$1 (1), PUMP5.P$1 (1), PUMP6.P$1 (1), PUMP7.P$1 (1), PUMP8.P$1 (1), R16.1
EV1: PUMP1.P$3 (3), SV1.12
EV2: PUMP2.P$3 (3), SV1.16
EV3: PUMP3.P$3 (3), SV1.18
EV4: PUMP4.P$3 (3), SV1.22
EV5: PUMP5.P$3 (3), SV1.24
EV6: PUMP6.P$3 (3), SV1.26
EV7: PUMP7.P$3 (3), SV1.36
EV8: PUMP8.P$3 (3), SV1.38
GND: C1.2, C2.2, C5.1, C6.2, COLOR1.P$4 (4), COLOR2.P$4 (4), COLOR3.P$4 (4), COLOR4.P$4 (4), D1.A, IN_5V.P2.1, IN_5V.P2.2, IN_12V.P2.1, IN_12V.P2.2, LEDS.P$3 (3), MDB.P$5 (5), PUMP1.P$4 (4), PUMP2.P$4 (4), PUMP3.P$4 (4), PUMP4.P$4 (4), PUMP5.P$4 (4), PUMP6.P$4 (4), PUMP7.P$4 (4), PUMP8.P$4 (4), PWM0.P$3 (3), PWM1.P$3 (3), R1.1, R2.1, R6.2, R7.2, R8.2, R9.1, R10.1, R11.1, R12.2, R13.2, R14.2, R15.2, R17.2, R26.2, SV1.6, SV1.9, SV1.14, SV1.20, SV1.25, SV1.30, SV1.34, SV1.39, TIRETTE.P$3 (3), U1.15 (GND), U2.12 (GND), VCC_IN.P$2 (2), X1.5
GPIO0: SV1.27
GPIO1: SV1.28
GPIO21: BAU.A, R16.2, R17.1, SV1.40
INT_MDB: MDB.P$4 (4), SV1.7
LEDS: GPIO10.A, LEDS.P$2 (2), SV1.19
unnamed: C3.1, U1.1 (C1+)
unnamed: C2.1, U1.2 (V+)
unnamed: C3.2, U1.3 (C1-)
unnamed: C4.1, U1.4 (C2+)
unnamed: C4.2, U1.5 (C2-)
unnamed: C5.2, U1.6 (V-)
unnamed: U1.7 (DOUT2), X1.3
unnamed: R1.2, TX.C
unnamed: 5V.C, R9.2
unnamed: 3.3V.C, R10.2
unnamed: 12V.C, R11.2
unnamed: LED_TIRETTE.C, R26.1
unnamed: R2.2, RX.C
unnamed: BAU.C, R14.1
unnamed: P0.C, R15.1
unnamed: R5.2, U2.3 (!RESET)
unnamed: R8.1, SW1.4, U2.21 (A2)
unnamed: R7.1, SW1.5, U2.2 (A1)
unnamed: R6.1, SW1.6, U2.1 (A0)
unnamed: VCC_IN.P$1 (1), X1.4
unnamed: GPIO10.C, R12.1
unnamed: P1.C, R13.1
PUMP1: PUMP1.P$2 (2), SV1.13
PUMP2: PUMP2.P$2 (2), SV1.15
PUMP3: PUMP3.P$2 (2), SV1.21
PUMP4: PUMP4.P$2 (2), SV1.23
PUMP5: PUMP5.P$2 (2), SV1.29
PUMP6: PUMP6.P$2 (2), SV1.31
PUMP7: PUMP7.P$2 (2), SV1.35
PUMP8: PUMP8.P$2 (2), SV1.37
PWM0: P0.A, PWM0.P$2 (2), SV1.32
PWM1: P1.A, PWM1.P$2 (2), SV1.33
RX: RX.A, SV1.10, U1.9 (ROUT2)
RX_IN: U1.8 (RIN2), X1.2
SCL: MDB.P$3 (3), R3.2, SV1.5, U2.22 (SCL)
SCL0: COLOR1.P$3 (3), U2.5 (SC0)
SCL1: COLOR2.P$3 (3), U2.7 (SC1)
SCL2: COLOR3.P$3 (3), U2.9 (SC2)
SCL3: COLOR4.P$3 (3), U2.11 (SC3)
SDA: MDB.P$2 (2), R4.2, SV1.3, U2.23 (SDA)
SDA0: COLOR1.P$2 (2), U2.4 (SD0)
SDA1: COLOR2.P$2 (2), U2.6 (SD1)
SDA2: COLOR3.P$2 (2), U2.8 (SD2)
SDA3: COLOR4.P$2 (2), U2.10 (SD3)
TIRETTE: LED_TIRETTE.A, SV1.11, TIRETTE.P$2 (2)
TX: SV1.8, TX.A, U1.10 (DIN2)

Notes on the sheet:
POWER IN
LEDS POWER
GPIOS RASPBERRY
PUMPS
SERIAL
I2C MULTIPLEXING
COLOR SENSORS
MDB
OTHER I/O
Carte IO Raspberry Pi V3.2

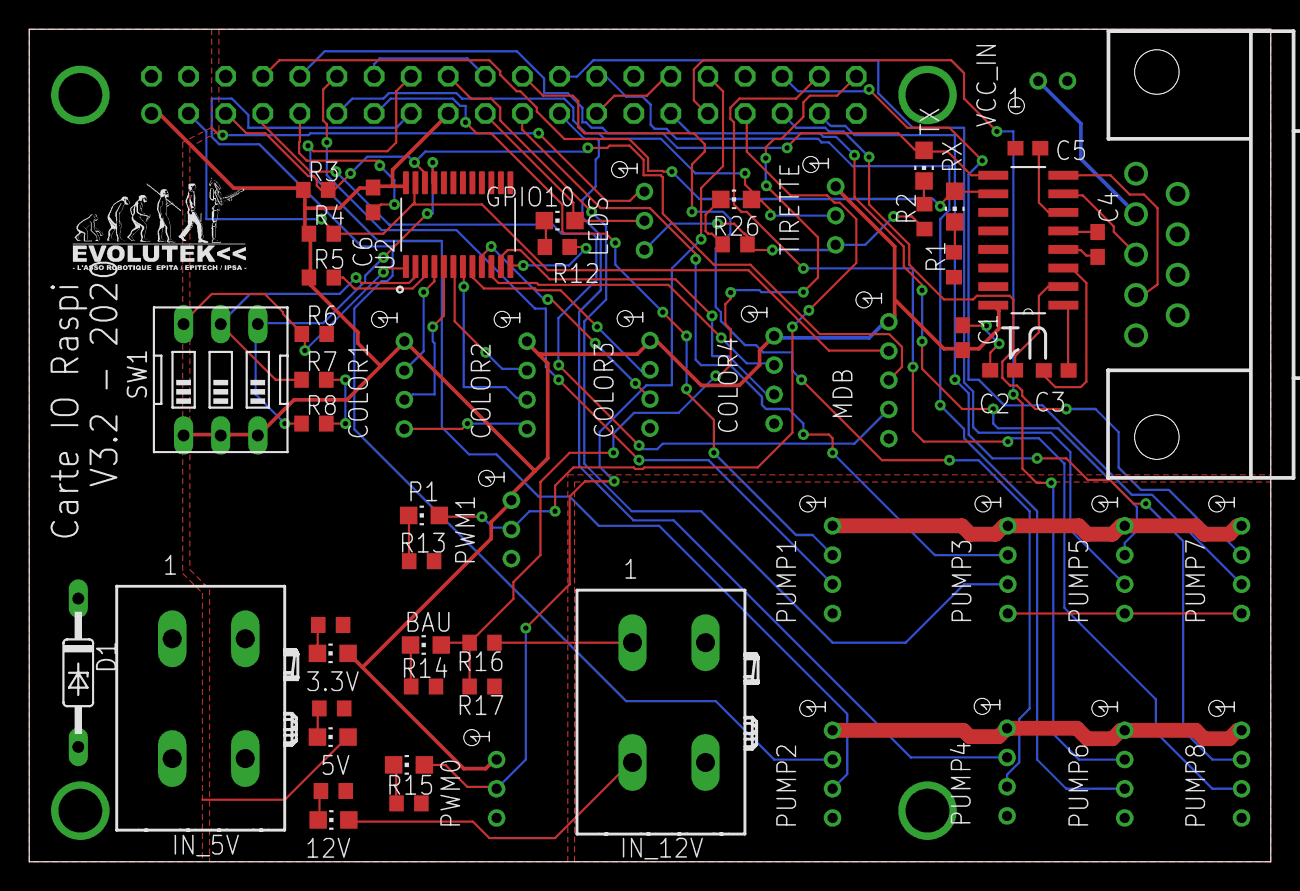
[picture p34: board CarteIO V3/Board.brd from above]

Board: 2 copper layers, 85.0 x 57.0 mm, 60 parts (1 on the bottom side), 61 nets.
