evolutek/carte-io-raspberry-pi/CarteIO V2/Board.brd

## EAGLE design CarteIO V2/Board.brd (2019-03-14, an earlier design)

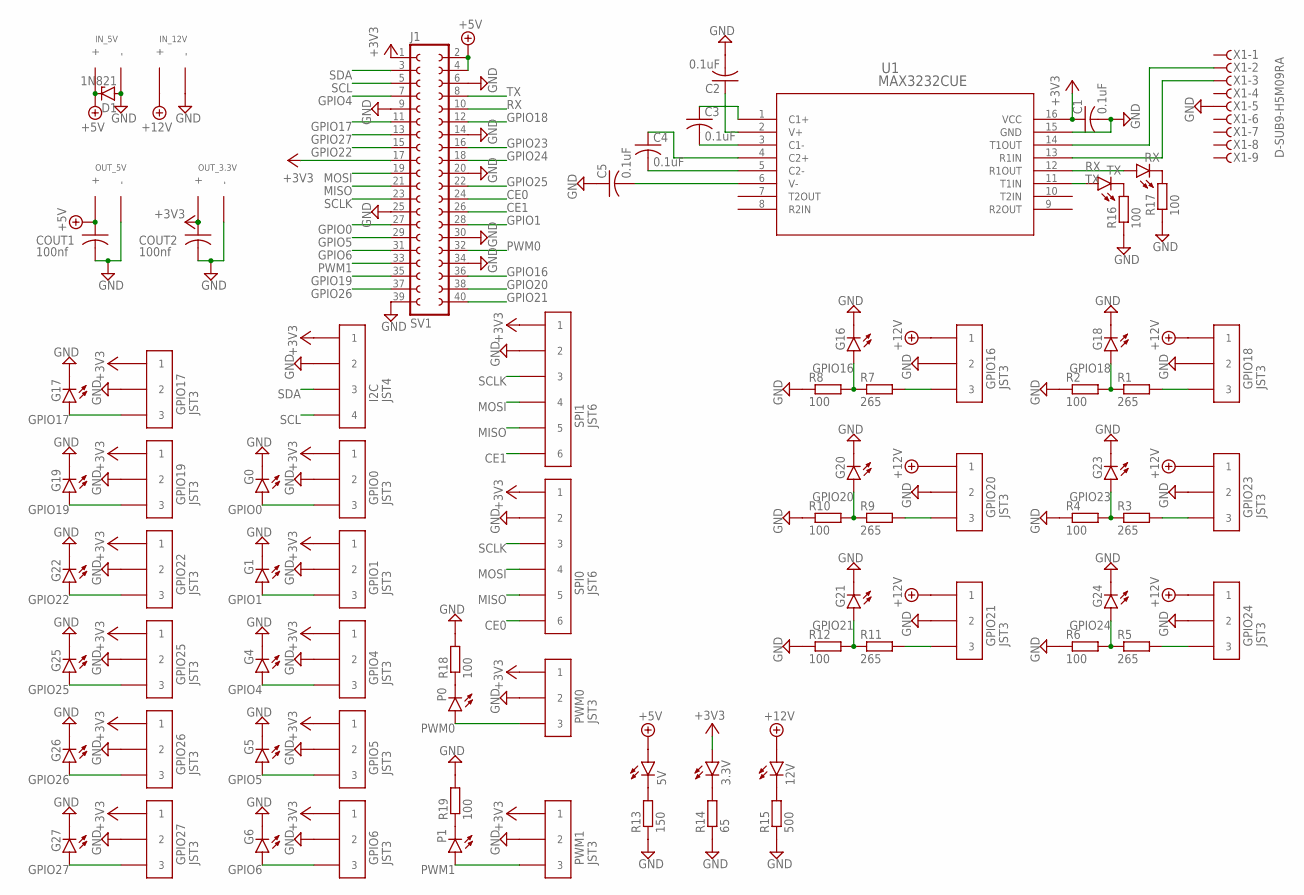
[picture p35: schematic Board.sch]

Parts:
3.3V, 5V, 12V: LEDCHIP-LED0805; CHIP-LED0805
C1, C2, C3, C4, C5: 0.1uF; C0603
COUT1, COUT2: 100nf; C0603
D1: 1N821; DO35Z10
G0, G1, G4, G5, G6, G16, G17, G18, G19, G20, G21, G22, G23, G24, G25, G26, G27: LEDCHIP-LED0805; CHIP-LED0805
GPIO0, GPIO1, GPIO4, GPIO5, GPIO6, GPIO16, GPIO17, GPIO18, GPIO19, GPIO20, GPIO21, GPIO22, GPIO23, GPIO24, GPIO25, GPIO26, GPIO27: JST3; B03B-PASK
I2C: JST4; B04B-PASK
IN_5V, IN_12V: WAGO-2604-3304
OUT_3.3V, OUT_5V: WAGO-2604-3304
P0, P1: LEDCHIP-LED0805; CHIP-LED0805
PWM0, PWM1: JST3; B03B-PASK
R1, R3, R5, R7, R9, R11: 265; R0603
R2, R4, R6, R8, R10, R12, R16, R17, R18, R19: 100; R0603
R13: 150; R0603
R14: 65; R0603
R15: 500; R0603
RX: LEDCHIP-LED0805; CHIP-LED0805
SPI0, SPI1: JST6; B06B-PASK
SV1: J1; FE20-2
TX: LEDCHIP-LED0805; CHIP-LED0805
U1: MAX3232CUE; 21-0066J_16
X1: D-SUB9-H5M09RA; H5M09RA

Connections:
+3V3: 3.3V.A, C1.1, COUT2.1, GPIO0.P$1 (1), GPIO1.P$1 (1), GPIO4.P$1 (1), GPIO5.P$1 (1), GPIO6.P$1 (1), GPIO17.P$1 (1), GPIO19.P$1 (1), GPIO22.P$1 (1), GPIO25.P$1 (1), GPIO26.P$1 (1), GPIO27.P$1 (1), I2C.P$1 (1), OUT_3.3V.P$1 (+), OUT_3.3V.P$2 (+), PWM0.P$1 (1), PWM1.P$1 (1), SPI0.P$1 (1), SPI1.P$1 (1), SV1.1, SV1.17, U1.16 (VCC)
+5V: 5V.A, COUT1.1, D1.C, IN_5V.P$1 (+), IN_5V.P$2 (+), OUT_5V.P$1 (+), OUT_5V.P$2 (+), SV1.2, SV1.4
+12V: 12V.A, GPIO16.P$1 (1), GPIO18.P$1 (1), GPIO20.P$1 (1), GPIO21.P$1 (1), GPIO23.P$1 (1), GPIO24.P$1 (1), IN_12V.P$1 (+), IN_12V.P$2 (+)
CE0: SPI0.P$6 (6), SV1.24
CE1: SPI1.P$6 (6), SV1.26
GND: C1.2, C2.2, C5.1, COUT1.2, COUT2.2, D1.A, G0.C, G1.C, G4.C, G5.C, G6.C, G16.C, G17.C, G18.C, G19.C, G20.C, G21.C, G22.C, G23.C, G24.C, G25.C, G26.C, G27.C, GPIO0.P$2 (2), GPIO1.P$2 (2), GPIO4.P$2 (2), GPIO5.P$2 (2), GPIO6.P$2 (2), GPIO16.P$2 (2), GPIO17.P$2 (2), GPIO18.P$2 (2), GPIO19.P$2 (2), GPIO20.P$2 (2), GPIO21.P$2 (2), GPIO22.P$2 (2), GPIO23.P$2 (2), GPIO24.P$2 (2), GPIO25.P$2 (2), GPIO26.P$2 (2), GPIO27.P$2 (2), I2C.P$2 (2), IN_5V.P$3 (-), IN_5V.P$4 (-), IN_12V.P$3 (-), IN_12V.P$4 (-), OUT_3.3V.P$3 (-), OUT_3.3V.P$4 (-), OUT_5V.P$3 (-), OUT_5V.P$4 (-), PWM0.P$2 (2), PWM1.P$2 (2), R2.1, R4.1, R6.1, R8.1, R10.1, R12.1, R13.1, R14.1, R15.1, R16.1, R17.1, R18.2, R19.2, SPI0.P$2 (2), SPI1.P$2 (2), SV1.6, SV1.9, SV1.14, SV1.20, SV1.25, SV1.30, SV1.34, SV1.39, U1.15 (GND), X1.5
GPIO0: G0.A, GPIO0.P$3 (3), SV1.27
GPIO1: G1.A, GPIO1.P$3 (3), SV1.28
GPIO4: G4.A, GPIO4.P$3 (3), SV1.7
GPIO5: G5.A, GPIO5.P$3 (3), SV1.29
GPIO6: G6.A, GPIO6.P$3 (3), SV1.31
GPIO16: G16.A, R7.1, R8.2, SV1.36
GPIO17: G17.A, GPIO17.P$3 (3), SV1.11
GPIO18: G18.A, R1.1, R2.2, SV1.12
GPIO19: G19.A, GPIO19.P$3 (3), SV1.35
GPIO20: G20.A, R9.1, R10.2, SV1.38
GPIO21: G21.A, R11.1, R12.2, SV1.40
GPIO22: G22.A, GPIO22.P$3 (3), SV1.15
GPIO23: G23.A, R3.1, R4.2, SV1.16
GPIO24: G24.A, R5.1, R6.2, SV1.18
GPIO25: G25.A, GPIO25.P$3 (3), SV1.22
GPIO26: G26.A, GPIO26.P$3 (3), SV1.37
GPIO27: G27.A, GPIO27.P$3 (3), SV1.13
MISO: SPI0.P$5 (5), SPI1.P$5 (5), SV1.21
MOSI: SPI0.P$4 (4), SPI1.P$4 (4), SV1.19
unnamed: C3.1, U1.1 (C1+)
unnamed: C2.1, U1.2 (V+)
unnamed: C3.2, U1.3 (C1-)
unnamed: C4.1, U1.4 (C2+)
unnamed: C4.2, U1.5 (C2-)
unnamed: C5.2, U1.6 (V-)
unnamed: U1.13 (R1IN), X1.3
unnamed: U1.14 (T1OUT), X1.2
unnamed: 5V.C, R13.2
unnamed: 3.3V.C, R14.2
unnamed: 12V.C, R15.2
unnamed: R16.2, TX.C
unnamed: R17.2, RX.C
unnamed: GPIO18.P$3 (3), R1.2
unnamed: GPIO23.P$3 (3), R3.2
unnamed: GPIO24.P$3 (3), R5.2
unnamed: GPIO16.P$3 (3), R7.2
unnamed: GPIO20.P$3 (3), R9.2
unnamed: GPIO21.P$3 (3), R11.2
unnamed: P0.C, R18.1
unnamed: P1.C, R19.1
PWM0: P0.A, PWM0.P$3 (3), SV1.32
PWM1: P1.A, PWM1.P$3 (3), SV1.33
RX: RX.A, SV1.10, U1.12 (R1OUT)
SCL: I2C.P$4 (4), SV1.5
SCLK: SPI0.P$3 (3), SPI1.P$3 (3), SV1.23
SDA: I2C.P$3 (3), SV1.3
TX: SV1.8, TX.A, U1.11 (T1IN)

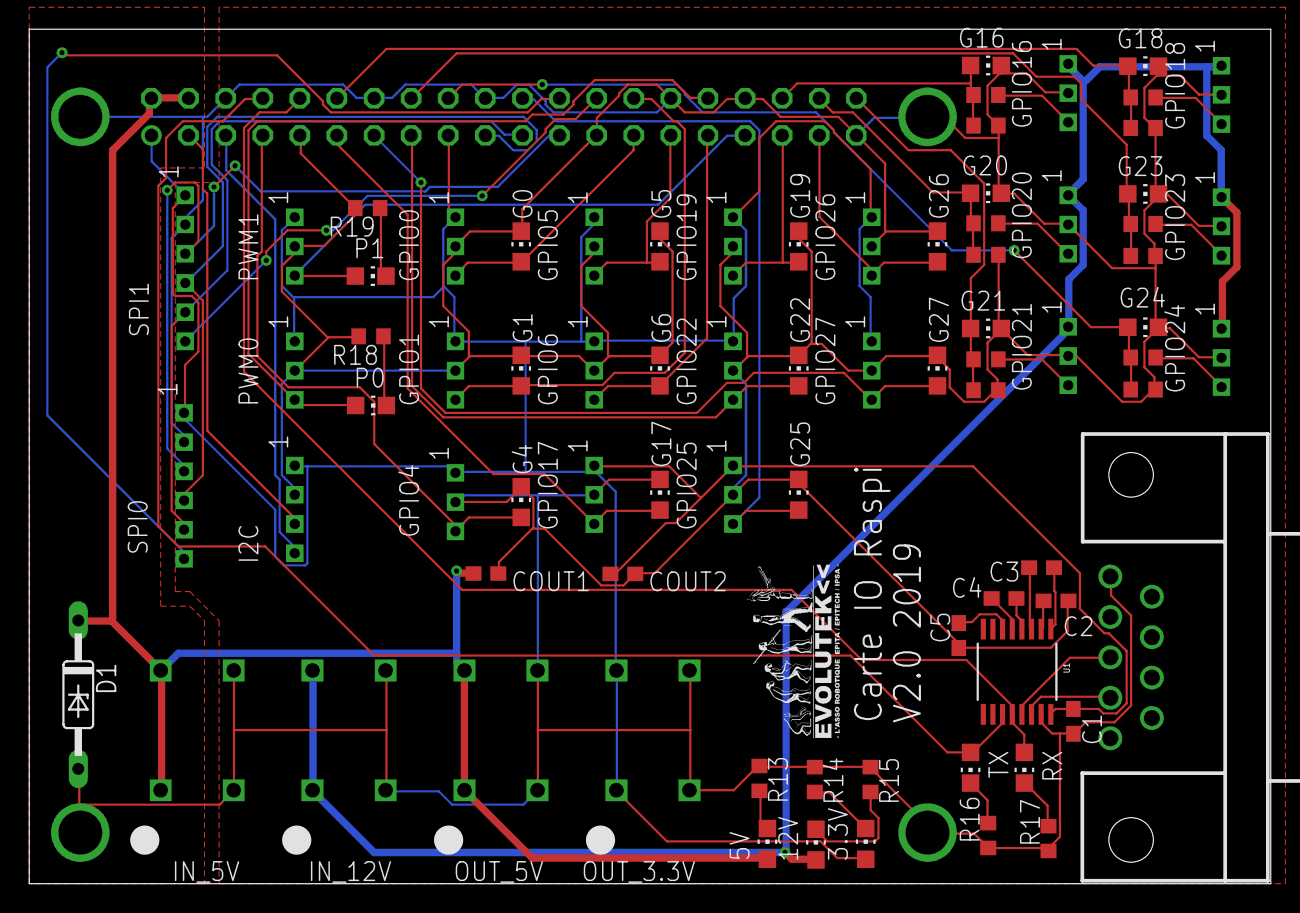
[picture p36: board CarteIO V2/Board.brd from above]

Board: 2 copper layers, 85.0 x 58.5 mm, 80 parts (1 on the bottom side), 53 nets.
