evolutek/carte-io-raspberry-pi/CarteIO V1/Board.brd

## EAGLE design CarteIO V1/Board.brd (2019-01-15, an earlier design)

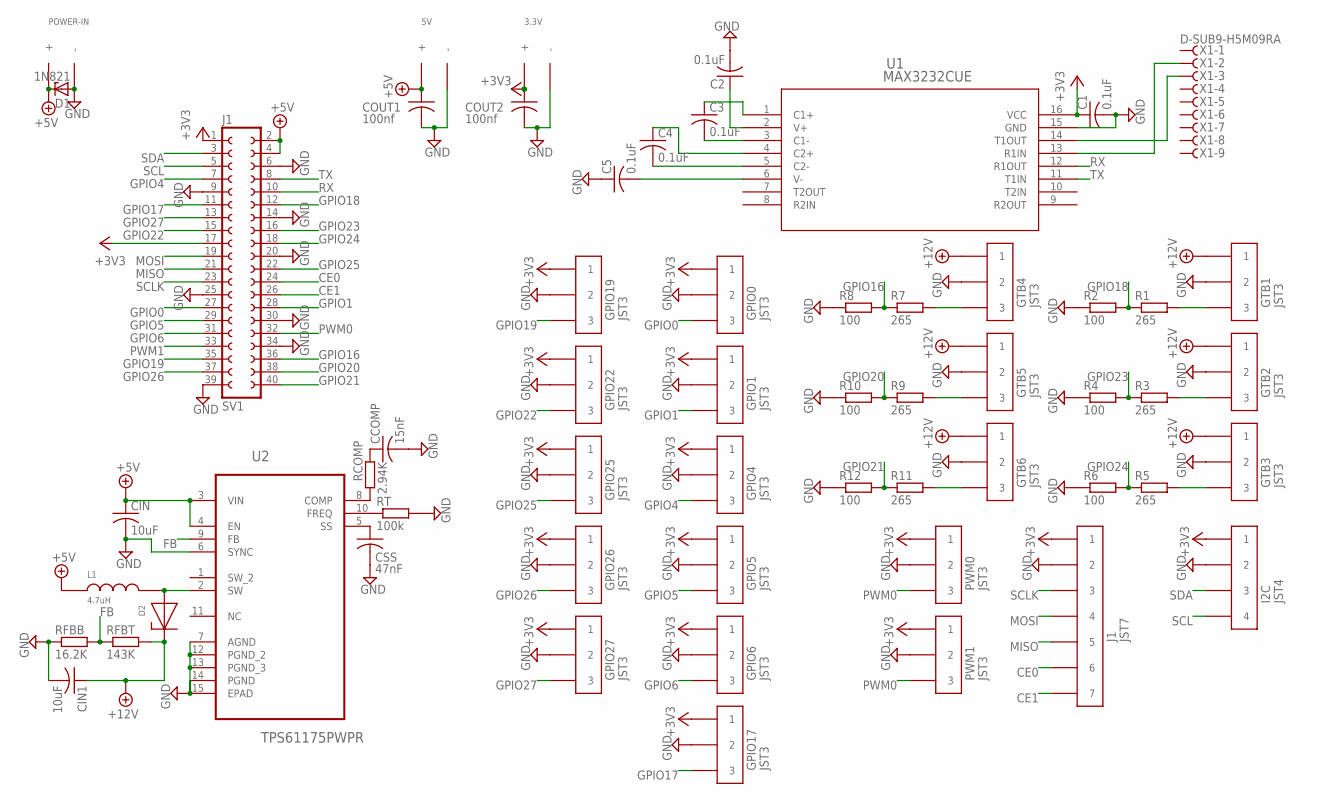
[picture p37: schematic Board.sch]

Parts:
3.3V, 5V: WAGO-2604-3304
C1, C2, C3, C4, C5: 0.1uF; C0603
CCOMP: 15nF; C0603
CIN, CIN1: 10uF; C0603
COUT1, COUT2: 100nf; C0603
CSS: 47nF; C0603
D1: 1N821; DO35Z10
D2: B540C-13-F
GPIO0, GPIO1, GPIO4, GPIO5, GPIO6, GPIO17, GPIO19, GPIO22, GPIO25, GPIO26, GPIO27: JST3; B03B-PASK
GTB1, GTB2, GTB3, GTB4, GTB5, GTB6: JST3; B03B-PASK
I2C: JST4; B04B-PASK
J1: JST7; B07B-PASK
L1: 4.7uH; XAL4030-472MEB
POWER-IN: WAGO-2604-3304
PWM0, PWM1: JST3; B03B-PASK
R1, R3, R5, R7, R9, R11: 265; R0603
R2, R4, R6, R8, R10, R12: 100; R0603
RCOMP: 2.94K; R0603
RFBB: 16.2K; R0603
RFBT: 143K; R0603
RT: 100k; R0603
SV1: J1; FE20-2
U1: MAX3232CUE; 21-0066J_16
U2: TPS61175PWPR; SOP65P640X120-15N
X1: D-SUB9-H5M09RA; H5M09RA

Connections:
+3V3: 3.3V.P$1 (+), 3.3V.P$2 (+), C1.1, COUT2.1, GPIO0.P$1 (1), GPIO1.P$1 (1), GPIO4.P$1 (1), GPIO5.P$1 (1), GPIO6.P$1 (1), GPIO17.P$1 (1), GPIO19.P$1 (1), GPIO22.P$1 (1), GPIO25.P$1 (1), GPIO26.P$1 (1), GPIO27.P$1 (1), I2C.P$1 (1), J1.P$1 (1), PWM0.P$1 (1), PWM1.P$1 (1), SV1.1, SV1.17, U1.16 (VCC)
+5V: 5V.P$1 (+), 5V.P$2 (+), CIN.1, COUT1.1, D1.C, L1.P$1, POWER-IN.P$1 (+), POWER-IN.P$2 (+), SV1.2, SV1.4, U2.3 (VIN), U2.4 (EN)
+12V: CIN1.1, D2.C (B), GTB1.P$1 (1), GTB2.P$1 (1), GTB3.P$1 (1), GTB4.P$1 (1), GTB5.P$1 (1), GTB6.P$1 (1), RFBT.2
CE0: J1.P$6 (6), SV1.24
CE1: J1.P$7 (7), SV1.26
FB: RFBB.2, RFBT.1, U2.9 (FB)
GND: 3.3V.P$3 (-), 3.3V.P$4 (-), 5V.P$3 (-), 5V.P$4 (-), C1.2, C2.2, C5.1, CCOMP.2, CIN.2, CIN1.2, COUT1.2, COUT2.2, CSS.2, D1.A, GPIO0.P$2 (2), GPIO1.P$2 (2), GPIO4.P$2 (2), GPIO5.P$2 (2), GPIO6.P$2 (2), GPIO17.P$2 (2), GPIO19.P$2 (2), GPIO22.P$2 (2), GPIO25.P$2 (2), GPIO26.P$2 (2), GPIO27.P$2 (2), GTB1.P$2 (2), GTB2.P$2 (2), GTB3.P$2 (2), GTB4.P$2 (2), GTB5.P$2 (2), GTB6.P$2 (2), I2C.P$2 (2), J1.P$2 (2), POWER-IN.P$3 (-), POWER-IN.P$4 (-), PWM0.P$2 (2), PWM1.P$2 (2), R2.1, R4.1, R6.1, R8.1, R10.1, R12.1, RFBB.1, RT.2, SV1.6, SV1.9, SV1.14, SV1.20, SV1.25, SV1.30, SV1.34, SV1.39, U1.15 (GND), U2.6 (SYNC), U2.7 (AGND), U2.12 (PGND_2), U2.13 (PGND_3), U2.14 (PGND), U2.15 (EPAD)
GPIO0: GPIO0.P$3 (3), SV1.27
GPIO1: GPIO1.P$3 (3), SV1.28
GPIO4: GPIO4.P$3 (3), SV1.7
GPIO5: GPIO5.P$3 (3), SV1.29
GPIO6: GPIO6.P$3 (3), SV1.31
GPIO16: R7.1, R8.2, SV1.36
GPIO17: GPIO17.P$3 (3), SV1.11
GPIO18: R1.1, R2.2, SV1.12
GPIO19: GPIO19.P$3 (3), SV1.35
GPIO20: R9.1, R10.2, SV1.38
GPIO21: R11.1, R12.2, SV1.40
GPIO22: GPIO22.P$3 (3), SV1.15
GPIO23: R3.1, R4.2, SV1.16
GPIO24: R5.1, R6.2, SV1.18
GPIO25: GPIO25.P$3 (3), SV1.22
GPIO26: GPIO26.P$3 (3), SV1.37
GPIO27: GPIO27.P$3 (3), SV1.13
MISO: J1.P$5 (5), SV1.21
MOSI: J1.P$4 (4), SV1.19
unnamed: C3.1, U1.1 (C1+)
unnamed: C2.1, U1.2 (V+)
unnamed: C3.2, U1.3 (C1-)
unnamed: C4.1, U1.4 (C2+)
unnamed: C4.2, U1.5 (C2-)
unnamed: C5.2, U1.6 (V-)
unnamed: U1.13 (R1IN), X1.2
unnamed: U1.14 (T1OUT), X1.3
unnamed: D2.A, L1.P$2, U2.2 (SW)
unnamed: RT.1, U2.10 (FREQ)
unnamed: RCOMP.1, U2.8 (COMP)
unnamed: CCOMP.1, RCOMP.2
unnamed: CSS.1, U2.5 (SS)
unnamed: GTB1.P$3 (3), R1.2
unnamed: GTB2.P$3 (3), R3.2
unnamed: GTB3.P$3 (3), R5.2
unnamed: GTB4.P$3 (3), R7.2
unnamed: GTB5.P$3 (3), R9.2
unnamed: GTB6.P$3 (3), R11.2
PWM0: PWM0.P$3 (3), PWM1.P$3 (3), SV1.32
PWM1: SV1.33
RX: SV1.10, U1.12 (R1OUT)
SCL: I2C.P$4 (4), SV1.5
SCLK: J1.P$3 (3), SV1.23
SDA: I2C.P$3 (3), SV1.3
TX: SV1.8, U1.11 (T1IN)

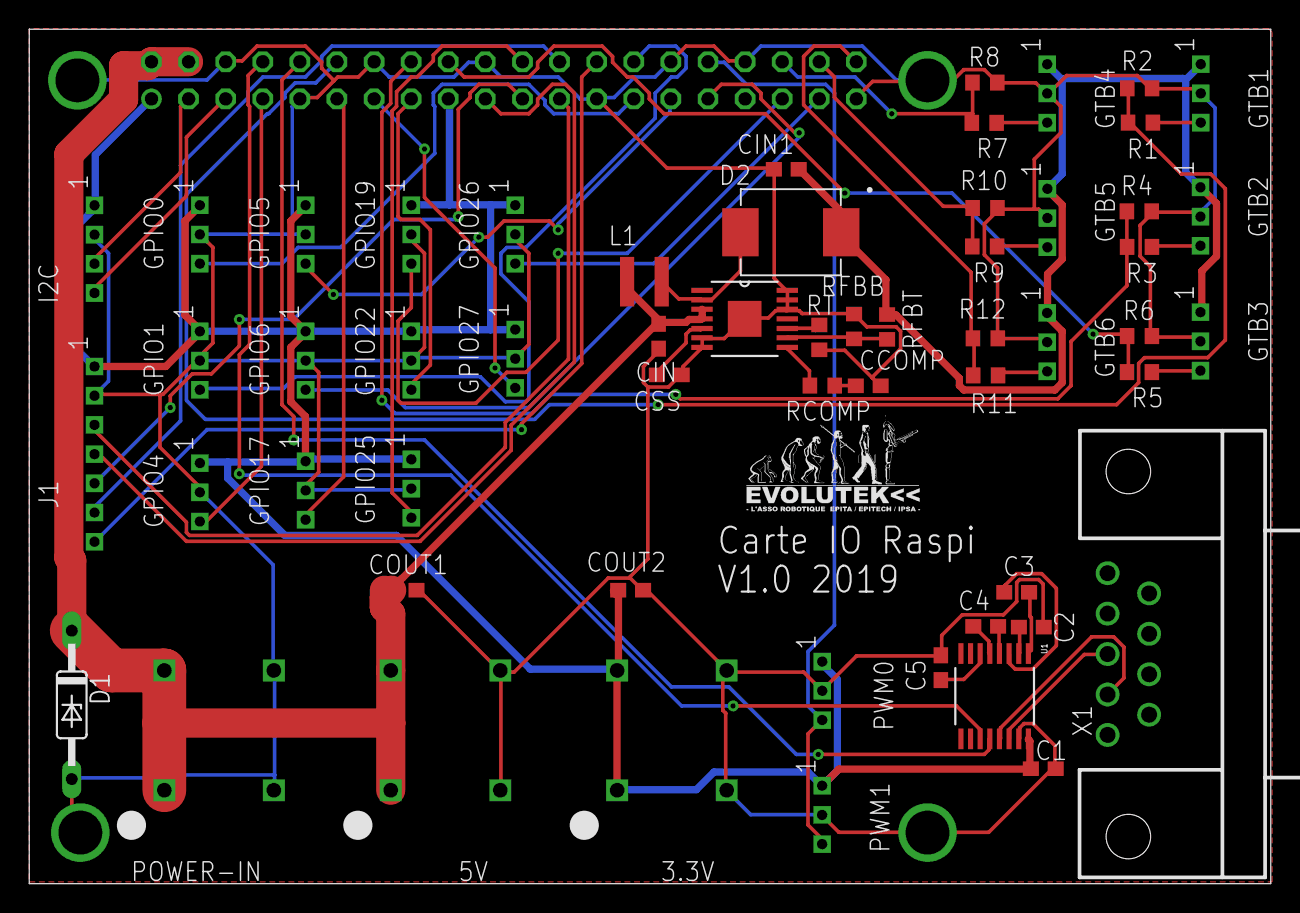
[picture p38: board CarteIO V1/Board.brd from above]

Board: 2 copper layers, 85.0 x 58.5 mm, 58 parts (1 on the bottom side), 51 nets.
