evolutek/carte-io-raspberry-pi/(commit log)

2019-01-08 Add Carte IO V1
    [Schematics.sch]
2019-01-09 Add 12V regulator on the sch
    [Schematics.sch]
2019-01-09 Add GTB ports
    [Schematics.sch]
2019-01-11 Finish Schematics
    [Schematics.sch]
2019-01-11 Pcb not finished
    [Schematics.brd]
2019-01-15 PCB is done, need to check serial connector
    [Schematics.brd, Schematics.sch]
2019-01-15 Finish Board and remove useless files
    [Board.brd, Board.sch]
2019-03-12 Add Carte IO v2
    [Board.sch]
2019-03-12 Add leds and correct mistakes on serial connection
    [Board.sch]
2019-03-12 Add JST6 and correct wago connector
2019-03-14 Add V2 of the IO board
    [Board.brd, Board.sch]
2019-03-17 Clean files and add Gerber files for V2
2019-12-26 [V3] Add a new version, need to check and make 3D model
    [Board.brd, Board.sch]
2019-12-28 [V3] Add 3D model, card checked
    [Board.brd, Board.sch]
2020-01-24 [V3.0] Release
    [Board.brd, Board.sch]
2020-01-24 [3.0] Release
    [Board.brd, Board.sch]
2020-03-21 [3.2] Release
    [Board.brd, Board.sch]
2020-03-29 [V3.2] Patch error on PCB
    [Board.brd]
2020-04-10 [V3.2] Change led strip port and add a color sensor port
    [Board.brd, Board.sch]
2020-04-16 [V3.2] Correct a bad routing on color sensor 1
    [Board.brd, Board.sch]
2020-04-20 [V3.2] Correct I2C Multiplexer rooting
    [Board.brd]
2020-09-04 CarteIO Beacon V1 + Add lib SEAL
    [Board.brd, Board.sch, Board.step]
2021-01-03 Started shield IO v4
    [CarteIO_V4.kicad_pcb, CarteIO_V4.sch]
2021-01-03 Schematic almost done
    [CarteIO_V4.sch]
2021-01-05 Started second disposition
    [CarteIO_V4.kicad_pcb, CarteIO_V4.sch]
2021-01-05 CarteIO V4 PCB almost done
    [CarteIO_V4.kicad_pcb]
2021-01-07 Third version of the shield IO v4
    [CarteIO_V4.kicad_pcb, CarteIO_V4.sch]
2021-01-07 Planes improvements
    [CarteIO_V4.kicad_pcb]
2021-01-07 Some fixes on V4.0 board
    [CarteIO_V4.kicad_pcb, CarteIO_V4.sch]
2021-01-14 Added 3.3V LDO + Lidar connector
    [CarteIO_V4.kicad_pcb, CarteIO_V4.sch]
2021-01-24 Added buzzer and power board conn, started rerouting
    [CarteIO_V4.kicad_pcb, CarteIO_V4.sch]
2021-01-25 Bottom of the PCB done
    [CarteIO_V4.kicad_pcb, CarteIO_V4.sch]
2021-01-28 Shield IO V4 done
    [CarteIO_V4.kicad_pcb, CarteIO_V4.sch]
2021-01-31 Bom, gerber, pdf, step
    [CarteIO_V4.kicad_pcb]
2021-02-28 Big 5V to CAN + Fixed bicolor led
    [CarteIO_V4.kicad_pcb, CarteIO_V4.sch]
2021-03-28 Pulldown Buzzer pin
    [CarteIO_V4.kicad_pcb, CarteIO_V4.sch]
2021-03-29 Shield V4.1
    [CarteIO_V4.kicad_pcb]
2021-03-31 Fixes V1.1 + 3rd CAN
    [CarteIO_V4.kicad_pcb, CarteIO_V4.sch]
2021-04-01 Release V4.1
    [CarteIO_V4.kicad_pcb, CarteIO_V4.sch]
2021-04-05 Add CarteIO Beacon V2
    [CarteIO Beacon V2.kicad_pcb, CarteIO Beacon V2.sch]
2021-04-05 Update production file for V4
    [CarteIO_V4.kicad_pcb]
2021-04-05 Update production file for CarteIO Beacon V2
    [CarteIO Beacon V2.kicad_pcb]
2021-04-06 Minor fix
    [CarteIO_V4.kicad_pcb]
2022-03-16 Release V5
    [CarteIO_V5.kicad_pcb, CarteIO_V5.sch]
2022-05-01 Fix V5
    [CarteIO_V5.kicad_pcb, CarteIO_V5.sch]
2022-06-15 Add bom
2023-03-04 Wip V6
    [CarteIO_V6.kicad_pcb, CarteIO_V6.kicad_sch, CarteIO_V6.sch]
2023-03-05 Wip V6.0
    [CarteIO_V6.kicad_pcb, CarteIO_V6.kicad_sch, CarteIO_V6.sch]
2023-03-06 First version of V6.0
    [CarteIO_V6.kicad_pcb]
2023-03-08 Add comment in schematics and add CM logo
    [CarteIO_V6.kicad_pcb, CarteIO_V6.kicad_sch]
2023-03-15 Fix bom
    [CarteIO_V6.kicad_pcb, CarteIO_V6.kicad_sch]
2023-07-21 Carte IO Beacon V3.1
    [CarteIO Beacon V3.kicad_pcb, CarteIO Beacon V3.kicad_sch]
2023-07-29 Add Camera Aux connector to Carte IO Beacon V3
    [CarteIO Beacon V3.kicad_pcb, CarteIO Beacon V3.kicad_sch]
2023-08-18 Add jumper to select output voltage of the Camera Aux connector
    [CarteIO Beacon V3.kicad_pcb, CarteIO Beacon V3.kicad_sch]
2023-08-18 Add filtering for connected signal
    [CarteIO Beacon V3.kicad_pcb, CarteIO Beacon V3.kicad_sch]
2024-03-09 Carte IO Beacon V3.3
    [CarteIO Beacon V3.kicad_pcb, CarteIO Beacon V3.kicad_sch]
2024-03-17 Add decoupling on OR gate VCC
    [CarteIO Beacon V3.kicad_pcb, CarteIO Beacon V3.kicad_sch]
2024-03-18 Carte IO Coffee Pot V1.0
    [carte-io-coffee-pot.kicad_pcb, carte-io-coffee-pot.kicad_sch]
2024-03-18 Regenerate schematics
